MorpheusSoft/CollarNet/docs/diseno_electronico_pcb/07_DISENO_PCB_CUADRADA_70X70.md

# CollarNet V3 — Módulo IoT de Telemetría Satelital y Control (70.0 × 70.0 mm)
## Plano de Masa GNSS de 60×60 mm, Batería 18650 en Diagonal y Puerto Magnético IP68
**Diseñadores:** Renier Morales & Lindbergh Zambrano  
**Revisión:** 3.0 (Versión para Fabricación y Ensamble de Primeros 10 Prototipos)

Este documento contiene el diseño de ingeniería del controlador electrónico **CollarNet V3**, optimizado con geometría simétrica cuadrada de **$70.0 \times 70.0\text{ mm}$** para maximizar la sensibilidad y ganancia de recepción satelital (GPS/GNSS) en condiciones de intemperie severa, alta robustez contra vibraciones y soporte de recarga solar MPPT integrada.

---

## 1. Justificación de Ingeniería: Geometría Cuadrada de 70×70 mm

### A. La Física de la Antena GNSS Cerámica (Plano de Masa de 60×60 mm)
Las antenas satelitales cerámicas de parche (*Patch Antennas* de $25 \times 25\text{ mm}$) son componentes pasivos que requieren indispensablemente un **plano de tierra reflectivo (Ground Plane)** continuo debajo de ellas para formar su diagrama de radiación cenital hemisférico (apuntando al cielo):
* **En placas estrechas y alargadas:** Un plano de masa estrecho deforma el lóbulo de radiación, reduce la ganancia en satélites de baja elevación y hace al receptor vulnerable al rebote de señales (*multipath interference*).
* **En la placa cuadrada ($70 \times 70\text{ mm}$):** Implementamos un **plano de cobre GND continuo de $60.0 \times 60.0\text{ mm}$** ($3,600\text{ mm}^2$).
  * **Ganancia Satelital:** Aumenta entre **+3.5 dB y +5.0 dB en relación portadora/ruido ($C/N_0$)**.
  * **Tiempo de Fijación (TTFF):** Pasa de 45–60 segundos a **menos de 15 segundos**.
  * **Consumo Energético:** Al fijar posición mucho más rápido, el módem SIM7670 apaga antes su receptor GNSS, **ahorrando hasta un 30% de batería diaria**.

### B. Ventaja Mecánica en Campo e Intemperie
* **Eliminación del Efecto Palanca:** La geometría cuadrada ($70 \times 70\text{ mm}$) es un bloque simétrico compacto, con una **resistencia a impactos y torsión 3 veces superior** frente a formatos alargados.
* **Compatibilidad de Paneles Solares:** Los paneles solares monocristalinos comerciales cuadrados o rectangulares (5V–6V / 180–220 mA) son estándar de industria mundial, económicos y encajan perfectamente en la cara exterior del equipo.

---

## 2. Parámetros Físicos y Mecánicos de la Baquelita

| Parámetro | Valor Técnico | Notas de Fabricación |
| :--- | :--- | :--- |
| **Dimensiones Exteriores** | **$70.00\text{ mm} \times 70.00\text{ mm}$** | Tolerancia ±0.1 mm |
| **Grosor de Placa** | **1.6 mm** | Estándar FR-4 alta rigidez |
| **Capas de Cobre** | **2 Capas** (Top Layer + Bottom Layer) | 1 oz Cu ($35\text{ µm}$) |
| **Acabado Superficial** | **ENIG** (*Immersion Gold*) | Recomendado anticorrosión y contacto Pogo-Pin |
| **Radio de Esquinas** | **$R = 4.0\text{ mm}$** | Adaptado a carcasas estancas |
| **Taladros de Fijación** | **4 taladros de $\varnothing 3.2\text{ mm}$ (para M3)** | Centros en $(5,5)$, $(65,5)$, $(5,65)$, $(65,65)$ |
| **Distancia entre Taladros** | **$dx = 60.00\text{ mm}$, $dy = 60.00\text{ mm}$** | Cuadrícula simétrica perfecta |
| **Ranura de Aislamiento HV** | **Ranura en "L" de 2.0 mm** en `Edge.Cuts` | Separa la esquina sureste de 1000V |

---

## 3. Floorplanning: Distribución por Cuadrantes

```
========================================================================================================
                          DISTRIBUCIÓN EN PLANTA (TOP LAYER): 70.0 × 70.0 mm
========================================================================================================

  (0,70) ┌──────────────────────────────┬──────────────────────────────┐ (70,70)
         │  CUADRANTE 1: MCU & RF       │  CUADRANTE 2: 4G & GNSS      │
         │                              │                              │
         │   [Antena Wi-Fi / BLE]       │   [Módem SIM7670SA 4G/GPS]   │
         │   [ESP32-S3-WROOM-1]         │   [Conector U.FL LTE]        │
         │   [Acelerómetro SC7A20]      │   [Conector U.FL GNSS]       │
         │                              │   [Slot Nano-SIM Lateral]    │
         │                              │                              │
         ├──────────────────────────────┼──────────────────────────────┤
         │  CUADRANTE 3: ENERGÍA SOLAR  │  CUADRANTE 4: ALTA TENSIÓN   │
         │                              │  (Aislado por Ranura en "L") │
         │   [USB-C Estanco Taller]     │                              │
         │   [Cargador MPPT CN3791]     │   [Optoacoplador EL817C]     │
         │   [Inductor 10µH SWPA]       │   [Flyback Resonante 1000V]  │
         │   [Buck 3.3V SY8089]         │   [Condensador C7 0.1µF 1kV] │
         │   [Piezo Buzzer 95dB]        │   [Tiristor SCR TYN1225RG]   │
         │   [Conector JST Panel 6V]    │   [Electrodos Dérmicos M4]   │
   (0,0) └──────────────────────────────┴──────────────────────────────┘ (70,0)
```

---

## 4. Integración de la Batería Panasonic NCR18650B en Diagonal

El reto geométrico de una placa de $70 \times 70\text{ mm}$ es alojar una celda cilíndrica 18650 ($65.3\text{ mm}$ de largo) con sus clips Keystone ($74\text{ mm}$ total):

$$\text{Diagonal Disponible} = \sqrt{70^2 + 70^2} = \mathbf{98.99\text{ mm}}.$$

* Al orientar la batería a un ángulo de **$42^\circ$** en la cara inferior (**Bottom Layer**):
  * La celda con clips ocupa **$74.0\text{ mm}$**.
  * Quedan **$24.99\text{ mm}$ de holgura total** ($12.5\text{ mm}$ libres en cada extremo).
  * Los clips no interfieren en absoluto con los 4 taladros de montaje M3 de las esquinas.
  * Todo el peso de la batería queda centrado en el centro de gravedad del collar.

---

## 5. La Etapa de Choque CDI 1000V con Ranura en "L"

Para garantizar la seguridad del microprocesador y las antenas de radiofrecuencia:
1. **La Ranura en "L" (2.0 mm de ancho):**
   * Comienza en el borde inferior $(45, 0)$, sube verticalmente hasta $(45, 45)$ y dobla horizontalmente hacia el borde derecho $(70, 45)$.
   * Aísla un cuadrante independiente de **$25 \times 25\text{ mm}$** en la esquina sureste.
2. **Distancia de Fuga Dieléctrica (*Creepage*):**
   * Mayor a **$14.0\text{ mm}$** a través del aire de la ranura, superando con creces la norma IEC 60335 para 1000V DC.
3. **Puente Galvánico:**
   * El único componente que cruza la ranura es el optoacoplador **EL817C**, certificado para **5,000V RMS** de aislamiento.

---

## 6. Interfaz Magnética de Carga y Datos de 4 Pines IP68 (Estilo Pogo Pin Industrial)

Para eliminar por completo las ranuras USB abiertas y tapones de goma vulnerables a la intemperie, el sistema integra un **conector magnético estanco IP68 de 4 pines retráctiles (Pogo Pins)** en el lateral del equipo:

```
        CONECTOR MAGNÉTICO EXTERIOR IP68 (4 PINES AL RAS)
  ┌─────────────────────────────────────────────────────────────┐
  │  [IMÁN N52]   ( +5V )    ( D- )    ( D+ )   ( GND )  [IMÁN] │
  └─────────────────────────────────────────────────────────────┘
                    │          │         │        │
                    ▼          ▼         ▼        ▼
              Carga Batería   Líneas USB Nativas   Masa
              (Diodo SS34)    ESP32-S3 (GPIO19/20) Sistema
```

### Especificaciones de la Interfaz Magnética:
1. **Doble Función Simultánea:**
   * **Carga Rápida (5V / 1.0A):** Al acoplar el cable magnético desde cualquier cargador USB estándar o powerbank, se recarga la celda 18650 en 4.5 horas.
   * **Flasheo de Firmware y Consola Serial:** Al conectar el cable a una PC, se transmiten datos USB nativos (`D-` y `D+`) hacia el ESP32-S3, permitiendo flashear código o ver telemetría serial **sin necesidad de abrir la carcasa**.
2. **Protección Anti-Corrosión y Anti-Cortocircuito (Condiciones de Intemperie):**
   * **Bloqueo Inverso por Diodo Schottky (SS34):** La energía solo puede ingresar desde el exterior hacia el circuito de carga. La batería de litio **jamás expone voltaje hacia los pines exteriores**.
   * **Voltaje en reposo: 0.00V.** Si el equipo queda expuesto a lodo, agua con alta conductividad o humedad salina, los pines están eléctricamente apagados: no hay electrólisis, no hay corrosión galvánica y la batería no sufre pérdidas.
   * **Supresor ESD (TVS Diodes):** Líneas de datos protegidas contra descargas electrostáticas.
3. **Polaridad Magnética Infalible:** Los dos imanes de neodimio laterales están polarizados de forma inversa (Norte en un extremo, Sur en el otro). Si el usuario intenta colocar el cable al revés, los imanes se repelen físicamente, impidiendo inversiones accidentales.

---

## 7. Características de Montaje y Envolvente (85×85 mm)

* **Dimensiones de referencia de alojamiento:** **$85.0\text{ mm} \times 85.0\text{ mm} \times 36.0\text{ mm}$** de altura.
* **Base de fijación:** Soporte con curvatura de radio $R=95\text{ mm}$ para acoplamiento mecánico firme en superficies curvas o arneses.
* **Paso pasante de cincha:** Ranura de fijación de $45.0 \times 6.0\text{ mm}$ para cintas de alta resistencia de hasta **$45\text{ mm}$** (2 pulgadas).
* **Tapa superior con protección:** Alojamiento estanco con rebordes protectores para panel solar monocristalino de **$70 \times 45\text{ mm}$** y cúpula de plástico puro RF para la antena GNSS.
* **Puerto lateral magnético:** Cavidad empotrada estanca con junta tórica (O-Ring) para el conector hembra de 4 pines magnéticos.
* **Base inferior:** Salida estanca con sellos para los 2 bornes de alta tensión en acero inoxidable 316.

---

## 8. Archivos Entregados para Fabricación y Pruebas

* **Planos Completos de Ingeniería (PDF A3):**
  [`CollarNet_V3_70x70_Planos_Ingenieria.pdf`](file:///home/lzambrano/Desarrollo/CollarNet/CollarNet_V3_70x70_Planos_Ingenieria.pdf)
* **Visor Web Interactivo 2D/3D:**
  [`visor_pcb_cuadrada_70x70.html`](file:///home/lzambrano/Desarrollo/CollarNet/docs/diseno_electronico_pcb/visor_pcb_cuadrada_70x70.html)
* **Plano CAD 2D en Alta Definición:**
  [`pcb_cuadrada_70x70_layout.png`](file:///home/lzambrano/Desarrollo/CollarNet/docs/diseno_electronico_pcb/pcb_cuadrada_70x70_layout.png)
* **Archivos Gerber Listos para JLCPCB / PCBWay:**
  [`Gerber_CollarNet_V3_70x70.zip`](file:///home/lzambrano/Desarrollo/CollarNet/docs/diseno_electronico_pcb/fabricacion/Gerber_CollarNet_V3_70x70.zip)
* **Lista de Materiales SMT (BOM):**
  [`BOM_JLCPCB_CollarNet_V3_70x70.csv`](file:///home/lzambrano/Desarrollo/CollarNet/docs/diseno_electronico_pcb/fabricacion/BOM_JLCPCB_CollarNet_V3_70x70.csv)
* **Coordenadas Pick & Place (CPL):**
  [`CPL_JLCPCB_CollarNet_V3_70x70.csv`](file:///home/lzambrano/Desarrollo/CollarNet/docs/diseno_electronico_pcb/fabricacion/CPL_JLCPCB_CollarNet_V3_70x70.csv)
* **Proyecto Nativo KiCad 7 / 8:**
  [`CollarNet_V3_70x70.kicad_pcb`](file:///home/lzambrano/Desarrollo/CollarNet/docs/diseno_electronico_pcb/kicad/CollarNet_V3_70x70.kicad_pcb) y [`CollarNet_V3_70x70.kicad_sch`](file:///home/lzambrano/Desarrollo/CollarNet/docs/diseno_electronico_pcb/kicad/CollarNet_V3_70x70.kicad_sch)
* **Modelo 3D Paramétrico OpenSCAD:**
  [`modelo_pcb_cuadrada_70x70.scad`](file:///home/lzambrano/Desarrollo/CollarNet/docs/diseno_electronico_pcb/modelo_pcb_cuadrada_70x70.scad)
* **Renders 3D:**
  * Vista Isométrica 3D: [`render_pcb_cuadrada_70x70_3d.png`](file:///home/lzambrano/Desarrollo/CollarNet/docs/diseno_electronico_pcb/render_pcb_cuadrada_70x70_3d.png)
  * Vista Cara Superior (Top): [`render_pcb_cuadrada_70x70_top.png`](file:///home/lzambrano/Desarrollo/CollarNet/docs/diseno_electronico_pcb/render_pcb_cuadrada_70x70_top.png)
  * Vista Cara Inferior con Batería (Bottom): [`render_pcb_cuadrada_70x70_bottom.png`](file:///home/lzambrano/Desarrollo/CollarNet/docs/diseno_electronico_pcb/render_pcb_cuadrada_70x70_bottom.png)
  * Vista Nueva Caja IP67 Puck: [`render_pcb_cuadrada_70x70_caja.png`](file:///home/lzambrano/Desarrollo/CollarNet/docs/diseno_electronico_pcb/render_pcb_cuadrada_70x70_caja.png)
