MorpheusSoft/CollarNet/diseno_halter_v2/placa_logica_3d.html

3D

# Baquelita Prototipo para Soldar a Mano (Solo 4 Módulos)

107.0 × 70.0 × 1.6 mm · Huecos Cuadrados 3×3 mm (DX=98, DY=61)

Únicamente: 1. ESP-32 · 2. SIM800L EVB · 3. ITG/MPU6050 · 4. GY-GPS6MV2 (NEO-6M)

🧩 Baquelita + 4 Módulos 🖨️ Solo Baquelita PETG (Para Imprimir)

Isométrica Cara Superior 🔥 Cara Inferior (Nombres de Pines + Soldadura) 🎯 Centrar

Componentes (4 Módulos) Ver todo

Pistas a Soldar a Mano Pistas: ON

Todas VIN (5V) 3.3V (Reg. U1) UART2 (GPS) UART (SIM800L) I2C (MPU6050)

Prototipo Soldado a Mano 107.0 × 70.0 × 1.6 mm

## Baquelita 107.0 × 70.0 × 1.6 mm

Diseñada exactamente según la tabla de cotas de la carcasa: 107.0 × 70.0 × 1.6 mm, 4 huecos cuadrados en las esquinas de 3.0 × 3.0 mm a 3.0 mm del borde (centros a 4.5 mm: DX = 98.0 mm, DY = 61.0 mm), nombres de pines grabados abajo y espigas guía de Ø 1.9 mm arriba.

Pines a Soldar por Debajo

🔥 Estaño Recomendado para PETG:

1. Ideal: Estaño de Baja Fusión Sn42/Bi58 (Bismuto, funde a 138 °C).

2. Estándar: Estaño con Plomo 63/37 o 60/40 fino (0.5 mm) con Flux (funde a 183 °C en 1 seg). ¡No usar estaño sin plomo!

🔧 Despiece 3D (Separar Módulos y Zócalos): 0%

🔍 Rayos X (Ver pistas a través): 0%

🏷️ Etiquetas: ON 🔄 Giro Auto: OFF
