MorpheusSoft/CollarNet/diseno_halter_v2/simulacion_encaje_logica_capsula.html

3D

# Simulación de Encaje 3D: Placa Lógica (107×70 mm) + Cápsula Izquierda (ZIP)

✅ ENCAJE VERIFICADO (DX=98, DY=61, Z=18.5 mm)

1. Cápsula Base ASA (4 Espigas 2.4×2.4mm) · 2. Baquelita PETG (4 Huecos 3.15×3.15mm) · 3. 4 Módulos · 4. Tapa Solar con 4 Pisadores

🔒 Placa Encajada + Tapa 📂 Abrir Tapa (Ver Adentro) 💥 Despiece Completo

Isométrica Planta (XY) Perfil Corte Z 🔎 Zoom Espiga Esquina 🎯 Centrar

Piezas del Ensamble Ver todas

👁️ Mostrar / Ocultar Capas:

🟧 Cápsula Base ASA (con 4 espigas) 🧢 Tapa Solar ASA (con 4 pisadores) 🩶 Baquelita PETG (107×70×1.6 mm) 🧩 4 Módulos (ESP32, SIM, GPS, MPU) ⚡ Pistas y 49 Pines Inferiores

🔒 Sistema 100% Sin Tornillos:

1. La placa baja y sus 4 huecos cuadrados (3.15 mm) entran en las 4 espigas cuadradas (2.40 mm) de la base.
2. La placa apoya en los 4 hombros a Z=18.5 mm.
3. Al cerrar la tapa, sus 4 columnas pisadoras (Z=20.4 mm) inmovilizan las esquinas desde arriba.

Simulación Exacta ZIP 107×70 mm en 114.8×70.8 mm

## Verificación de Encaje Milimétrico

1. Holguras en Plano X-Y ✅ ENTRA PERFECTO

Parámetro | Placa Lógica | Cápsula ZIP | Holgura
Largo (X) | 107.00 mm | 114.80 mm | +7.80 mm (+3.9/lado)
Ancho (Y) | 70.00 mm | 70.80 mm | +0.80 mm (+0.4/lado)
Centros DX | 98.00 mm | 98.00 mm | 0.00 mm (Exacto)
Centros DY | 61.00 mm | 61.00 mm | 0.00 mm (Exacto)
Espiga Esquina | Hueco 3.15mm | Espiga 2.40mm | +0.375 mm / lado

2. Alturas Verticales (Eje Z) ✅ +11.0 mm ARRIBA

Nivel Z (Base=0) | Cota (mm) | Holgura / Estado
Piso interior cápsula | Z = 10.50 | 100% liso y limpio
Puntas 49 pines abajo | Z = 16.30 | +5.80 mm sobre piso
4 Hombros esquina base | Z = 18.50 | Asiento de baquelita
Baquelita Gris (1.6mm) | 18.50 → 20.10 | A nivel pasacables (17)
4 Pisadores de Tapa | Z = 20.40 | +0.30 mm (prensado)
4 Espigas cuadradas | 18.50 → 23.50 | Entran en tapa hueca
Tope Módulos (ESP/SIM) | Z = 26.90 | +11.0 mm al techo
Techo interior Tapa ZIP | Z = 37.90 | Cúpula alta (14 mm)

🔒 14 Ganchos de Retención Snap-Fit (Punta Hendida):

Los 14 soportes de esquina tienen cabeza en flecha bifurcada (Ø2.84 mm con ranura elástica de 0.72 mm): al bajar cada módulo hace clic y queda bloqueado; para retirarlo basta apretar las dos puntas con los dedos. Además, se eliminó el roce tangencial de 0.10 mm en el SIM800L.

🔽 Levantar Placa: 0 mm

🧢 Abrir Tapa Solar: +14 mm

🩻 Rayos X Cápsula: 60%

🔧 Separar Módulos: 0%

🏷️ Cotas: ON 🔄 Giro: OFF
