MorpheusSoft/CollarNet/docs/diseno_electronico_pcb/visor_pcb_3d_interactivo.html

3D PCB CAD

# CollarNet V3 — Visor 3D Interactivo de Placa y Pistas (70.0 × 70.0 mm)

Inspección 360° | Pistas Top & Bottom | Plano Masa GNSS 60×60 mm | Batería 18650 | Renier Morales & Lindbergh Zambrano

🔍 Plano Maestro PCBA (Zoom 800%) 📥 Descargar Plano HD (5400px) 📄 Planos PDF (A3)

Perspectiva 3D Cara Superior (TOP) Cara Inferior (BOTTOM) Puerto Magnético IP68 Zona 1000V CDI 🔄 Auto-Giro Restaurar

Dimensiones: 70.0 × 70.0 × 1.6 mm • Masa GNSS: 60.0 × 60.0 mm (+4.5 dB) • Batería: NCR18650B (42° Diagonal) • Aislamiento: Ranura 2.0 mm (5,000V) • Interacción: Arrastrar para rotar | Rueda para zoom | Clic derecho para desplazar

Componentes (BOM) Capas y Pistas Redes y Señales
