MorpheusSoft/CollarNet/docs/diseno_electronico_pcb/visor_pcb_cuadrada_70x70.html

V3 IOT

# CollarNet V3 — Módulo IoT de Control & Telemetría (70.0 × 70.0 mm)

Plano de Masa RF 60×60 mm | Batería 18650 Diagonal | Puerto Magnético 4P IP68 | Renier Morales & Lindbergh Zambrano

Plano CAD 2D 3D Cara Superior 3D Cara Inferior (Batería 18650) Top Layer 2D Bottom Layer 2D

📥 Descargar Plano HD 📄 Planos PDF (A3)

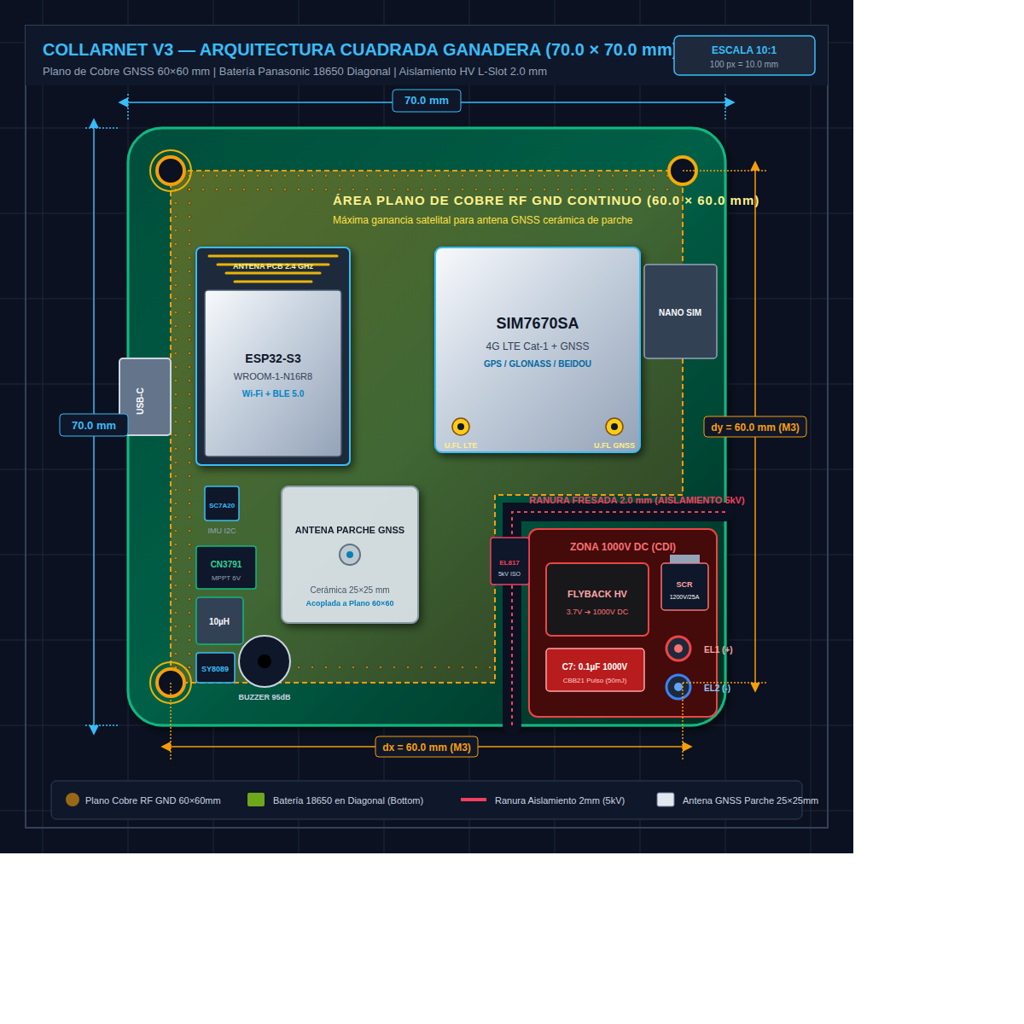
[picture p1: docs/diseno_electronico_pcb/pcb_cuadrada_70x70_layout.png]
Plano CAD Cuadrado


100%

+ Restaurar

### 🛰️ Plano de Masa GNSS 60×60mm

El plano de cobre continuo de 60.0 × 60.0 mm actúa como plano de tierra reflectivo para la antena cerámica de parche.

- Ganancia satelital: +4.5 dB C/N₀
- Fijación rápida TTFF: < 15 segundos
- Rechazo de señales rebotadas (Multipath).

### 🔋 Batería Panasonic 18650

Montada en la cara inferior orientada a 42° en diagonal:

- Diagonal disponible en PCB: 98.9 mm
- Largo celda + clips: 74.0 mm
- Margen a los taladros M3: > 12 mm libres
- Capacidad: 3,400 mAh (10 a 17 días sin sol)

### ⚡ Aislamiento Ranura en "L"

Ranura fresada pasante de 2.0 mm en capa Edge.Cuts:

- Aísla el cuadrante sureste de 1000V DC
- Distancia de fuga dieléctrica: > 12 mm
- Optoacoplador EL817C (5kV) de enlace

### 🔌 Puerto Magnético IP68 (4 Pines)

Conector magnético Pogo-Pin industrial en lateral:

- Carga externa (5V/1A): Recarga completa en 4.5 horas.
- Firmware USB Directo: Pines D- y D+ conectados a ESP32-S3 (GPIO19/20).
- Protección Intemperie: Diodo SS34 garantiza 0.00V en reposo (inmune a barro, agua salina y humedad).
- Imanes N52 Polarizados: Impiden conexión invertida.

### 👨‍💻 Diseñadores del Hardware

Renier Morales & Lindbergh Zambrano

- Revisión oficial: V3.0 (Lote de 10 Prototipos)
- Fabricación recomendada: FR-4 / 2 Capas / ENIG Gold
- Norma dieléctrica: IPC-2221 / IEC 60664-1 (5kV)
