MorpheusSoft/CollarNet/docs/diseno_electronico_pcb/visor_cad_esquematico_y_pcb.html

CowAI CAD

# CollarNet V2 — Visor de Ingeniería (Esquemático y PCB)

ESP32-S3 | 4G LTE SIM7670SA | MPPT CN3791 | Choque CDI 1000V con Watchdog Hardware 1s

Vistas de Ingeniería Oficial:

Esquemático Completo AIO PCB Layout Completo (Top+Bottom) Cara Superior (Top Layer) Cara Inferior (Bottom Layer)

📥 Descargar PDF Planos A3 (4 Láminas) 📦 Descargar Gerbers (ZIP) ⚙️ Guía JLCPCB / EasyEDA

Plano CAD

100%

+ Restaurar
