MorpheusSoft/CollarNet/docs/diseno_electronico_pcb/visor_comparativa_opcion1_opcion2.html

JLCPCB SMT OPTIMIZED

# CollarNet / CowAI V2 | Diseño de PCB

Comparativa de Optimización Espacial: Opción 1 (Modular en 2 Diagramas: Externo vs Circuito) vs Opción 2 (Monolítica Integrada con Portapilas 110.6×33.1mm)

Opción 1: Diagrama Externo Opción 1: Circuito PCB Opción 2: Placa Única + Batería Renders 3D Reales Tabla de Decisión

OPCIÓN 1: DIAGRAMA DE COMPONENTES EXTERNOS, PERIFÉRICOS Y ARNÉS DORSAL

Haz clic en cualquier bloque para inspeccionar pines y especificaciones

DIMENSIONES NORMALIZADAS: 110.6 × 33.1 mm (Compatible caja_lilygo_t7670x.scad)

Cara Superior (TOP) Cara Inferior (BOTTOM · Portapilas)

#### 1. Renders Técnicos CAD OpenSCAD (Generados Directamente desde modelo_pcb_3d.scad)

Opción 1: Modular (Lógica + Potencia)

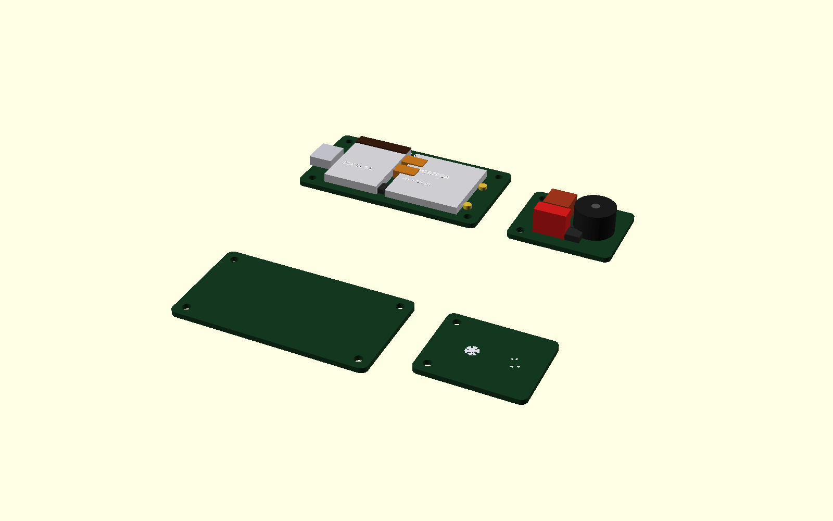
[picture p2: docs/diseno_electronico_pcb/render_cad_opcion1_modular.png]
Render CAD Opción 1


Placas separadas de 60×32 mm y 32×26 mm con conectores J5 y J6.

Opción 2: Monolítica All-In-One

Render CAD Opción 2

Placa única de 110.6×33.1 mm con celda 18650 integrada y ranura de 2mm.

Comparativa de Tamaño Directa

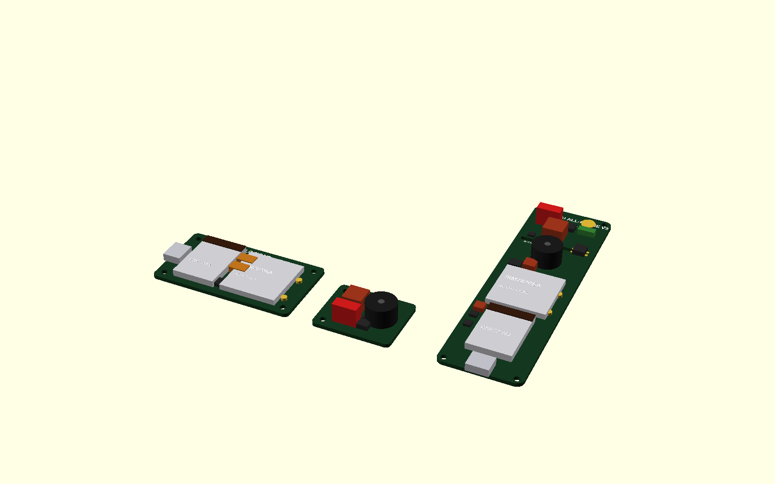
[picture p3: docs/diseno_electronico_pcb/render_cad_comparativa_ambas.png]
Render Comparativa


Escala 1:1 lado a lado demostrando la compacidad de ambas arquitecturas.

#### 2. Renders Fotorrealistas de Integración Física

OPCIÓN 1: ARQUITECTURA MODULAR (2 BOARDS) Halter V2 Style

Render Opción 1 Modular

Se observa a la izquierda la Placa Lógica y RF (60×32mm) con ESP32-S3 y SIM7670, y a la derecha la Placa de Potencia (32×26mm) con el buzzer y circuito CDI. En el centro, el arnés dorsal flexible de 5 conductores de baja tensión y los componentes externos (paneles solares, celda 21700 y electrodos de cuello).

OPCIÓN 2: PLACA ÚNICA MONOLÍTICA INTEGRADA All-in-One IP67

Render Opción 2 Monolítica

Se observa la placa continua de 110.6×33.1mm con el portapilas cilíndrico para batería 18650 / 21700 soldado en la cara inferior. A la izquierda la zona de cómputo y módem 4G/GPS, y a la derecha el circuito de alta tensión disuasorio aislado por la ranura de fresado de 2.0 mm con los bornes de electrodos de acero inoxidable.

Criterio de Evaluación | Opción 1: Modular (2 Placas + Arnés) | Opción 2: Monolítica All-In-One (Con Portapilas) | Veredicto de Ingeniería
Superficie Total de PCB | 27.5 cm² (Lógica: 19.2 cm² + Potencia: 8.3 cm²) | 36.6 cm² (Placa única: 11.06 × 3.31 cm) | Gana Opción 1 (25% menos cobre)
Integración de la Batería | Batería externa 21700 en su propia cuna con cable JST | Base/clips portapilas soldados directamente a la PCB | Gana Opción 2 (Cero cables sueltos)
Cableado y Soldadura Manual | Requiere soldar 5 hilos del arnés dorsal en taller (J5 ↔ J6) | CERO cables internos entre placas | Gana Opción 2 (Ahorra 15 min de taller)
Riesgo Mecánico en Campo | Riesgo de fatiga o corte del arnés dorsal en matorrales | Todo el circuito está dentro de una sola carcasa rígida | Gana Opción 2 (Mayor vida útil)
Aislamiento de Choque (1000V) | Aislamiento Físico Total (15 cm de separación en aire) | Aislamiento por Ranura Fresada de 2.0 mm + Optoacoplador 5kV | Gana Opción 1 (Cero ruido EMC en GPS)
Balance de Peso en el Animal | Simétrico: Batería a la derecha equilibra RF a la izquierda | Todo el peso (135g) en un solo punto ventral o dorsal | Gana Opción 1 (No gira en el cuello)
Costo de Fabricación SMT (JLCPCB) | Requiere 2 montajes SMT distintos (o panelizado) | 1 sola orden SMT: los robots montan todo de una vez | Gana Opción 2 (~$3.50 USD menos por unidad)
Carcasa 3D Compatible | `diseno_halter_v2`: Puente dorsal + 2 cápsulas | `caja_3d/caja_lilygo_t7670x.scad`: Caja unificada IP67 | Ambas tienen su modelo 3D listo en el repo

INSPECTOR TÉCNICO

### Selecciona un Componente

CLICK EN EL DIAGRAMA

Modelo / Part Number:

ESP32-S3 / SIM7670 / CN3791 / SY8089

Especificación Eléctrica:

Ver parámetros en tiempo real

Función en el Sistema:

Haz clic sobre cualquier chip, módulo, conector o terminal en cualquiera de los diagramas para consultar su código LCSC, pines, tensión de operación y función en el collar ganadero.

REGLAS DE MÁXIMA COMPACIDAD:

- Pasivos en encapsulado 0402 / 0603.
- SIM7670SA integra 4G LTE + GPS (ahorra 450 mm²).
- Montaje en doble cara (Portapilas 18650 en Bottom).
- Ranura pasante de 2mm para aislar 1000V.

CollarNet / CowAI V2 • Sistema de Pastoreo Virtual y Monitoreo IoT Bovino

Diseñado para Fabricación y Ensamblaje SMT en JLCPCB
