MorpheusSoft/CollarNet/diseno_halter_v2/visor_3d/index.html

C

# COWAI CollarNet V2.1 HALTER • 2-PCB SMT

Visualizador CAD 3D Interactivo • Arquitectura Dual-PCB, Cerca Virtual CDI y Espacio de Dispositivos

● 100% Cero Tornillos (Snap-Fit) ● Hermetismo IP67 Triple Sello ● Dual-PCB Custom (Lógica RF + Potencia CDI) Arnés 5P Baja Tensión (Z=17 mm)

☀️ 📸 ❓

🛠️ Herramientas de Inspección Mostrar Todo

💥 Vista Explotada (Despiece) 0%

▶ Animar Despiece

🩻 Rayos X (Transparencia Carcasas) 100%

📏 Cotas y Medidas 3D en Escena

🕸️ Modo Alámbrico (Mallas STL)

✂️ Plano de Corte Dinámico (Slicer)

Eje X (Long.) Eje Y (Transv.) Eje Z (Alt.)

Posición de Corte 0 mm

🔄 Invertir Dirección de Corte

Estructura y Puente Dorsal

Puente Dorsal TPU 95A

Solo 👁

Emblema 3D COWAI (Inlay)

Solo 👁

Cincha Ganadera (Opción A)

Solo 👁

Arnés 5 Hilos Baja Tensión

Solo 👁

Cápsula Derecha (Potencia & Estímulo CDI)

Cápsula Base Derecha (ASA)

Solo 👁

Batería Li-Ion 21700 + BMS 1S

Solo 👁

PCB Potencia & Pulso CDI (1kV)

Solo 👁

Zumbador Acústico 95dB (4kHz)

Solo 👁

2x Electrodos Cuello Inox M4

Solo 👁

Junta Tórica IP67 Der (TPU 85A)

Solo 👁

Tapa Solar Derecha (ASA)

Solo 👁

Panel Solar 2 RY9-414 (60x55)

Solo 👁

Cápsula Izquierda (Lógica, RF 4G & MPPT)

Cápsula Base Izquierda (ASA)

Solo 👁

PCB Lógica & RF V2 (60x32 mm)

Solo 👁

Antena GNSS Cerámica (Cielo)

Solo 👁

Antena 4G LTE FPC Adhesiva

Solo 👁

Junta Tórica IP67 Izq (TPU 85A)

Solo 👁

Tapa Solar Izquierda (ASA)

Solo 👁

Barra Difusora LED Estado

Solo 👁

Panel Solar 1 RY9-414 (60x55)

Solo 👁

📦 Dispositivos 📐 Ficha & PCBs 🔍 Inspector

⚡ Arquitectura Dual-PCB (EMC/EMI) + Triple Sello IP67

• Aislamiento Galvánico 5 kV: La alta tensión del pulso CDI (800–1000V) se genera exclusivamente en la Cápsula Derecha y jamás cruza el lomo ni interfiere con el módem 4G/GNSS.
• Triple Barrera IP67: Cuello TPU Ø12×2.2 mm comprimido 22.2% (ISO 3601), laberinto en U con junta tórica TPU 85A y cajera interior para Sikaflex 221.

PCB 1: Lógica, RF 4G/GNSS & MPPT

✅ SMT 60×32 mm

Eje | Placa PCBA | Cavidad Caja | Holgura Libre
Long. (X) | 60.0 mm | 70.0 mm | +10.0 mm
Ancho (Y) | 32.0 mm | 70.8 mm | +38.8 mm
Alto (Z) | 6.2 mm | 15.5 mm | +9.3 mm

Integra: MCU ESP32-S3-WROOM-1-N16R8, Módem SIM7670SA (4G LTE Cat-1 + GNSS), Cargador Solar MPPT CN3791 (6V 1.2A), Buck SY8089 (3.3V/2A), Acelerómetro SC7A20 (6 µA), 2× Tantalio 220µF, USB-C, Porta Nano-SIM (Bottom) y 2× IPEX 50Ω.

PCB 2: Potencia, Audio & Pulso CDI

✅ Aislada 5 kV

Eje | Placa PCBA | Bahía Caja | Holgura Libre
Long. (X) | 26.0 mm | 28.0 mm | +2.0 mm
Ancho (Y) | 32.0 mm | 34.0 mm | +2.0 mm
Alto (Z) | 9.1 mm | 15.5 mm | +6.4 mm

Integra: BMS 1S (DW01A+FS8205A+PPTC 3A), Driver Buzzer (AO3400A), Optoacoplador EL817C (5kV), Watchdog Hardware 1000ms (74LVC1G123), Bobina Flyback HV (800–1000V), Condensador CDI 0.1µF 1000V (0.05J), Tiristor SCR TYN1225RG y ranura fresada de 1.5 mm.

Batería Li-Ion 21700 (3.7V / BMS 1S)

✅ Holgura Óptima

Eje | Pack / Celda | Cavidad Caja | Holgura Libre
Long. (X) | 72.0 mm | 76.0 mm | +4.0 mm
Ancho (Y) | 65.4 mm | 70.0 mm | +4.6 mm
Alto (Z) | 21.2 mm | 24.0 mm | +2.8 mm

Admite desde 1 celda 21700 Grado A (5.000 mAh) hasta pack 1S3P (15.000 mAh) con espuma EVA de 1.5 mm anti-impacto y protección contra sobrecarga/descarga.

2× Electrodos Inox 316 M4 & Buzzer 95dB

✅ Sello O-Ring

Dispositivo | Medida Real | Alojamiento | Holgura / Sello
Electrodos (2×) | M4 × 21.5 mm | Pasamuros Ø4.2 | O-Ring EPDM Ø7.2
Buzzer 4000Hz | Ø12.4 × 8.0 mm | Cámara Ø12.8 | Cono Acústico 95dB

Los 2 pernos semiesféricos de acero inoxidable marino 316 salen por la base inferior en Y=72 mm (fuera del túnel de cincha de 52 mm) para contacto directo con el cuello.

Antena GNSS Patch + Antena 4G LTE FPC

✅ Doble Enlace RF

Antena | Dimensión | Alojamiento | Holgura Libre
GNSS Cerámica | 25.5 × 25.5 × 5.2 | Cuna 26 × 26 × 10 | +0.5 mm (Cenital)
4G LTE FPC | 40.0 × 13.0 × 1.2 | Pared Interior | Adhesiva 3M + IPEX

Ambas conectadas por cable coaxial de 50 Ω a los conectores u.FL/IPEX (J3 y J4) del módem SIM7670SA.

Paneles RY9-414 (×2), Cincha & Arnés 5P

✅ 100% Continuo

Elemento | Medida | Alojamiento | Holgura / Aislamiento
2× Paneles 6V | 60.0 × 55.0 × 2.2 | 61.0 × 56.0 × 2.2 | Flush-Mount Enrasado
Arnés 5 Hilos | Ø7.0 mm (AWG24/26) | Conducto Ø8.0 mm | Z=17 mm (<5V Baja T.)
Cincha Collar | 38 / 50 × 3.0 mm | Túnel 52 × 5.5 mm | Tabique 4.5 mm TPU

Los dos paneles solares alimentan al cargador MPPT CN3791 mediante diodos Schottky SS34 independientes (si un lado queda en sombra, el otro sigue cargando).

🔌 Arnés Dorsal de 5 Hilos (Conducto Ø8.0 mm en Z=17 mm)

Hilo | Red (Net) | Tensión | Función entre Cápsulas
1 | VBAT_PWR | 3.4–4.2V | Alimentación desde Batería 21700 + BMS
2 | GND_SYS | 0.0V | Masa común de baja tensión del sistema
3 | BUZZER_PWM | 3.3V PWM | Audio LEDC 4000 Hz desde ESP32 GPIO 5
4 | IMPULSE_TRIG | 3.3V (1s) | Disparo desde GPIO 4 hacia Optoacoplador
5 | SOLAR_DER_IN | 5.5–6.5V | Panel Solar Derecho hacia MPPT CN3791

🖥️ Especificaciones de Fabricación PCBA (JLCPCB / LCSC Rev 2.1)

PCB 1 (Cápsula Izquierda) | 60.0 × 32.0 × 1.6 mm (FR4 2L ENIG)
PCB 2 (Cápsula Derecha) | 26.0 × 32.0 × 1.6 mm (FR4 2L ENIG)
MCU Principal (U1) | ESP32-S3-WROOM-1-N16R8 (C2913202)
Módem 4G + GNSS (U2) | SIMCom SIM7670SA-MNGV (C2892994)
Acelerómetro 6µA (U3) | Silan SC7A20TR I2C (C392477)
Cargador Solar MPPT (U4) | Consonance CN3791 6V (C154992)
Regulador Buck 3.3V (U5) | Silergy SY8089AAAC 2A (C78988)
BMS Protección 1S (U6, U7) | DW01A + FS8205A + PPTC 3A
Aislamiento y Watchdog | EL817C (5kV) + 74LVC1G123 (1000ms)
Descarga Cerca Virtual CDI | 800–1000V / 0.05J (CBB21 0.1µF 1kV + SCR)

📐 Dimensiones Mecánicas Globales (CAD)

Envergadura Total Ensamble | 404.5 mm
Ancho Total Exterior | 83.6 mm
Altura Máxima en Cresta | 151.2 mm
Cápsula Unitaria (L × W × H) | 126.0 × 82.0 × 35.0 mm
Radio Anatómico Puente TPU | R = 125.0 mm (±32° caída)
Profundidad Cunas Snap-Fit | 35.0 mm (Pared TPU 2.8 mm)
Túnel Pasacorreas Continuo | 52.0 × 5.5 mm (Tabique 4.5 mm)
Compresión Cuello IP67 TPU | 0.4 mm (22.2% ISO 3601)

Haz clic en cualquier pieza o dispositivo del modelo 3D (o en la lista izquierda) para inspeccionar sus medidas, componentes SMT, código LCSC y holguras al detalle.

## 💡 Guía de Presentación del Diseño COWAI V2 (Rev 2.1)

✕

Este visualizador interactivo 3D muestra la arquitectura actualizada del collar inteligente COWAI CollarNet V2 (Rev 2.1) con sus dos placas PCBA de fabricación industrial SMT y sistema de cerca virtual seguro.

Actualizaciones Clave de los Dispositivos:

- 1. Cápsula Izquierda (Lógica, RF 4G/GNSS y Carga Solar MPPT): Aloja la PCB 1 (60×32 mm) con ESP32-S3-WROOM-1-N16R8, módem SIM7670SA, acelerómetro SC7A20 (6 µA), cargador solar MPPT CN3791, regulador Buck SY8089, antena GNSS cerámica cenital, antena 4G LTE FPC adhesiva y barra difusora LED de estado.
- 2. Cápsula Derecha (Potencia, Audio 95dB y Estímulo CDI): Aloja la Batería Li-Ion 21700, la PCB 2 (26×32 mm) con protección BMS 1S (DW01A+FS8205A), zumbador de 95 dB (4000 Hz), generador de pulso capacitivo CDI (800–1000V / 0.05J) aislado galvánicamente a 5 kV (EL817C) con Watchdog hardware de 1 segundo (74LVC1G123), y los 2 electrodos inferiores de acero inoxidable 316 M4.
- 3. Arnés Dorsal de 5 Hilos de Baja Tensión (<5V): Atraviesa el conducto estanco Ø8 mm en Z=17 mm llevando únicamente señales seguras (VBAT, GND, BUZZER_PWM, IMPULSE_TRIG, SOLAR_DER_IN), manteniendo cero alta tensión en el lomo del animal.
- 4. Vista Explotada y Rayos X: Usa los deslizadores del panel izquierdo para despiezar las tapas, juntas tóricas, paneles solares, PCBs y electrodos M4 en tiempo real.

Entendido
