MorpheusSoft/CollarNet/docs/diseno_electronico_pcb/visor_pcb_interactivo.html

# Visor Interactivo de PCB: CollarNet CowAI V2

Inspección de Cara Superior (TOP) e Inferior (BOTTOM) para Fabricación en JLCPCB

Cara Superior (TOP) Cara Inferior (BOTTOM) Ambas Caras Renders 3D Reales

VISTA ACTIVA: CARA SUPERIOR (COMPONENTES PRINCIPALES) Haz clic sobre cualquier chip para ver sus datos técnicos

### Cara Superior (TOP) - Vista Isométrica 3D

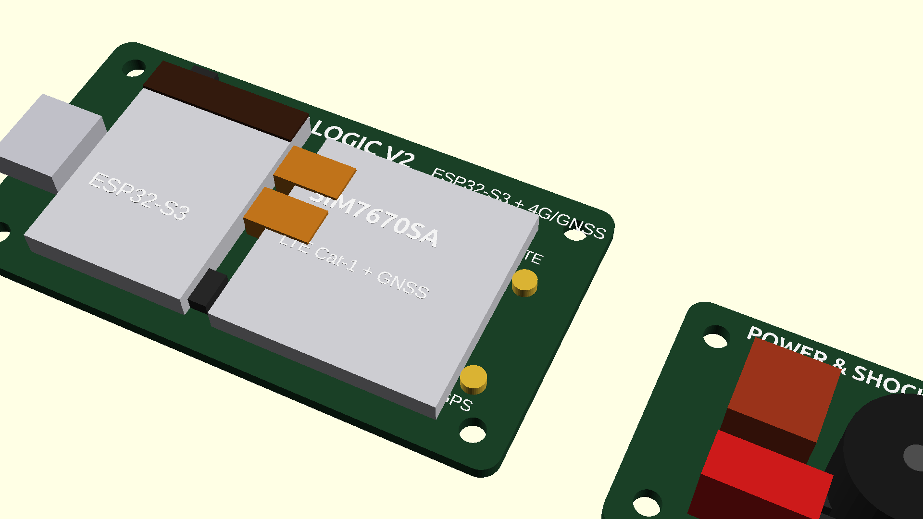
[picture p4: docs/diseno_electronico_pcb/render_pcb_cara_superior_top.png]
Render Cara Superior


### Cara Inferior (BOTTOM) - Vista Isométrica 3D

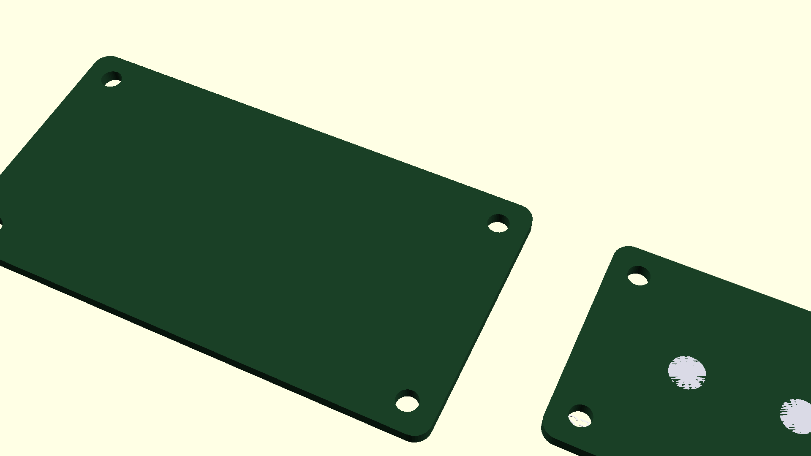
[picture p5: docs/diseno_electronico_pcb/render_pcb_cara_inferior_bottom.png]
Render Cara Inferior


### Ambas Caras Desplegadas (Ensamble Completo)

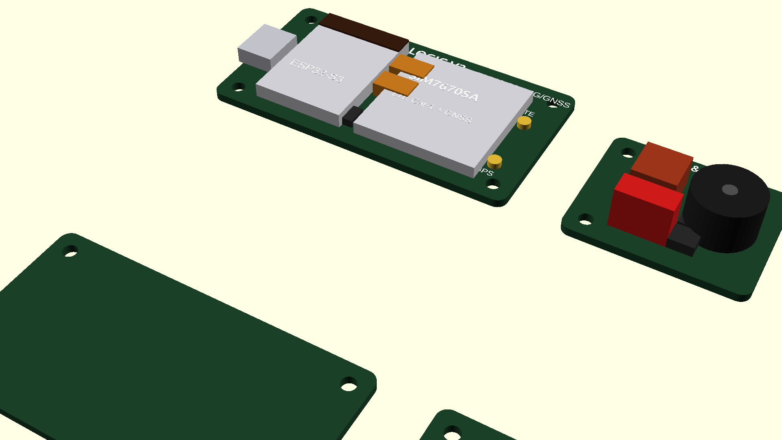
[picture p6: docs/diseno_electronico_pcb/render_pcb_ambas_caras.png]
Render Ambas Caras


U1

### ESP32-S3-WROOM-1-N8

Microcontrolador Dual Core 240MHz con 8MB Flash y USB nativo.

Ejecuta el firmware de geocercas, la máquina de estados de alertas y la pila MQTT.

Código JLCPCB / LCSC C2913200

💡 Cómo verlo en EasyEDA: Presiona Alt + D para activar la vista fotorrealista en 3D. Archivos guardados en: /docs/diseno_electronico_pcb/
