MorpheusSoft/CollarNet/backend/assets/standby_camera.jpg

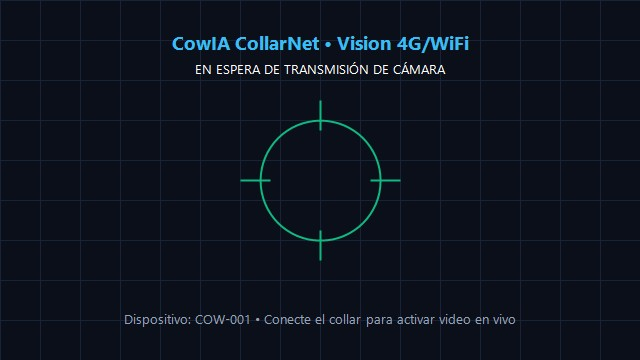
backend/assets/standby_camera.jpg
