MorpheusSoft/CollarNet/caja_3d/preview_base_interior.png

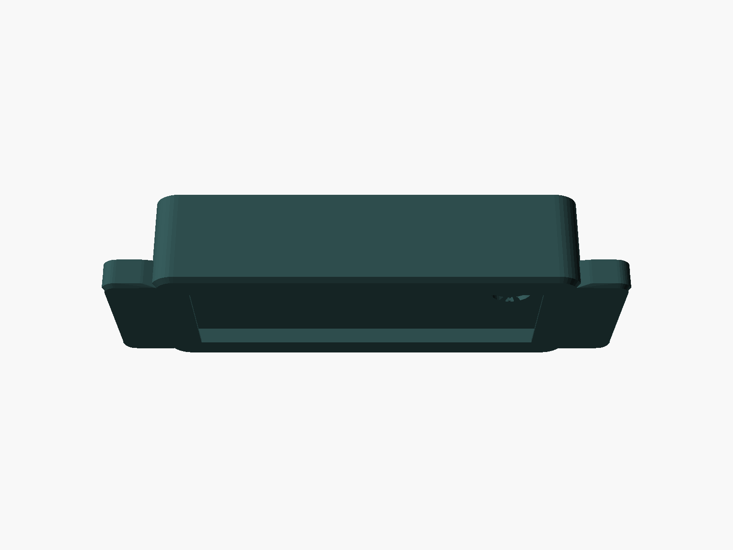
caja_3d/preview_base_interior.png
