MorpheusSoft/CollarNet/caja_3d/preview_base_interior_revc.png

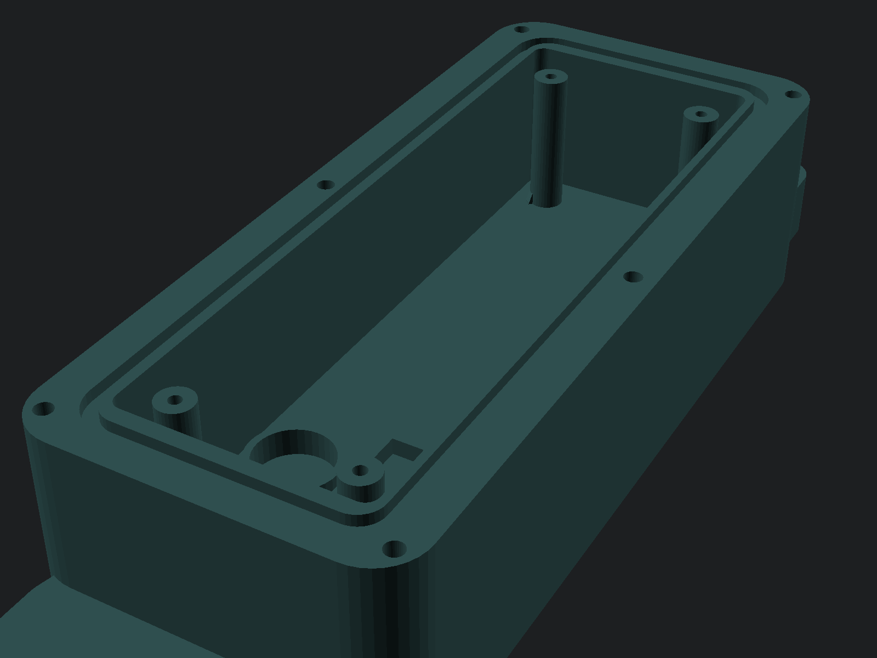
caja_3d/preview_base_interior_revc.png
