MorpheusSoft/CollarNet/caja_3d/preview_both_flat_revb.png

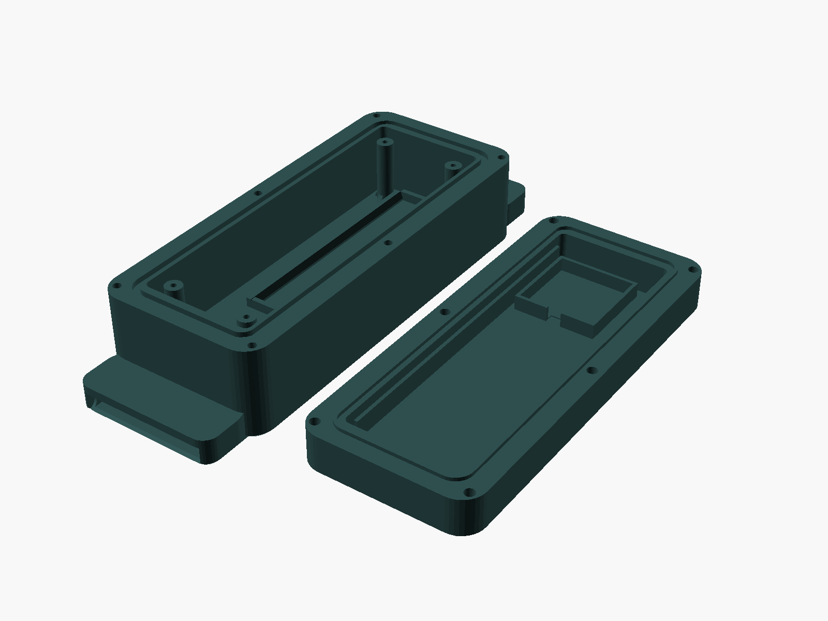
caja_3d/preview_both_flat_revb.png
