MorpheusSoft/CollarNet/caja_3d/preview_both_flat_revc.png

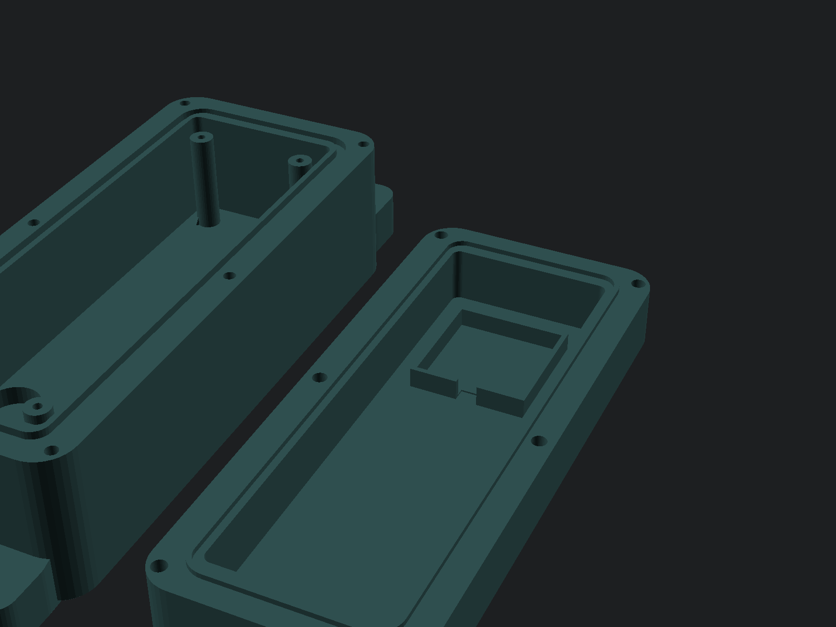
caja_3d/preview_both_flat_revc.png
