MorpheusSoft/CollarNet/caja_3d/preview_both_flat_verde.png

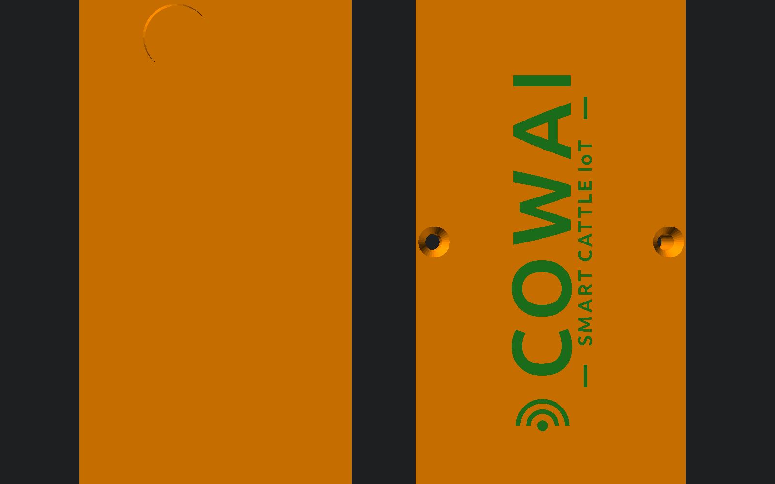
caja_3d/preview_both_flat_verde.png
