MorpheusSoft/CollarNet/caja_3d/preview_collar_tunnel.png

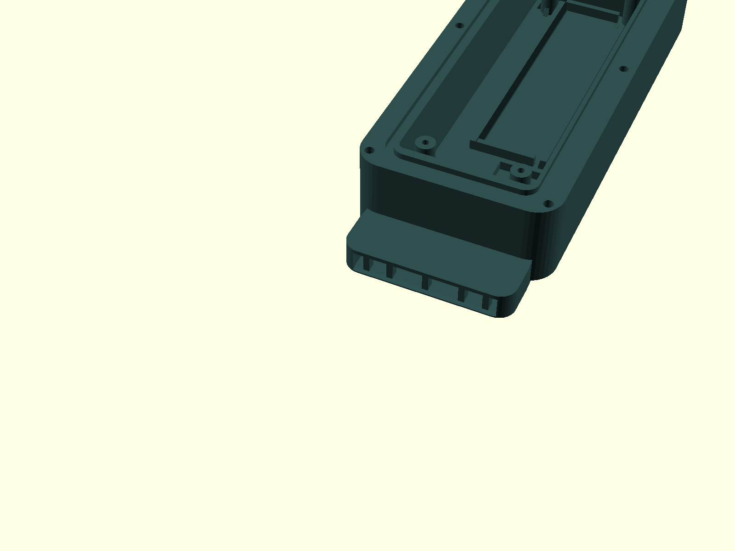
caja_3d/preview_collar_tunnel.png
