MorpheusSoft/CollarNet/caja_3d/preview_collar_tunnel_mouth.png

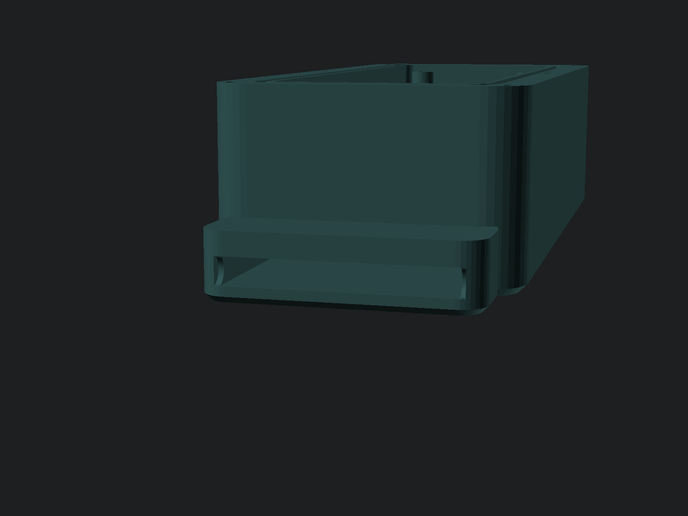
caja_3d/preview_collar_tunnel_mouth.png
