MorpheusSoft/CollarNet/caja_3d/preview_collar_tunnel_revc.png

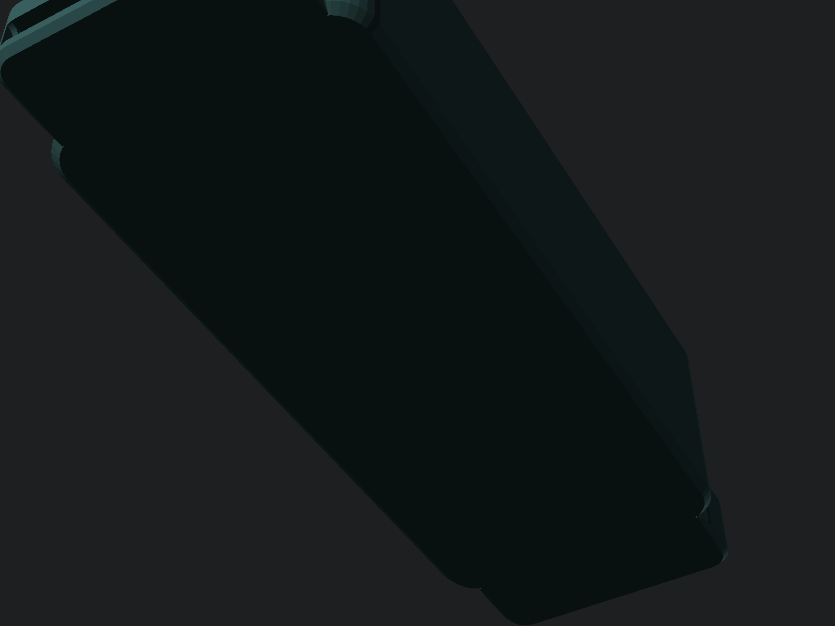
caja_3d/preview_collar_tunnel_revc.png
