MorpheusSoft/CollarNet/caja_3d/preview_conjunto_sujecion_38mm.png

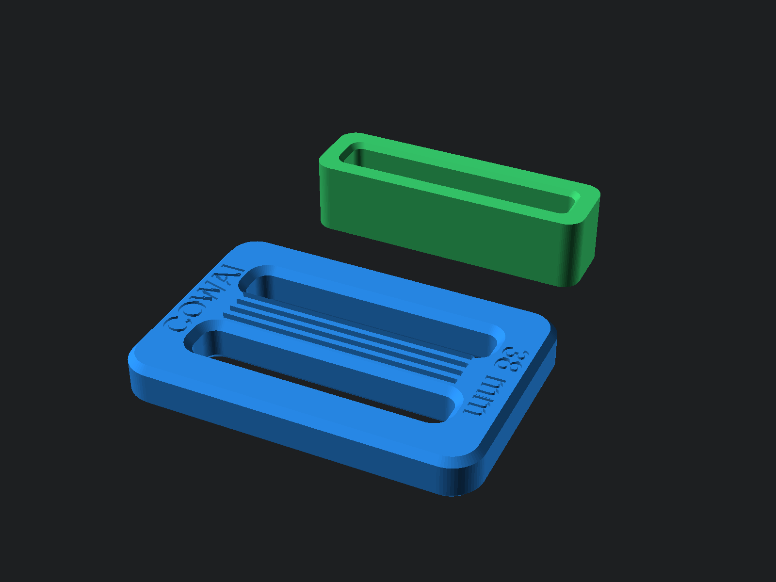
caja_3d/preview_conjunto_sujecion_38mm.png
