MorpheusSoft/CollarNet/caja_3d/preview_flat.png

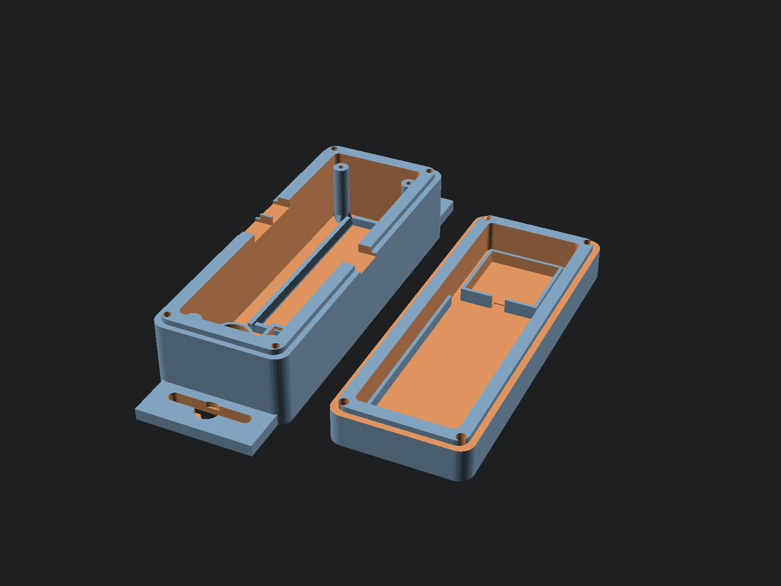
caja_3d/preview_flat.png
