MorpheusSoft/CollarNet/caja_3d/preview_hebilla_38mm.png

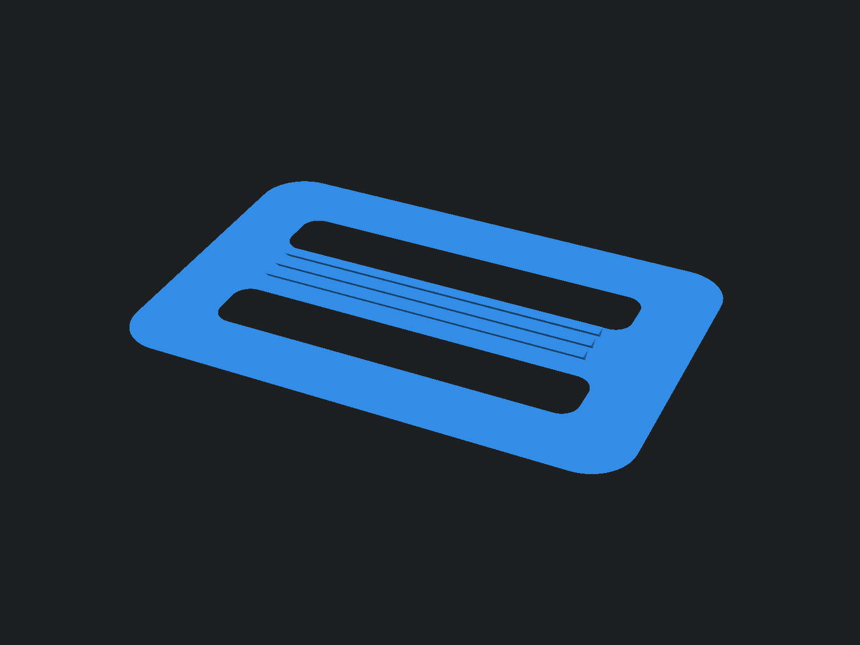
caja_3d/preview_hebilla_38mm.png
