MorpheusSoft/CollarNet/caja_3d/preview_ip67_base_interior.png

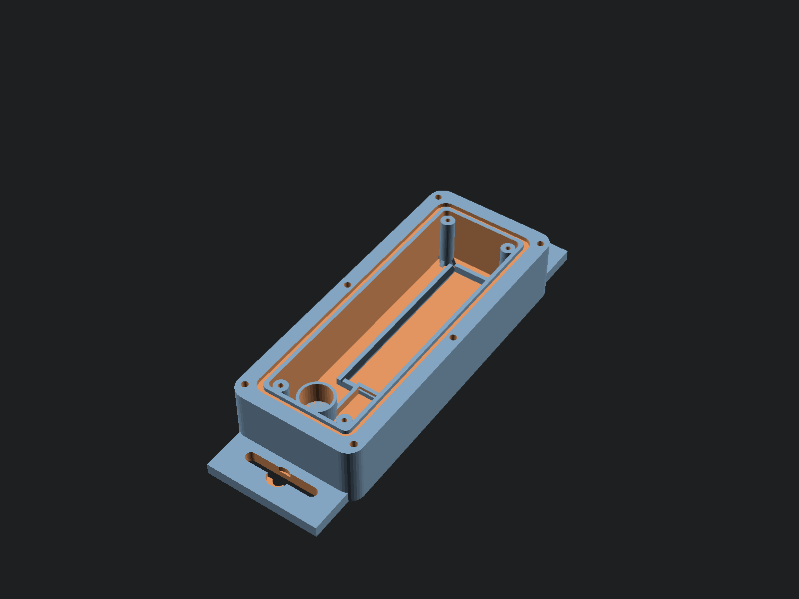
caja_3d/preview_ip67_base_interior.png
