MorpheusSoft/CollarNet/caja_3d/preview_ip67_tapa_corregida.png

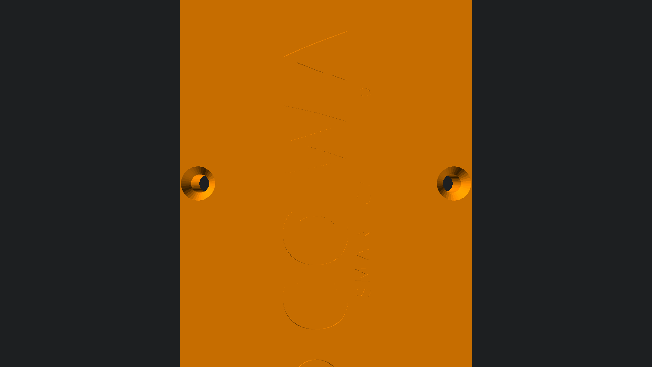
caja_3d/preview_ip67_tapa_corregida.png
