MorpheusSoft/CollarNet/caja_3d/preview_ip67_tapa_cowai.png

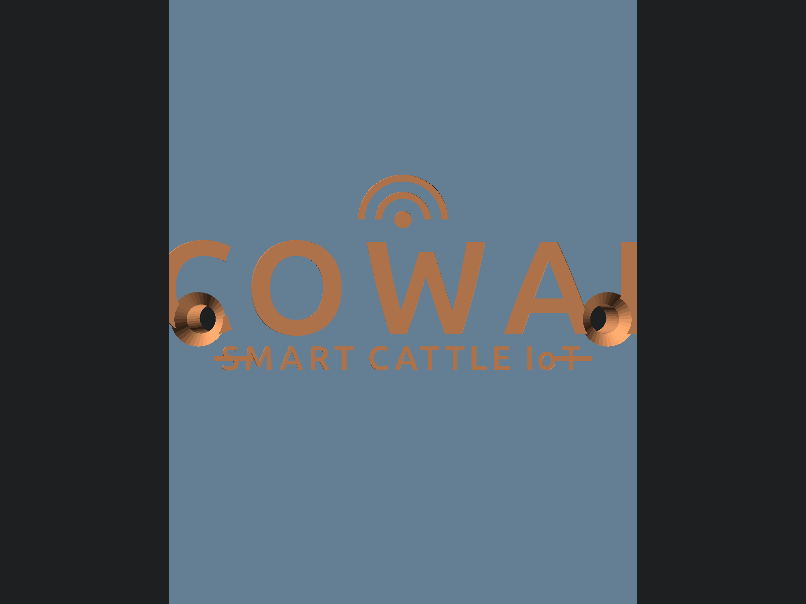
caja_3d/preview_ip67_tapa_cowai.png
