MorpheusSoft/CollarNet/caja_3d/preview_ip67_tapa_interior.png

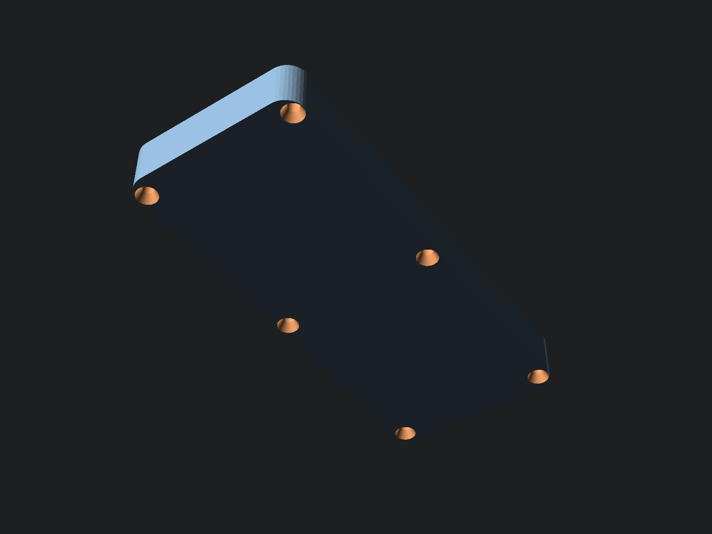
caja_3d/preview_ip67_tapa_interior.png
