MorpheusSoft/CollarNet/caja_3d/preview_junta_tpu.png

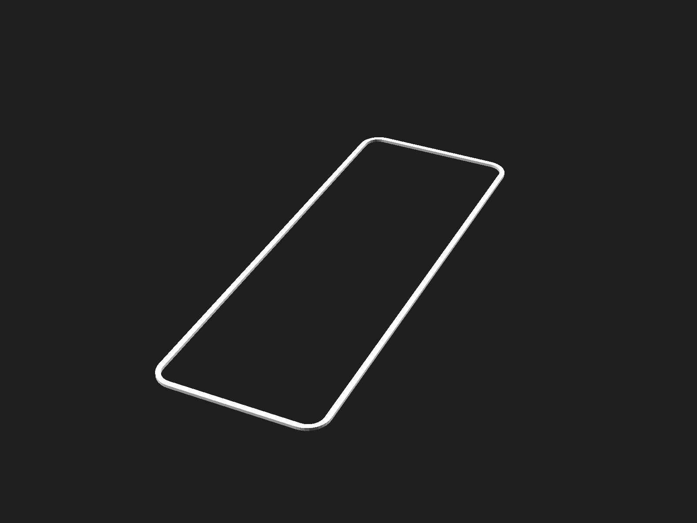
caja_3d/preview_junta_tpu.png
