MorpheusSoft/CollarNet/caja_3d/preview_tapa_interior.png

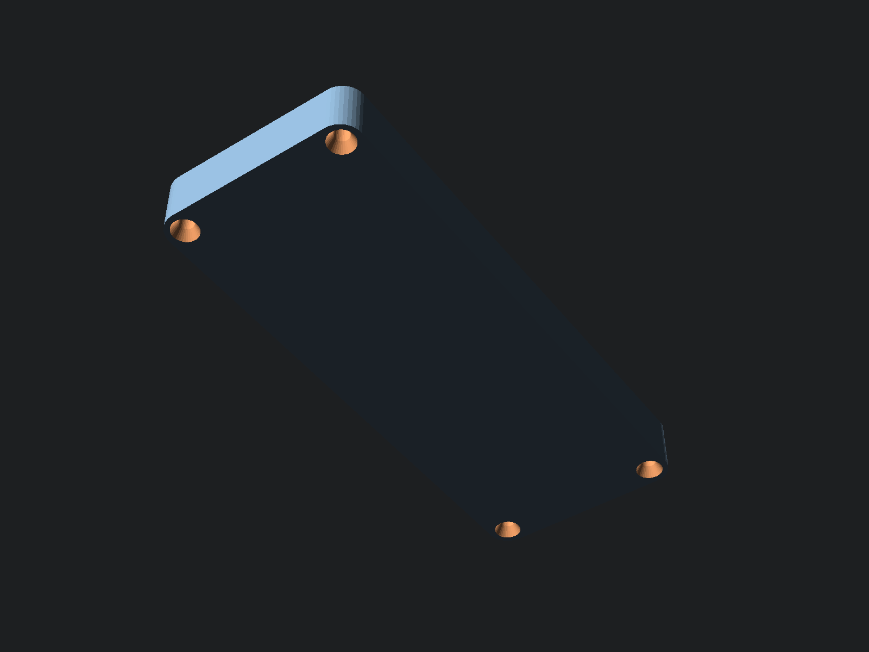
caja_3d/preview_tapa_interior.png
