MorpheusSoft/CollarNet/caja_3d/preview_tapa_interior_gps.png

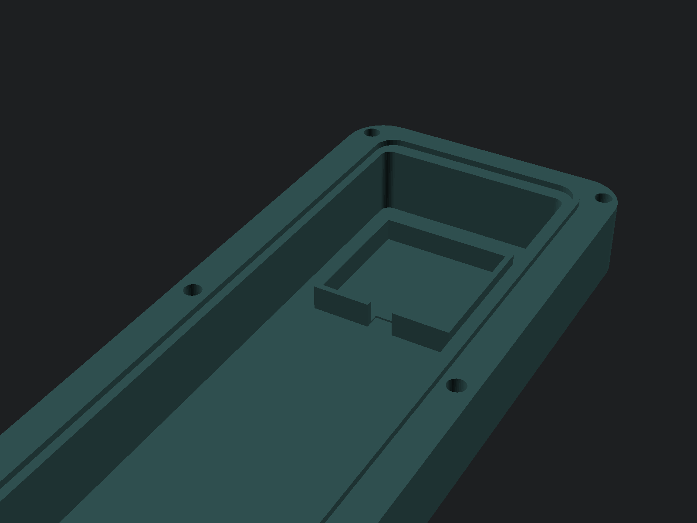
caja_3d/preview_tapa_interior_gps.png
