MorpheusSoft/CollarNet/diseno_halter_v2/renders/1_insercion_deslizante.png

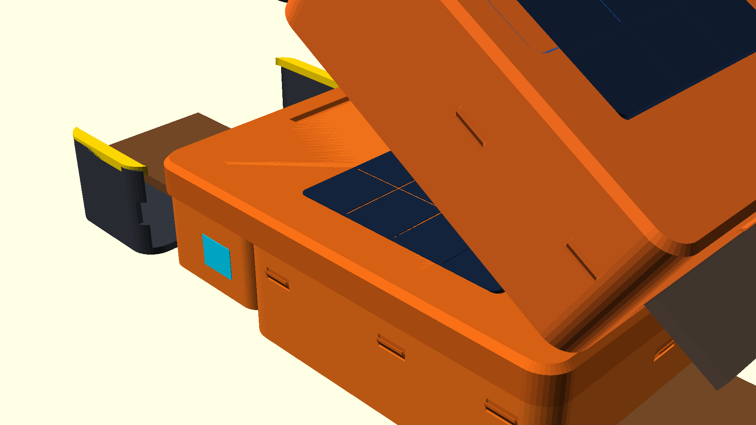
diseno_halter_v2/renders/1_insercion_deslizante.png
