MorpheusSoft/CollarNet/diseno_halter_v2/renders/2_corte_mecanismo.png

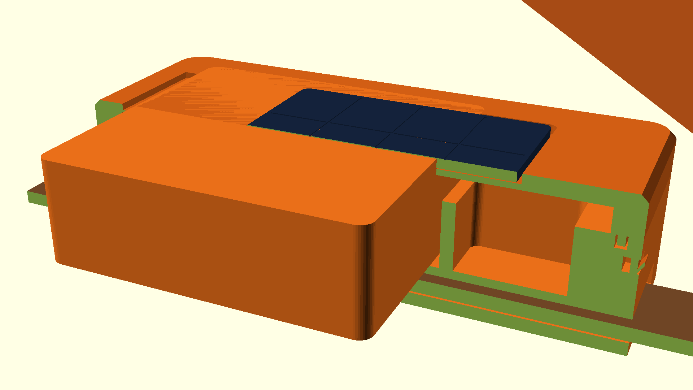
diseno_halter_v2/renders/2_corte_mecanismo.png
