MorpheusSoft/CollarNet/diseno_halter_v2/renders/2_vista_interior_socket_tpu.png

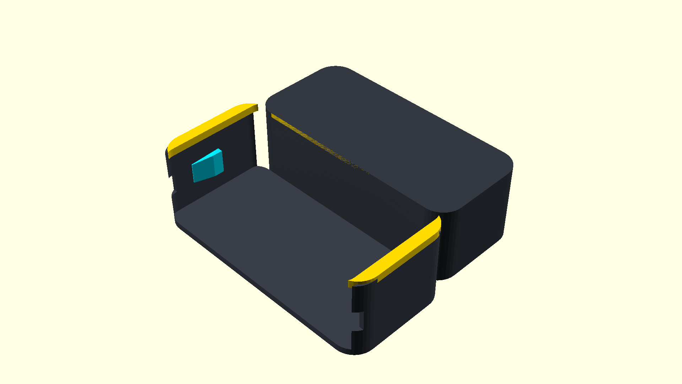
diseno_halter_v2/renders/2_vista_interior_socket_tpu.png
