MorpheusSoft/CollarNet/diseno_halter_v2/renders/3_collar_completo_vaca.png

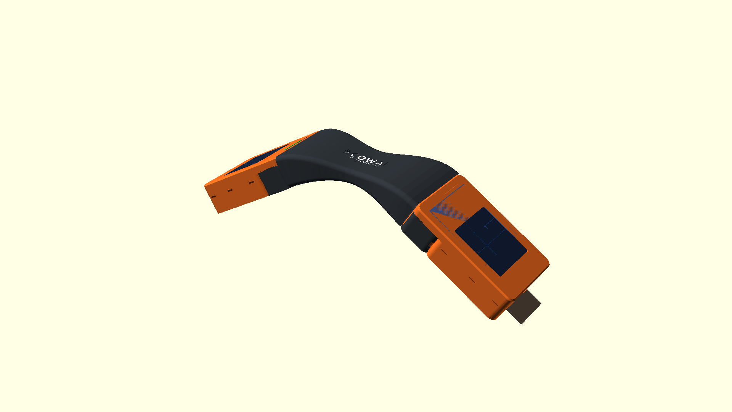
diseno_halter_v2/renders/3_collar_completo_vaca.png
