MorpheusSoft/CollarNet/diseno_halter_v2/renders/3_zoom_diente_click.png

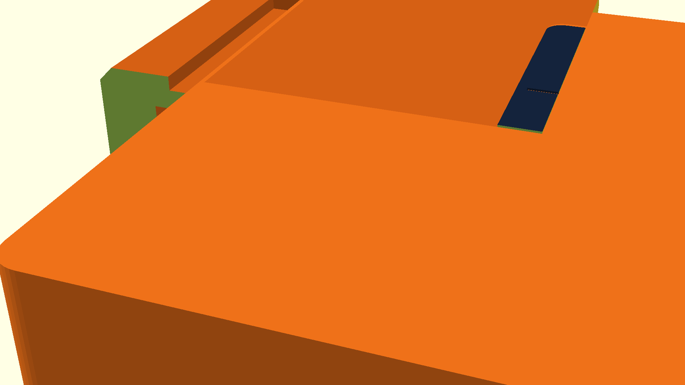
diseno_halter_v2/renders/3_zoom_diente_click.png
