MorpheusSoft/CollarNet/diseno_halter_v2/renders/4_comparativa_bolsillo_vs_funda.png

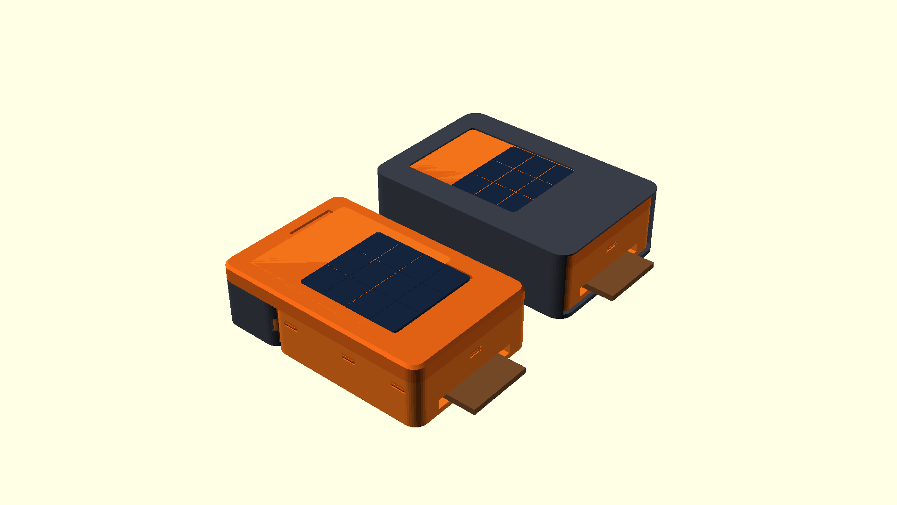
diseno_halter_v2/renders/4_comparativa_bolsillo_vs_funda.png
