MorpheusSoft/CollarNet/diseno_halter_v2/renders/4_comparativa_funda.png

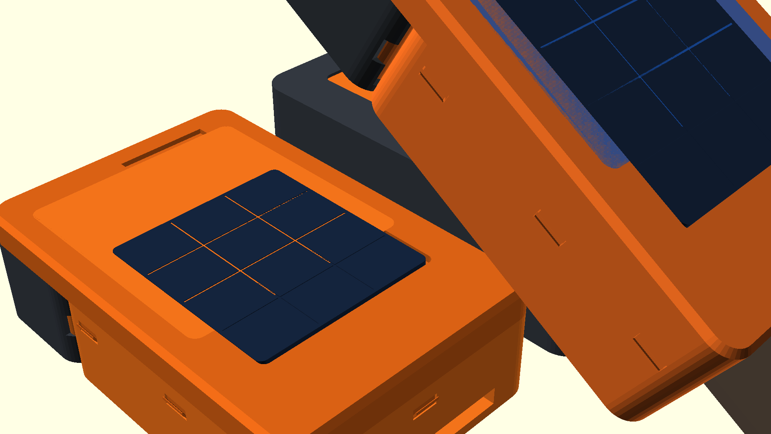
diseno_halter_v2/renders/4_comparativa_funda.png
