MorpheusSoft/CollarNet/diseno_halter_v2/renders/demo_click_ip67_explainer.png

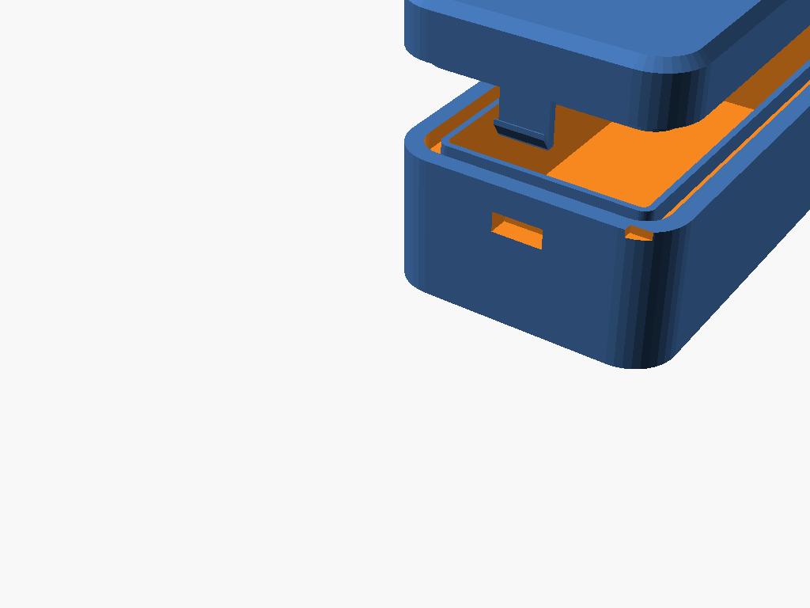
diseno_halter_v2/renders/demo_click_ip67_explainer.png
