MorpheusSoft/CollarNet/diseno_halter_v2/renders/presentacion_espacios_internos.png

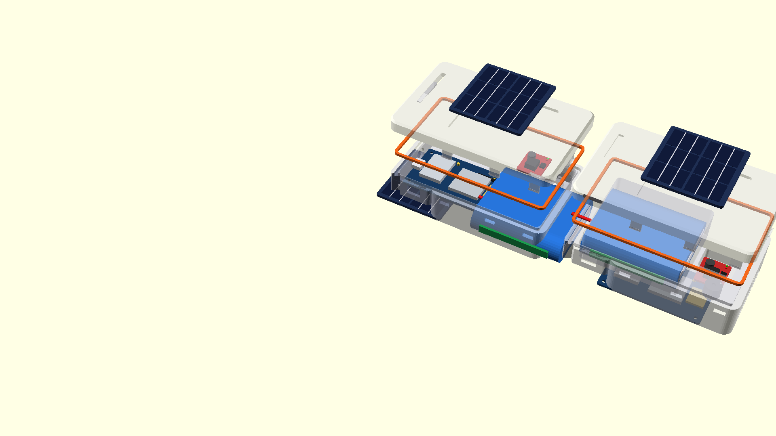
diseno_halter_v2/renders/presentacion_espacios_internos.png
