MorpheusSoft/CollarNet/diseno_halter_v2/renders/preview_bridge.png

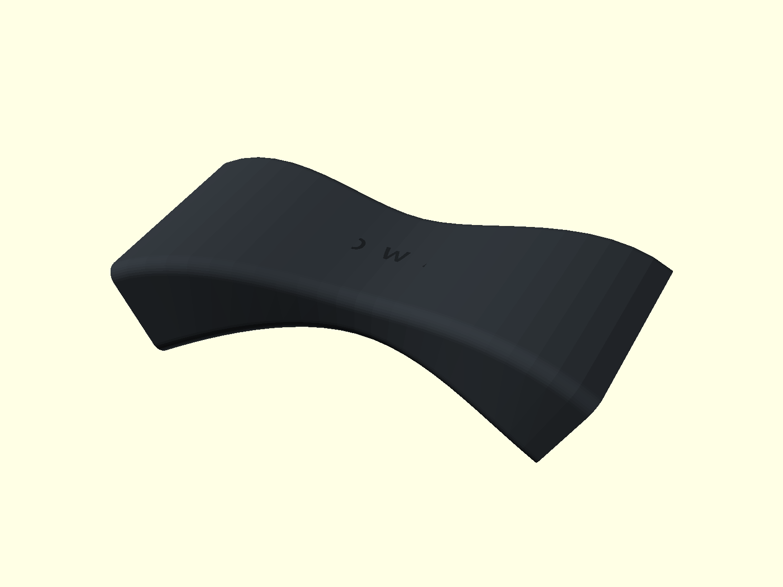
diseno_halter_v2/renders/preview_bridge.png
