MorpheusSoft/CollarNet/diseno_halter_v2/renders/preview_bridge_tpu_dark.png

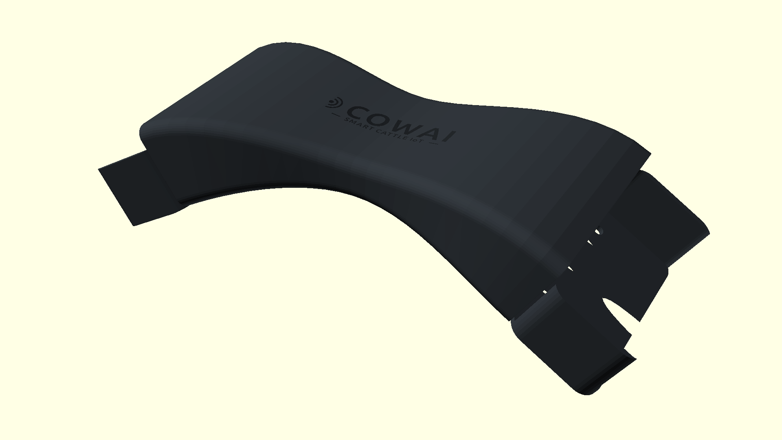
diseno_halter_v2/renders/preview_bridge_tpu_dark.png
