MorpheusSoft/CollarNet/diseno_halter_v2/renders/preview_grip_closeup.png

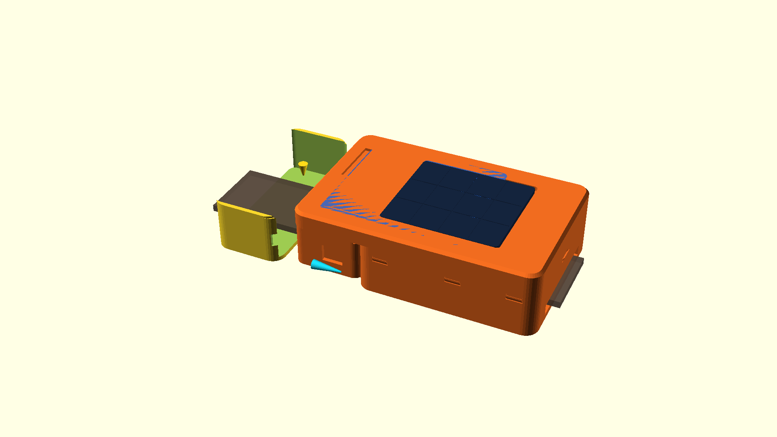
diseno_halter_v2/renders/preview_grip_closeup.png
