MorpheusSoft/CollarNet/diseno_halter_v2/renders/preview_grip_full_glove.png

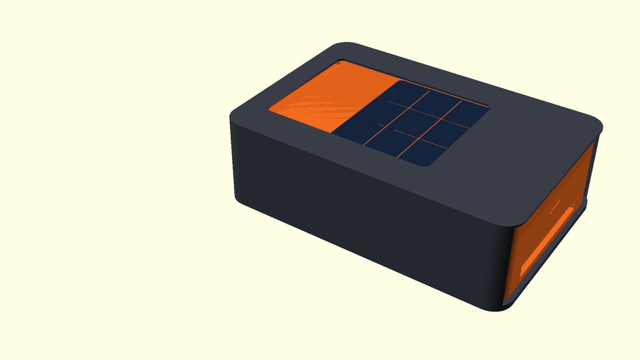
diseno_halter_v2/renders/preview_grip_full_glove.png
