MorpheusSoft/CollarNet/diseno_halter_v2/renders/preview_grip_internal_teeth.png

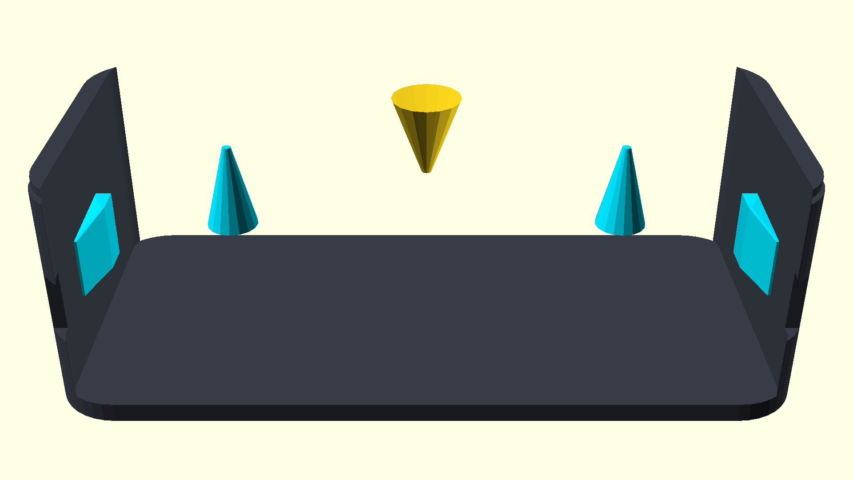
diseno_halter_v2/renders/preview_grip_internal_teeth.png
