MorpheusSoft/CollarNet/diseno_halter_v2/renders/preview_grip_section.png

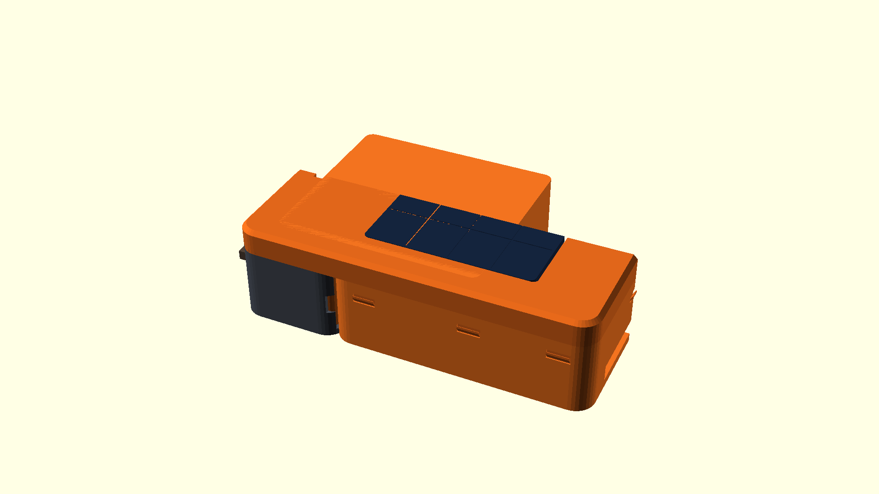
diseno_halter_v2/renders/preview_grip_section.png
