MorpheusSoft/CollarNet/diseno_halter_v2/renders/preview_halter_cornfield.png

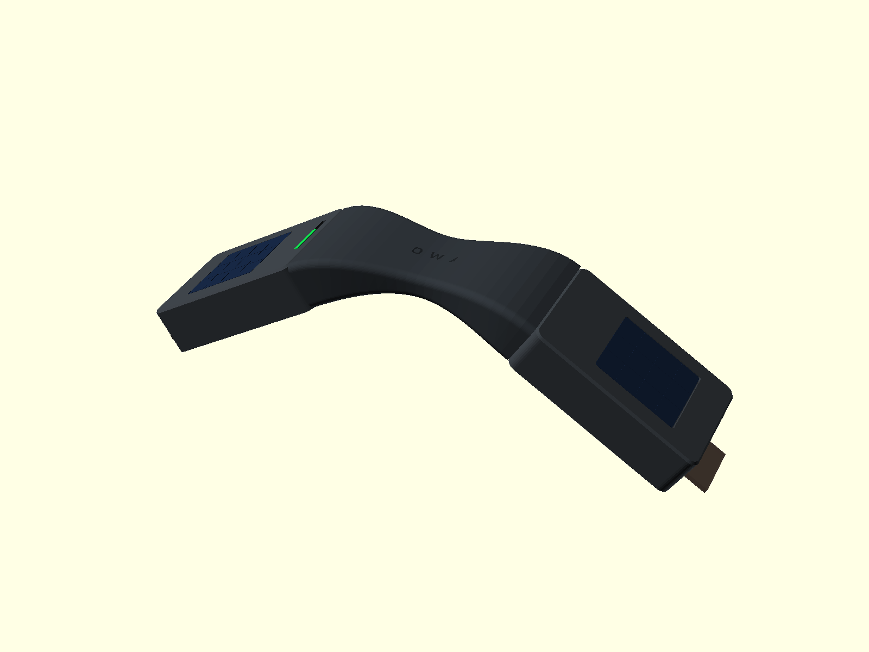
diseno_halter_v2/renders/preview_halter_cornfield.png
