MorpheusSoft/CollarNet/diseno_halter_v2/renders/preview_halter_front.png

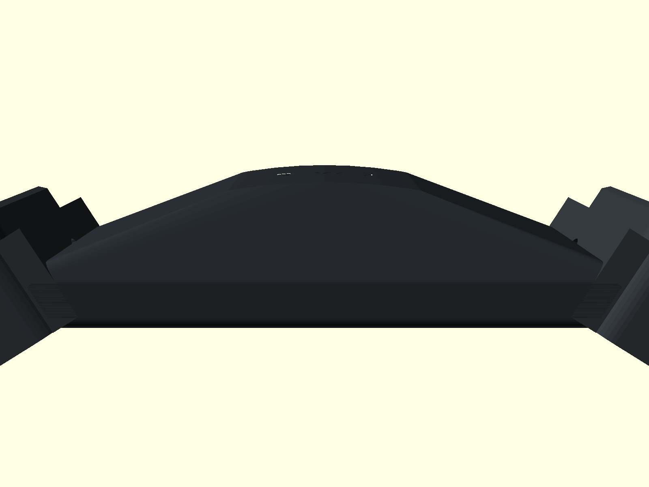
diseno_halter_v2/renders/preview_halter_front.png
