MorpheusSoft/CollarNet/diseno_halter_v2/renders/preview_halter_iso.png

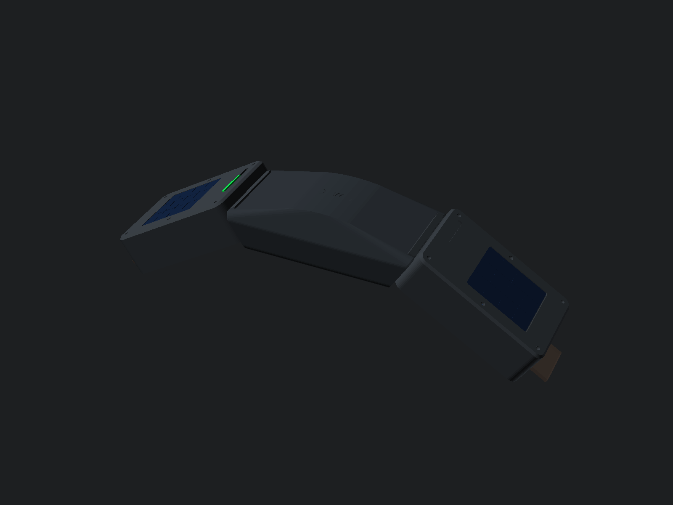
diseno_halter_v2/renders/preview_halter_iso.png
