MorpheusSoft/CollarNet/diseno_halter_v2/renders/preview_pod_clamshell_exploded.png

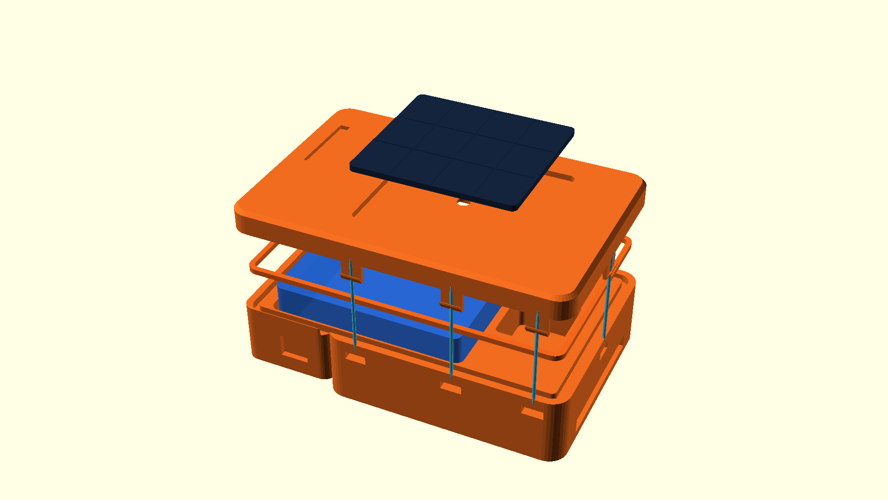
diseno_halter_v2/renders/preview_pod_clamshell_exploded.png
