MorpheusSoft/CollarNet/diseno_halter_v2/renders/preview_pod_left_base.png

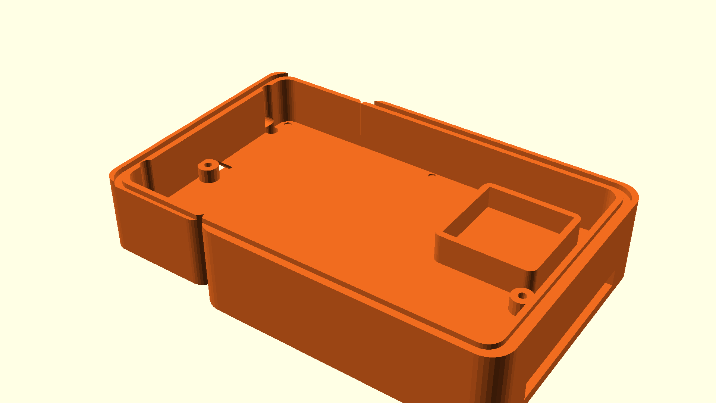
diseno_halter_v2/renders/preview_pod_left_base.png
