MorpheusSoft/CollarNet/diseno_halter_v2/renders/preview_probeta_acople_tpu.png

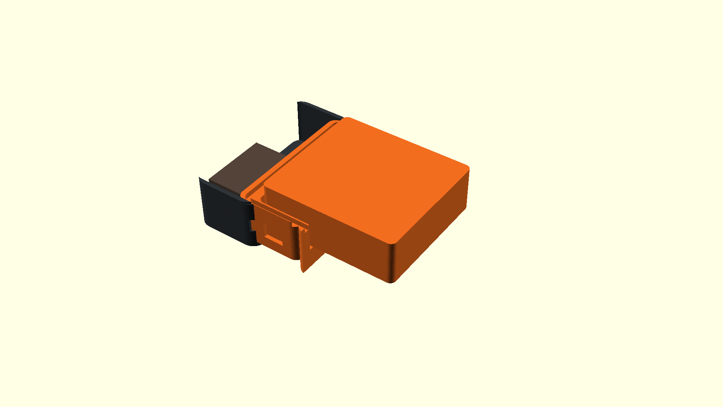
diseno_halter_v2/renders/preview_probeta_acople_tpu.png
