MorpheusSoft/CollarNet/diseno_halter_v2/renders/preview_probetas_prototipo_rapido.png

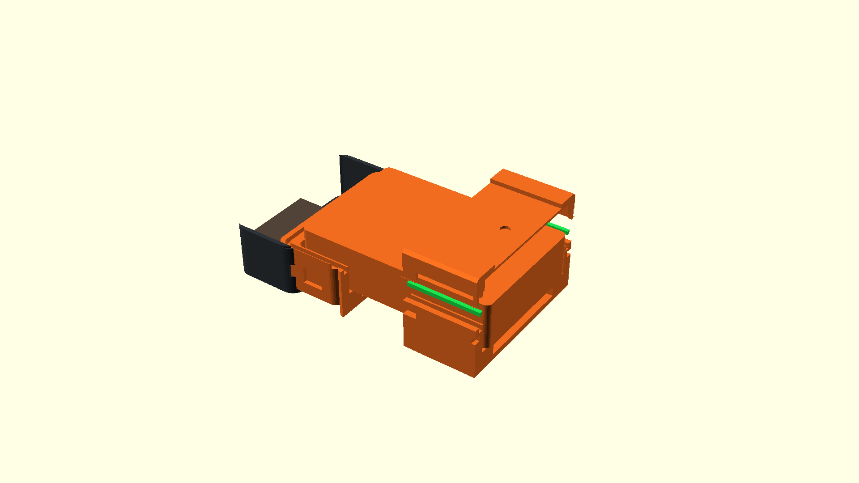
diseno_halter_v2/renders/preview_probetas_prototipo_rapido.png
