MorpheusSoft/CollarNet/diseno_halter_v2/renders/preview_snap_fit_angle.png

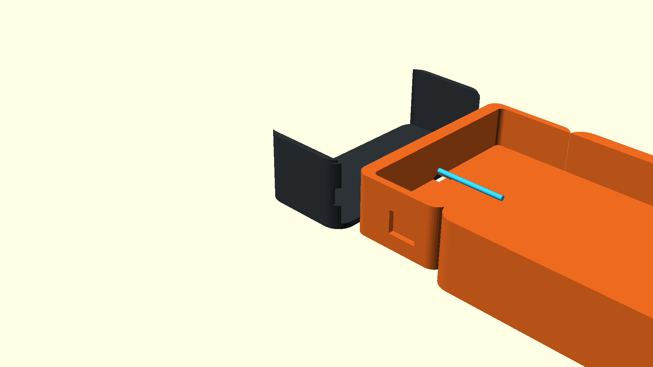
diseno_halter_v2/renders/preview_snap_fit_angle.png
