MorpheusSoft/CollarNet/diseno_halter_v2/renders/preview_snap_fit_click.png

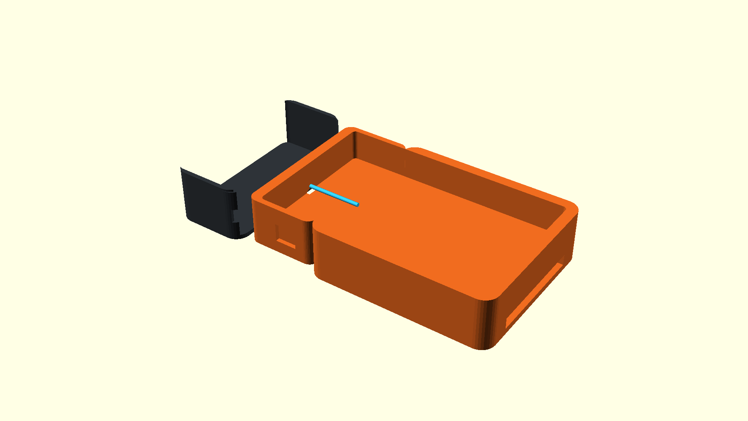
diseno_halter_v2/renders/preview_snap_fit_click.png
