MorpheusSoft/CollarNet/diseno_halter_v2/renders/preview_snap_fit_zoom.png

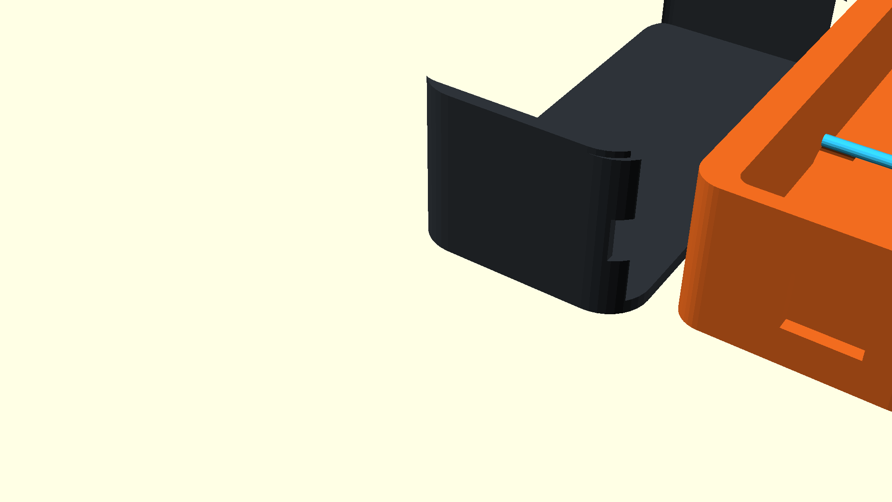
diseno_halter_v2/renders/preview_snap_fit_zoom.png
