MorpheusSoft/CollarNet/docs/diseno_electronico_pcb/esquematico_modular_logica.png

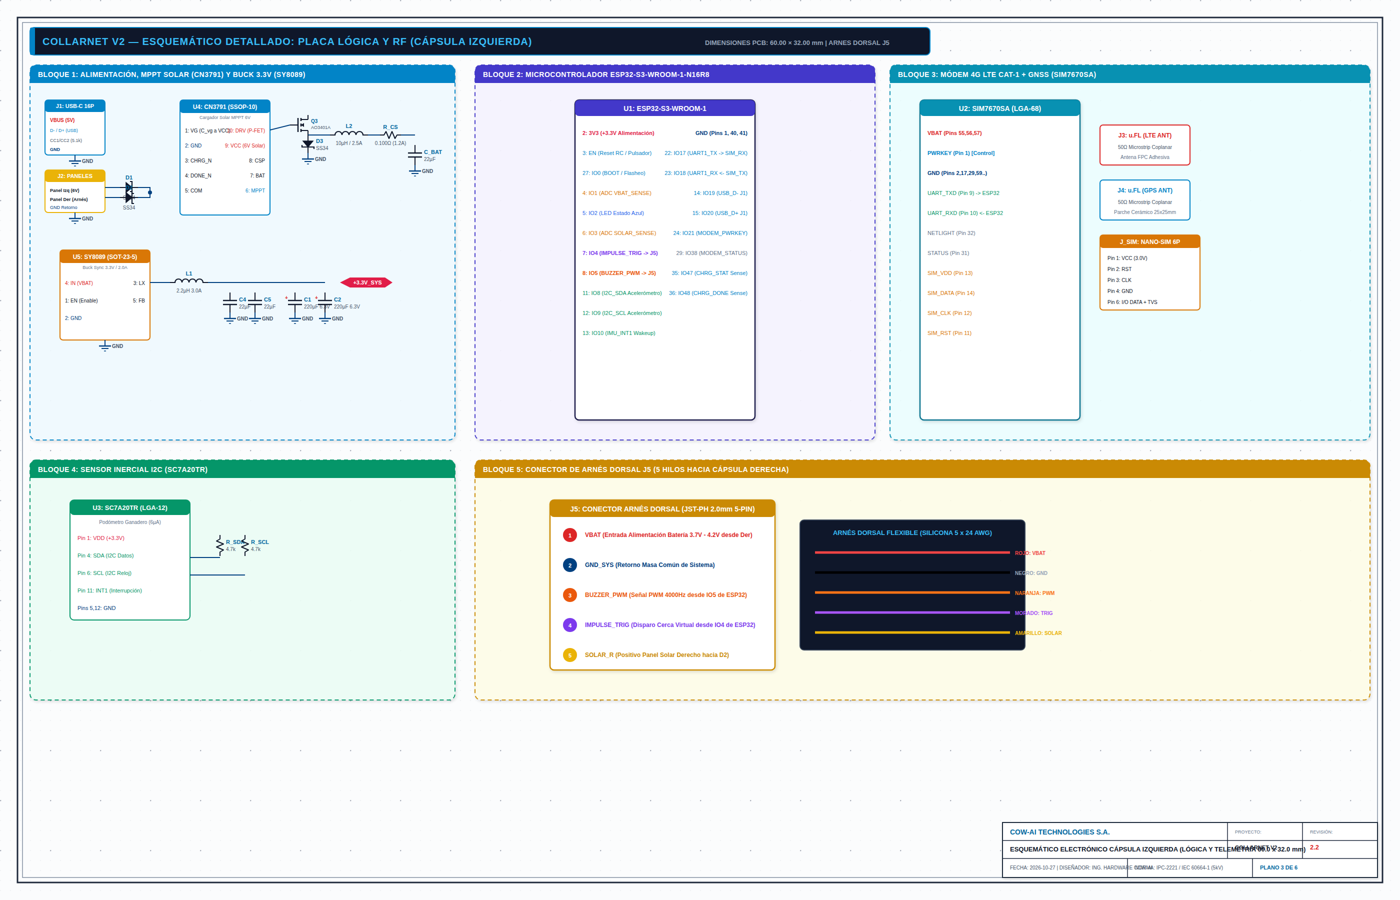
docs/diseno_electronico_pcb/esquematico_modular_logica.png
