MorpheusSoft/CollarNet/docs/diseno_electronico_pcb/esquematico_modular_potencia.png

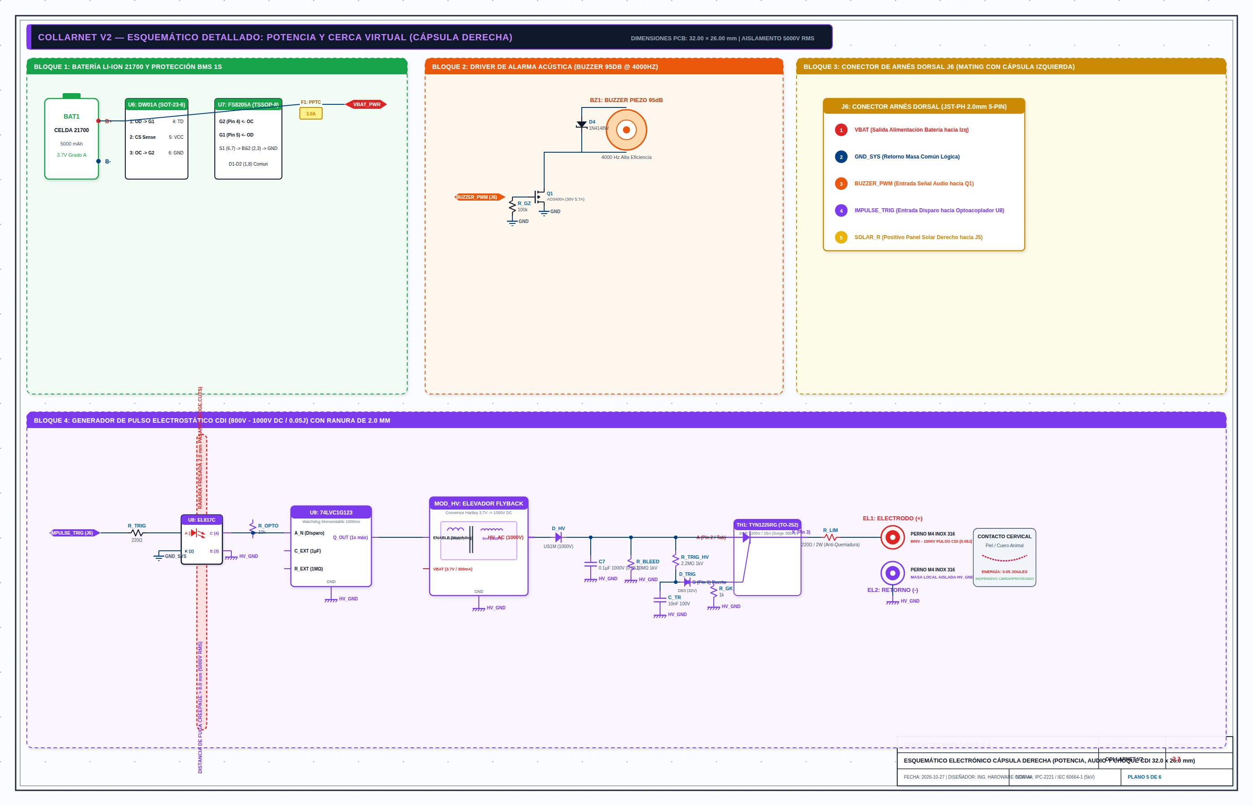
docs/diseno_electronico_pcb/esquematico_modular_potencia.png
