MorpheusSoft/CollarNet/docs/diseno_electronico_pcb/pcb_layout_completo.png

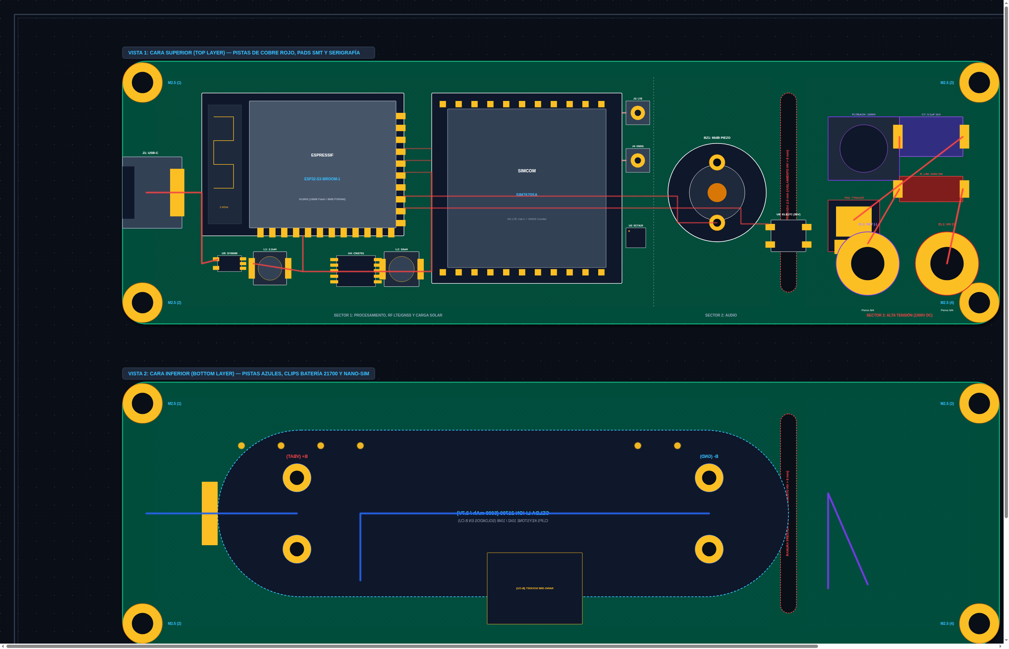
docs/diseno_electronico_pcb/pcb_layout_completo.png
