MorpheusSoft/CollarNet/docs/diseno_electronico_pcb/pcb_layout_top_layer.png

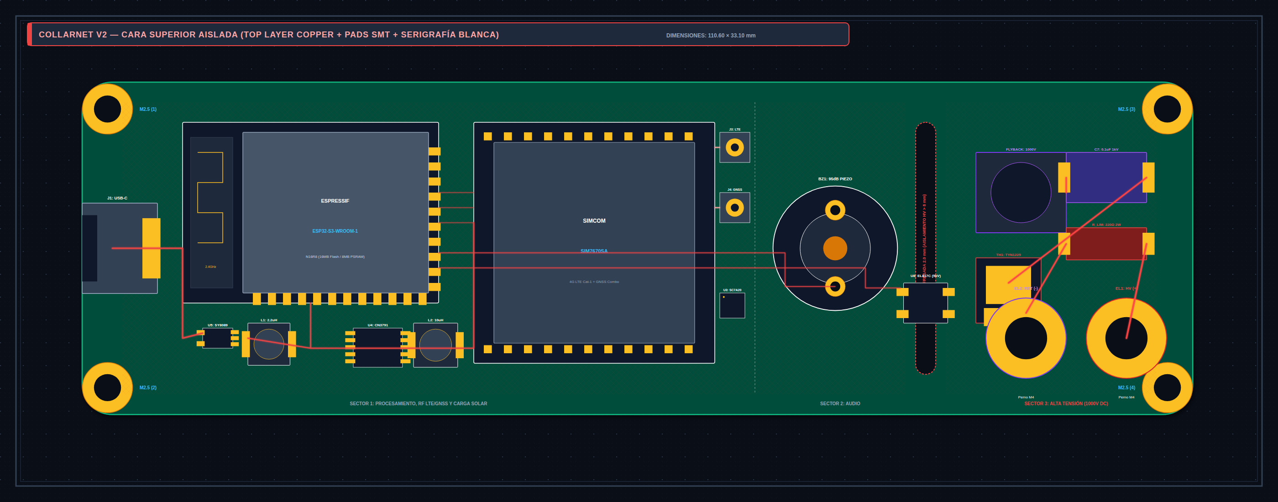
docs/diseno_electronico_pcb/pcb_layout_top_layer.png
