MorpheusSoft/CollarNet/docs/diseno_electronico_pcb/render_pcb_cuadrada_70x70_bottom_3d.png

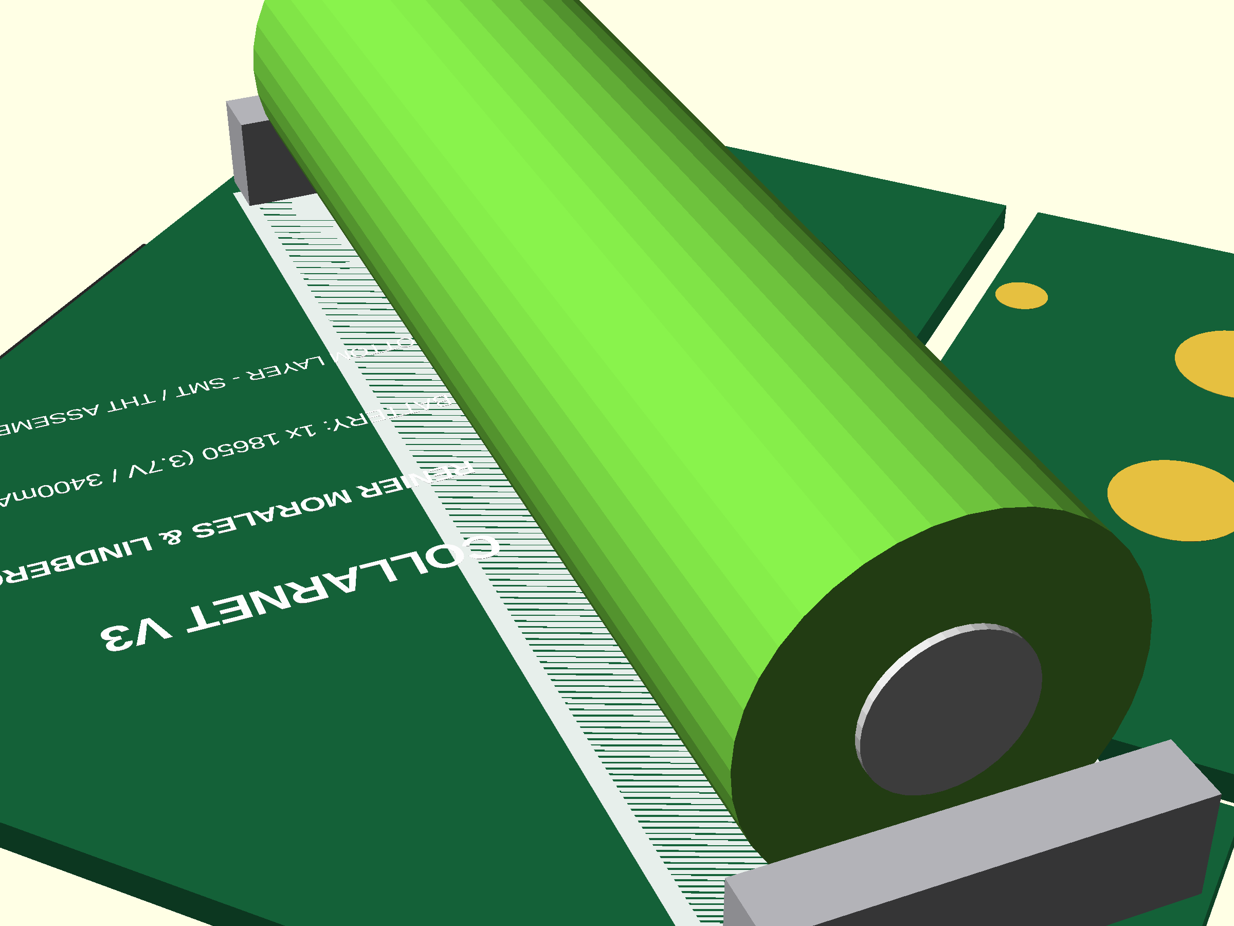
docs/diseno_electronico_pcb/render_pcb_cuadrada_70x70_bottom_3d.png
