MorpheusSoft/CollarNet/docs/diseno_electronico_pcb/render_pcb_cuadrada_70x70_caja.png

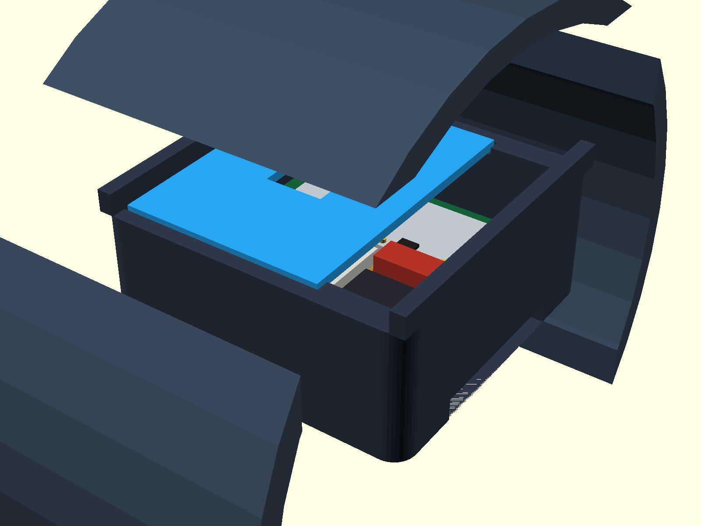
docs/diseno_electronico_pcb/render_pcb_cuadrada_70x70_caja.png
