MorpheusSoft/CollarNet/docs/paquete_cotizacion_presupuesto/PLANO_ESQUEMATICO_COLLARNET_V2.png

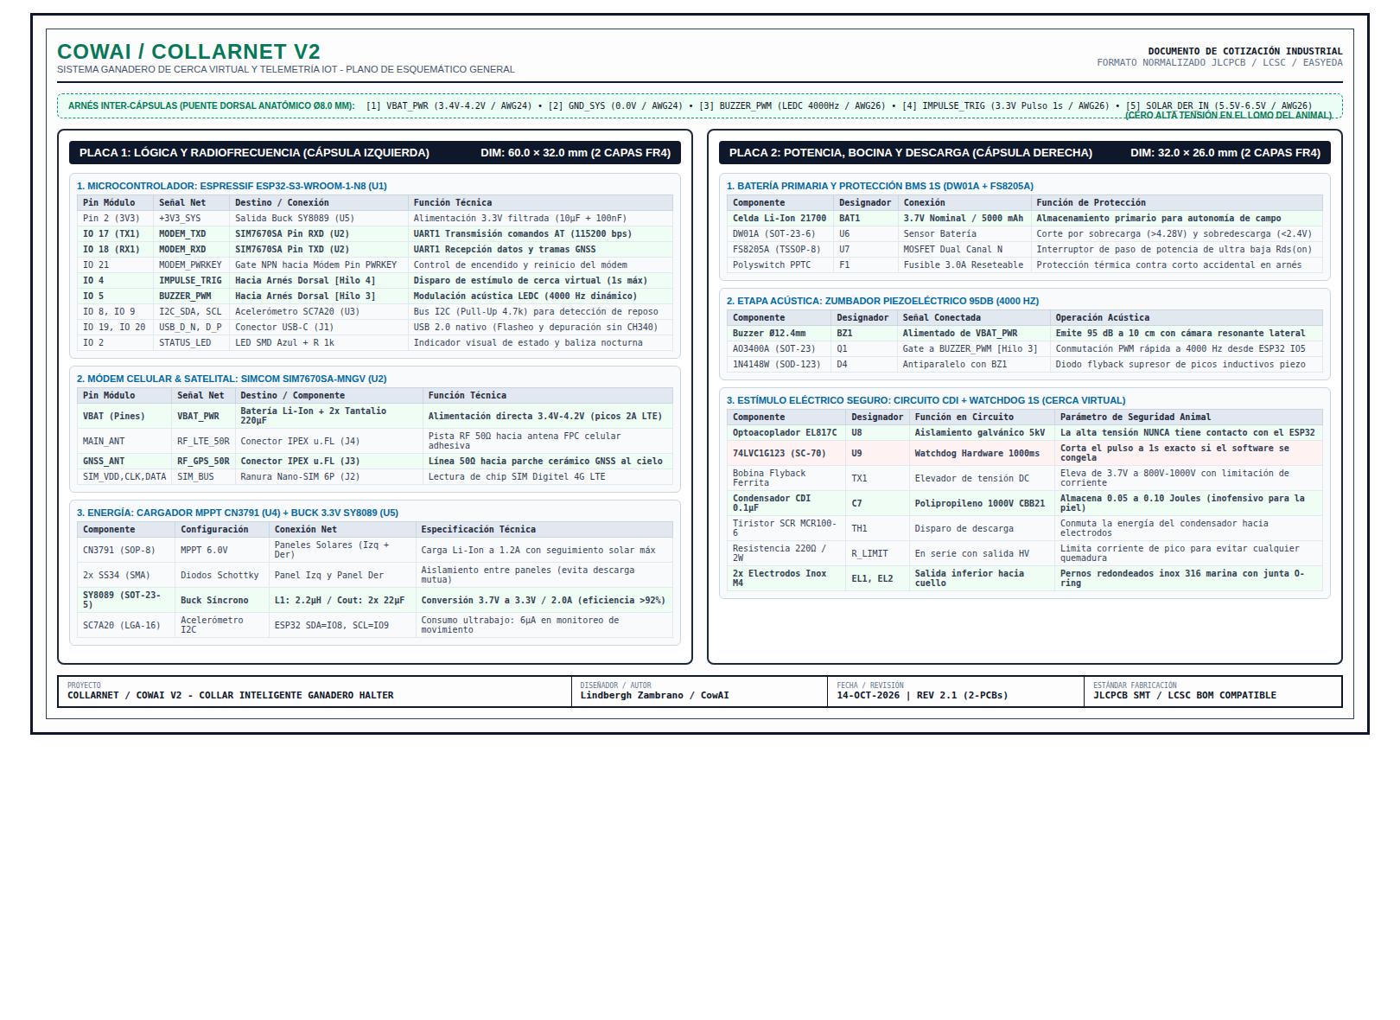
docs/paquete_cotizacion_presupuesto/PLANO_ESQUEMATICO_COLLARNET_V2.png
