MorpheusSoft/CollarNet/docs/diseno_electronico_pcb/04_LISTA_MATERIALES_BOM_LCSC.csv

Item | Designator | Comment / Value | Footprint | LCSC Part # | Manufacturer | Description | Qty | Price (USD)
1 | U1 | ESP32-S3-WROOM-1-N16R8 | MODULE-ESP32-S3 | C2913202 | Espressif Systems | MCU Dual Core 240MHz, 16MB Flash, 8MB PSRAM, Wi-Fi/BLE | 1 | 2.80
2 | U2 | SIM7670SA-MNGV | LCC-LGA-68 | C2892994 | SIMCom | Módem Celular 4G LTE Cat-1 + GNSS Integrado (GPS/GLO/GAL) | 1 | 9.20
3 | U3 | SC7A20TR | LGA-12 / LGA-16 | C392477 | Silan Microelectronics | Acelerómetro Digital 3 Ejes I2C 6uA | 1 | 0.35
4 | U4 | CN3791 | SSOP-10 | C154992 | Consonance | Cargador Batería Li-Ion con MPPT 6V | 1 | 0.55
5 | U5 | SY8089AAAC | SOT-23-5 | C78988 | Silergy | Regulador Reductor Síncrono Buck 3.3V 2A | 1 | 0.22
6 | U6 | DW01A-G | SOT-23-6 | C351410 | Fortune Tech | Controlador Protección Batería Li-Ion 1S | 1 | 0.06
7 | U7 | FS8205A | TSSOP-8 | C32254 | Fortune Tech | MOSFET Dual Canal N 20V 4A para BMS | 1 | 0.08
8 | U8 | EL817S1(C) | SOP-4 | C4999 | Everlight Elec | Optoacoplador Fototransistor Aislamiento 5kV | 1 | 0.06
9 | U9 | 74LVC1G123DCK | VSSOP-8 | C128362 | Nexperia | Temporizador Monoestable Hardware 1000ms Watchdog | 1 | 0.14
10 | F1 | PPTC 3.0A 6V | SMD-1812 | C1045 | Bourns | Fusible Reseteable Térmico Protección Batería | 1 | 0.12
11 | Q1,Q2 | AO3400A | SOT-23 | C20917 | Alpha & Omega | MOSFET Canal N 30V 5.7A (Driver Buzzer/Módem PWRKEY) | 2 | 0.08
12 | Q3 | AO3401A | SOT-23 | C15127 | Alpha & Omega | MOSFET Canal P 30V 4.2A Conmutador Solar MPPT | 1 | 0.05
13 | D1,D2,D3,D5 | SS34 | SMA (DO-214AC) | C8678 | Yangzhou Yangjie | Diodo Schottky 40V 3A (Aislamiento Solar/VBUS/Freewheeling) | 4 | 0.16
14 | D4 | 1N4148W | SOD-123 | C81598 | Changjiang Electronics | Diodo Conmutación Rápido Flyback Buzzer | 1 | 0.02
15 | L1 | 2.2uH 3.0A | SMD-0420 | C167733 | Sunlord | Inductor de Potencia Blindado para Buck SY8089 | 1 | 0.15
16 | L2 | 10uH 2.5A | SMD-0430 | C38117 | Sunlord | Inductor de Potencia Blindado para MPPT CN3791 | 1 | 0.15
17 | C1,C2 | 220uF 6.3V | Case-D_7343 | C7187 | AVX / Kyocera | Condensador Tantalio Baja ESR Picos Módem LTE 2A | 2 | 0.45
18 | C3,C4,C5,C6 | 22uF 10V X5R | SMD-0805 | C45783 | Samsung Electro-Mechanics | Condensadores Cerámicos Filtro Entrada/Salida Buck | 4 | 0.12
19 | C7 | 0.1uF 1000V CBB21 | SMD-1812 / PTH | C2839151 | Faratronic | Condensador Descarga Pulso Cerca Virtual CDI (0.05J) | 1 | 0.30
20 | TH1 | TYN1225RG | TO-252 / DPAK | C14486 | STMicroelectronics | Tiristor SCR 1200V 25A Alta Tensión Disparo Descarga | 1 | 0.35
21 | MOD_HV | Módulo Elevador HV | Submódulo | MOD-1KV | Alibaba / Custom | Mini Módulo Potted Pulso 3.7V a 1000V (Bobina + Oscilador) | 1 | 1.10
22 | J1 | TYPE-C-16PIN-2.0 | SMD-TYPE-C | C2765186 | Korean HRO | Conector USB-C Hembra (Carga y Flasheo Nativo D+/D-) | 1 | 0.15
23 | J2 | NANO-SIM-6P | SMD-PUSH-PULL | C2838382 | Attend Technology | Porta Nano-SIM Push-Pull Ultra Bajo Perfil | 1 | 0.18
24 | J3,J4 | U.FL-R-SMT-1(10) | SMD-IPEX-1 | C88373 | Hirose Electric | Conector Coaxial RF 50R para Antenas LTE y GPS | 2 | 0.14
25 | BZ1 | Buzzer Piezo 95dB 4kHz | PTH-D12.4mm | C253457 | PUI Audio / CUI | Transductor Acústico Piezoeléctrico Pasivo (4000 Hz) | 1 | 0.45
26 | BAT1 | Celda 21700 5000mAh | 21700 Cylindrical | N/A (Batería) | Samsung / LG / BAK | Celda Li-Ion Grado A 3.7V 5000mAh (Cápsula Derecha) | 1 | 3.80
27 | ANT_GPS | Antena Parche GNSS | 25x25x4mm | N/A (Accesorio) | C&T Antennas | Antena Cerámica GNSS con Cable IPEX al cielo | 1 | 1.50
28 | ANT_LTE | Antena 4G LTE FPC | FPC Adhesiva | N/A (Accesorio) | C&T Antennas | Antena Flexible 4G LTE con Cable IPEX en caja | 1 | 0.80
29 | SOLAR_PANEL | Panel Solar 55x60mm | Epoxi 55x60 | N/A (Accesorio) | Ryder / Sunpower | 2x Paneles Solares Monocristalinos 6V 120mA | 2 | 2.40
30 | EL1,EL2 | Electrodos Acero Inox M4 | Perno M4 Semiesférico | Mecánico M4 | Ferretería Inox 316 | Bornes de contacto semiesféricos para cuello | 2 | 0.50
31 | PCB1,PCB2 | Placas PCB 2 Capas FR4 | Panel Fabricado | JLCPCB Service | JLCPCB | Fabricación de Placas Lógica y Potencia con SMT | 2 | 0.80
