MorpheusSoft/CollarNet/docs/diseno_electronico_pcb/diagrama_interconexion_pines_bom.png

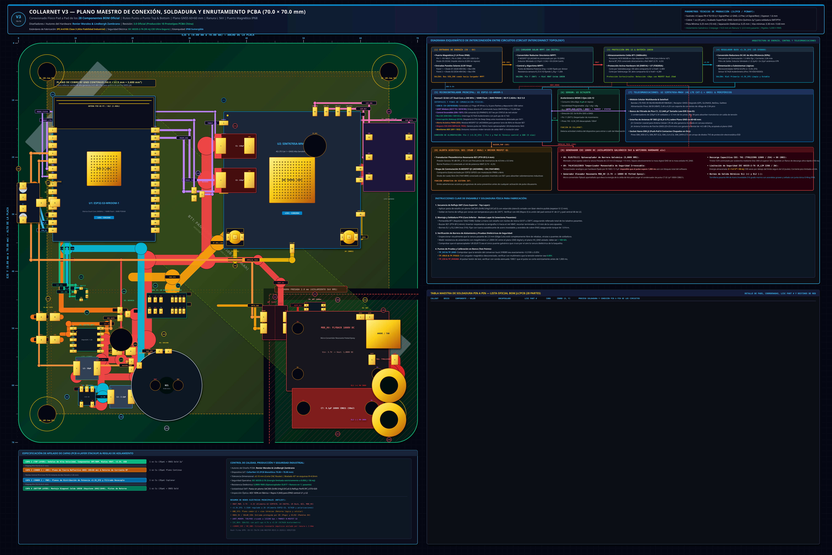
docs/diseno_electronico_pcb/diagrama_interconexion_pines_bom.png
