MorpheusSoft/CollarNet/diseno_halter_v2/collar_halter_v2_completo_ensamble.stl

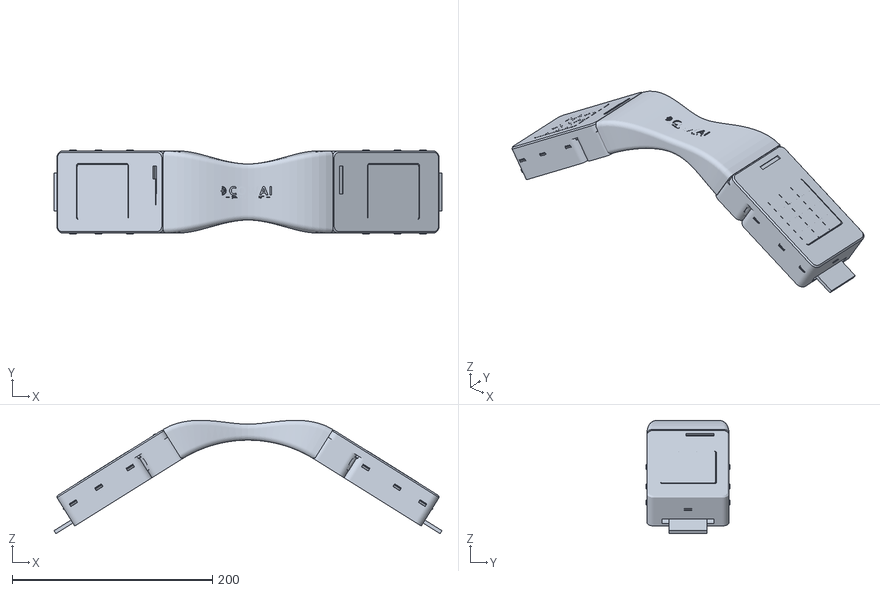
[picture p64: CAD file, 2026-10-14]
diseno_halter_v2/collar_halter_v2_completo_ensamble.stl
387.5 x 83.6 x 113.2
