MorpheusSoft/CollarNet/diseno_halter_v2/visor_3d/modelos_stl/collar_halter_v2_completo_ensamble.stl

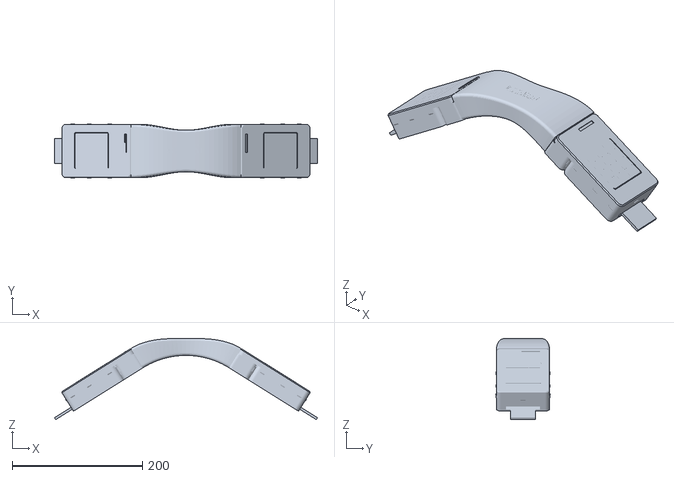
[picture p65: CAD file, 2026-10-16]
diseno_halter_v2/visor_3d/modelos_stl/collar_halter_v2_completo_ensamble.stl
404.5 x 83.6 x 124.9
