MorpheusSoft/CollarNet/logo_3d_cow_ai/pines_ensamble.stl

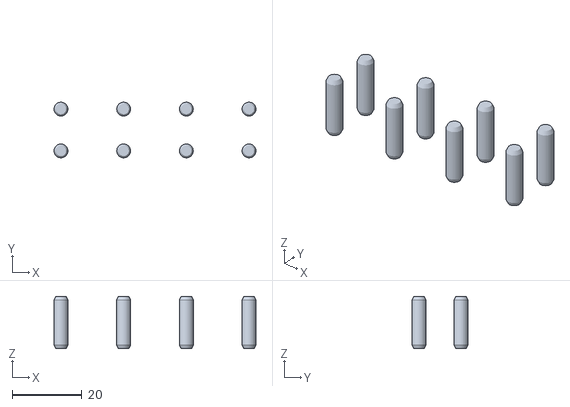
[picture p66: CAD file, 2026-10-17]
logo_3d_cow_ai/pines_ensamble.stl
58.0 x 16.0 x 15.0
