MorpheusSoft/CollarNet/caja_3d/caja_base_ip67_18650.stl

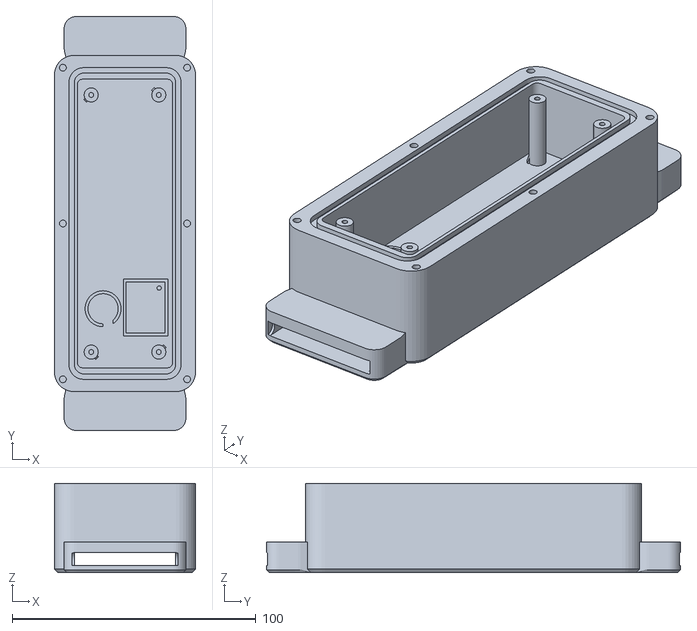
[picture p67: CAD file, 2026-10-14]
caja_3d/caja_base_ip67_18650.stl
58.0 x 170.0 x 36.7
