MorpheusSoft/CollarNet/diseno_halter_v2/CAPSULA_IZQUIERDA_DOS_PARTES_SEPARADAS.stl

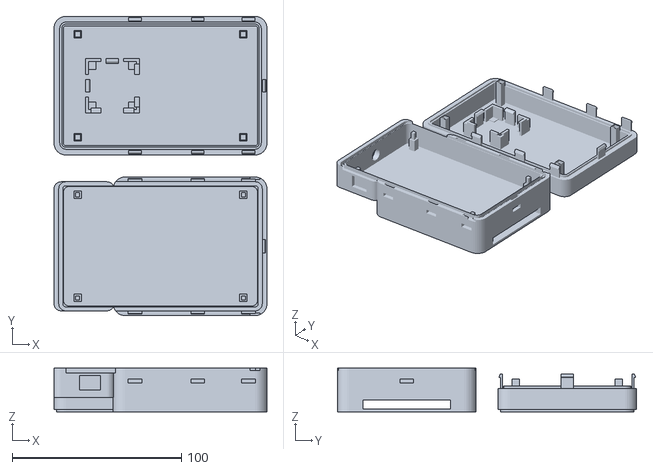
[picture p68: CAD file, 2026-11-09]
diseno_halter_v2/CAPSULA_IZQUIERDA_DOS_PARTES_SEPARADAS.stl
126.0 x 177.0 x 26.0
