MorpheusSoft/CollarNet/diseno_halter_v2/probetas_stl/probeta_puente_segmento.stl

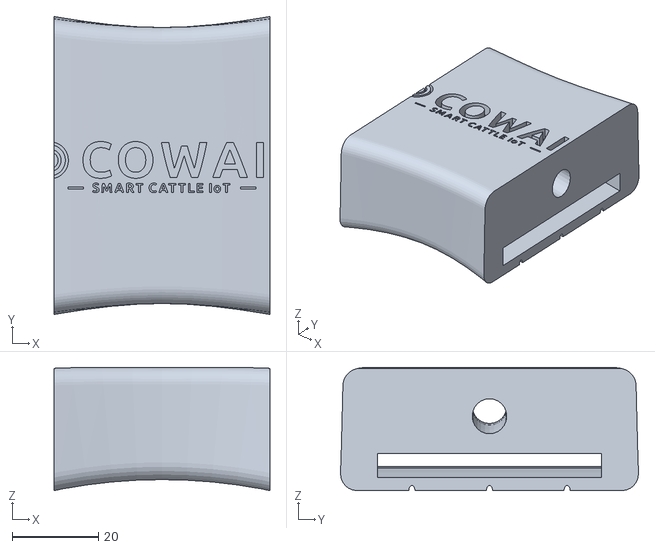
[picture p69: CAD file, 2026-10-16]
diseno_halter_v2/probetas_stl/probeta_puente_segmento.stl
50.0 x 69.1 x 28.6
