MorpheusSoft/CollarNet/diseno_halter_v2/versiones_anteriores/originales_companero_35mm/juntas_estancas_tpu_x2_ip67.stl

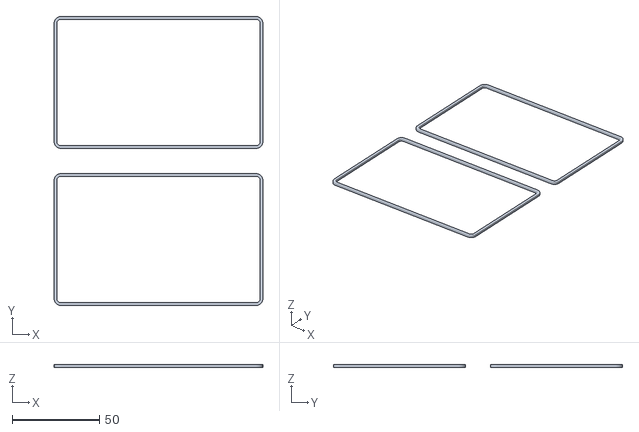
[picture p70: CAD file, 2026-10-27]
diseno_halter_v2/versiones_anteriores/originales_companero_35mm/juntas_estancas_tpu_x2_ip67.stl
119.6 x 165.6 x 1.80
