MorpheusSoft/CollarNet/diseno_halter_v2/visor_3d/modelos_stl/comp_solar_bin.stl

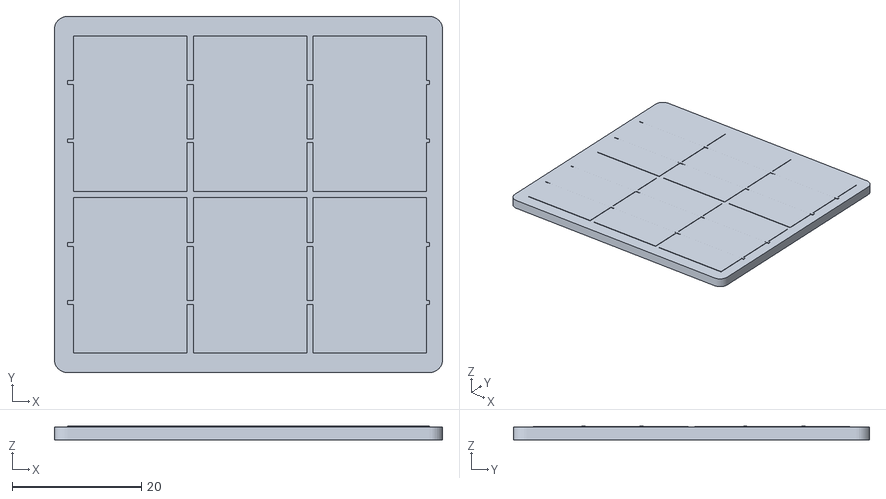
[picture p71: CAD file, 2026-10-27]
diseno_halter_v2/visor_3d/modelos_stl/comp_solar_bin.stl
60.0 x 55.0 x 2.12
