MorpheusSoft/CollarNet/Halter_V2_Nuevo_Modelo/capsula_base_85x85mm.stl

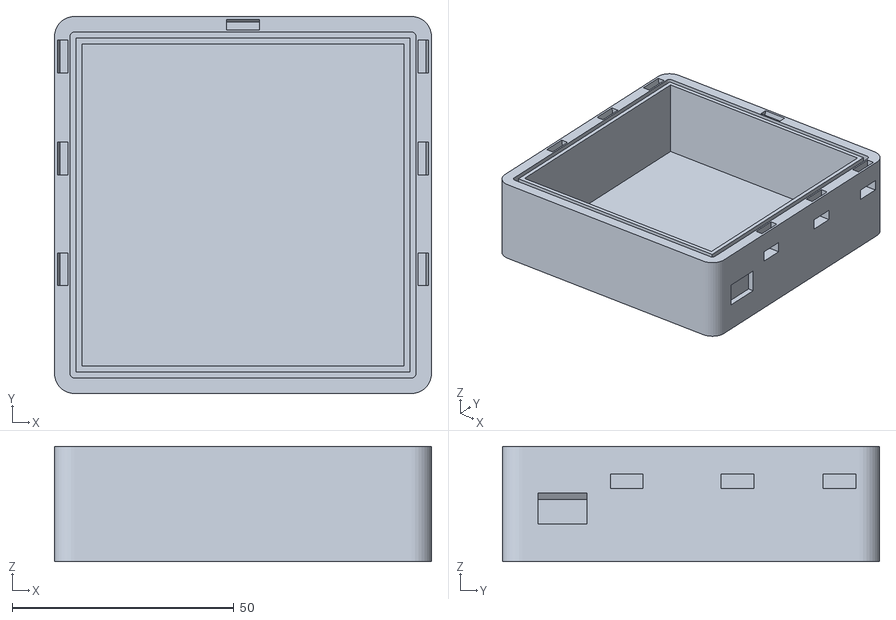
[picture p72: CAD file, 2026-11-03]
Halter_V2_Nuevo_Modelo/capsula_base_85x85mm.stl
85.0 x 85.0 x 26.0
