MorpheusSoft/CollarNet/logo_3d_cow_ai/letra_W.stl

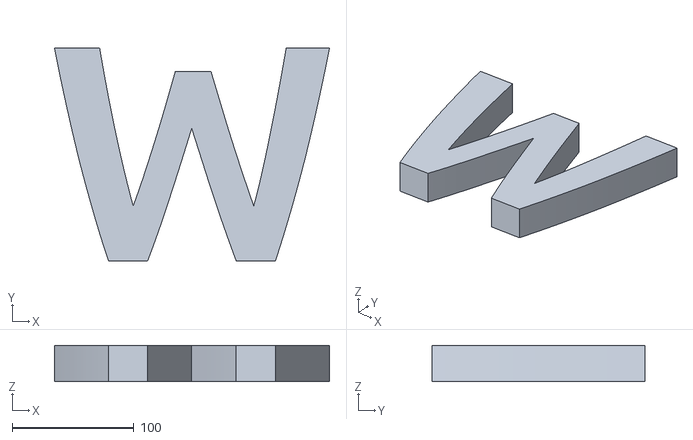
[picture p73: CAD file, 2026-10-17]
logo_3d_cow_ai/letra_W.stl
226.2 x 175.2 x 30.0
