MorpheusSoft/CollarNet/caja_3d/caja_base_ip67_collar_lipo.stl

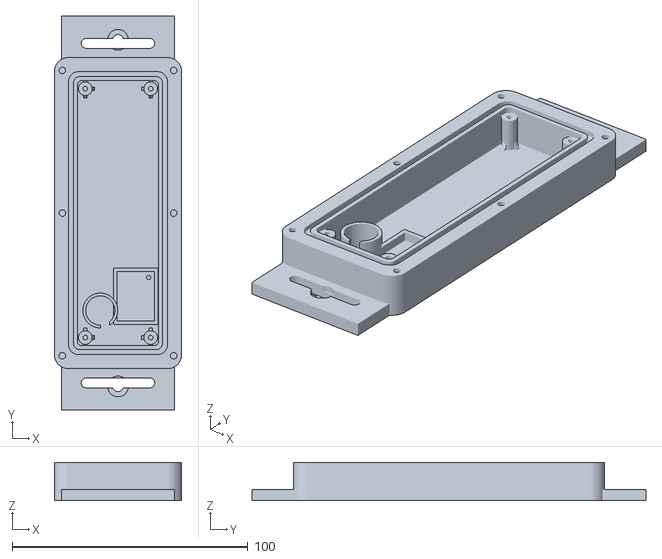
[picture p74: CAD file, 2026-10-14]
caja_3d/caja_base_ip67_collar_lipo.stl
54.0 x 167.1 x 16.2
