MorpheusSoft/CollarNet/diseno_halter_v2/probetas_stl/probeta_click_ip67_tapa.3mf

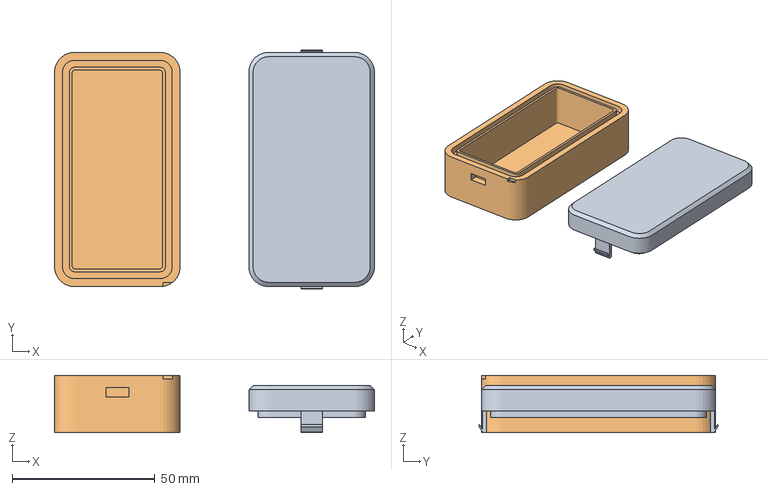
[picture p75: CAD file, 2026-10-16]
diseno_halter_v2/probetas_stl/probeta_click_ip67_tapa.3mf
112.0 x 83.6 x 20.0 mm
probeta_click_ip67_tapa.stl
probeta_click_ip67_base.stl
