MorpheusSoft/CollarNet/diseno_halter_v2/puente_dorsal_cowai.3mf

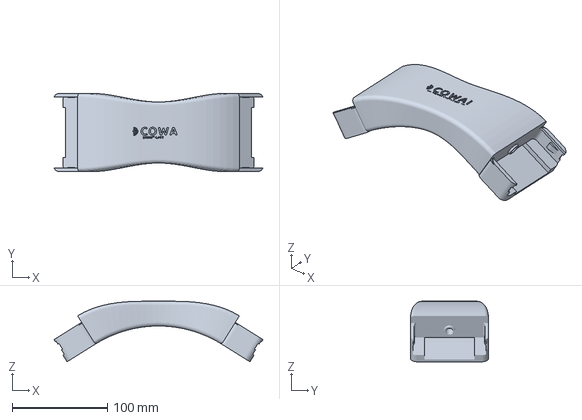
[picture p76: CAD file, 2026-10-17]
diseno_halter_v2/puente_dorsal_cowai.3mf
219.3 x 82.0 x 63.6 mm
