MorpheusSoft/CollarNet/diseno_halter_v2/versiones_anteriores/originales_companero_35mm/capsula_derecha_base_bateria_21700.stl

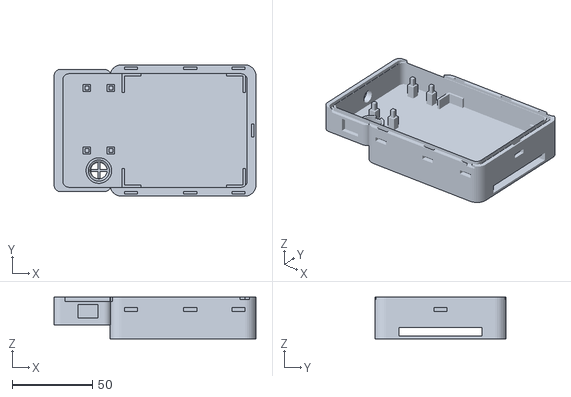
[picture p77: CAD file, 2026-10-27]
diseno_halter_v2/versiones_anteriores/originales_companero_35mm/capsula_derecha_base_bateria_21700.stl
126.0 x 82.0 x 26.0
