MorpheusSoft/CollarNet/diseno_halter_v2/visor_3d/modelos_stl/comp_mppt.stl

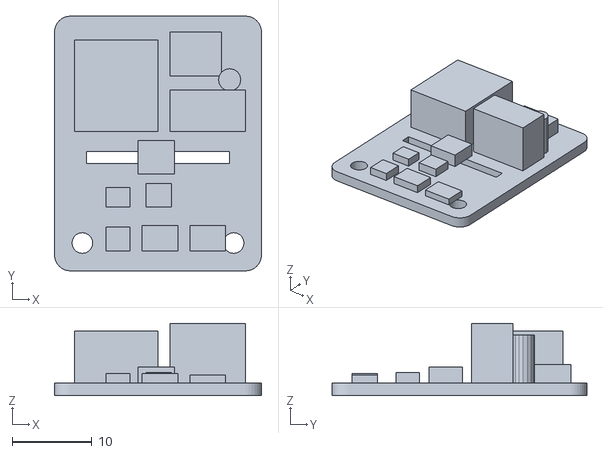
[picture p78: CAD file, 2026-10-27]
diseno_halter_v2/visor_3d/modelos_stl/comp_mppt.stl
26.0 x 32.0 x 9.10
