MorpheusSoft/CollarNet/logo_3d_cow_ai/letra_O.stl

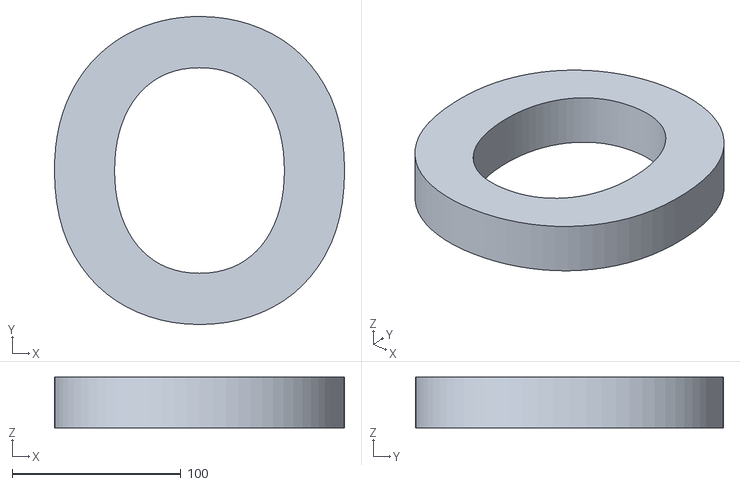
[picture p79: CAD file, 2026-10-17]
logo_3d_cow_ai/letra_O.stl
172.1 x 182.8 x 30.0
