MorpheusSoft/CollarNet/caja_3d/hebilla_ganadera_38mm.stl

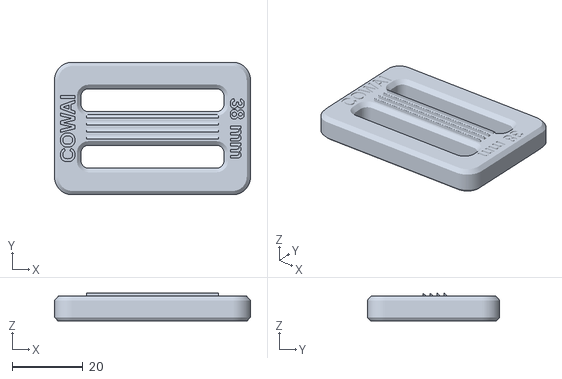
[picture p80: CAD file, 2026-10-14]
caja_3d/hebilla_ganadera_38mm.stl
55.5 x 37.5 x 7.90
