MorpheusSoft/CollarNet/diseno_halter_v2/probetas_stl/probeta_click_ip67_base.stl

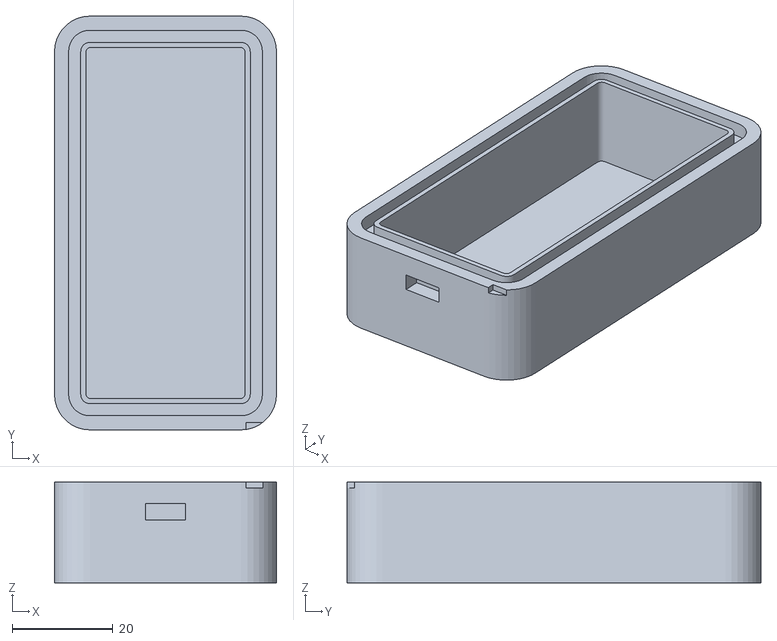
[picture p81: CAD file, 2026-10-16]
diseno_halter_v2/probetas_stl/probeta_click_ip67_base.stl
44.0 x 82.0 x 20.0
