MorpheusSoft/CollarNet/diseno_halter_v2/puente_texto_cowai.stl

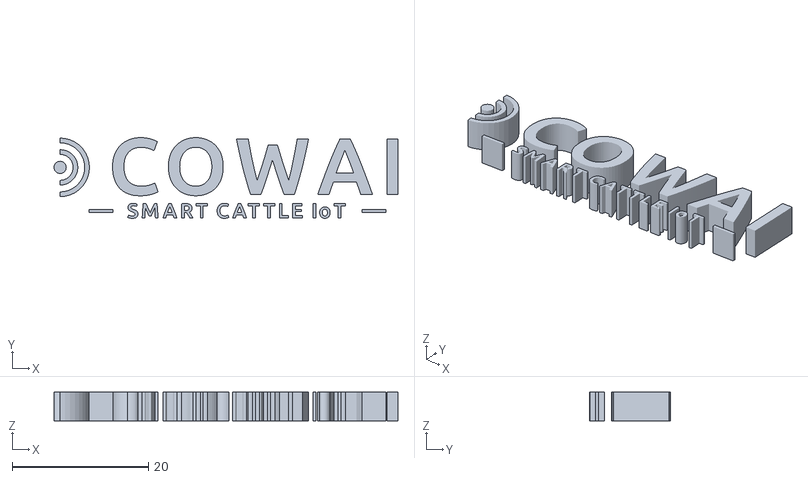
[picture p82: CAD file, 2026-10-14]
diseno_halter_v2/puente_texto_cowai.stl
50.4 x 11.8 x 4.20
