MorpheusSoft/CollarNet/diseno_halter_v2/visor_3d/modelos_stl/comp_bateria_bin.stl

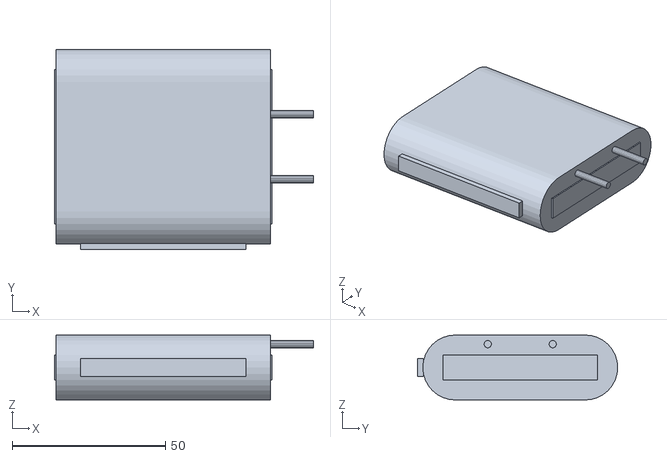
[picture p83: CAD file, 2026-10-27]
diseno_halter_v2/visor_3d/modelos_stl/comp_bateria_bin.stl
84.5 x 65.4 x 21.2
