MorpheusSoft/CollarNet/logo_3d_cow_ai/vaca_cuadrante_sup_izq.stl

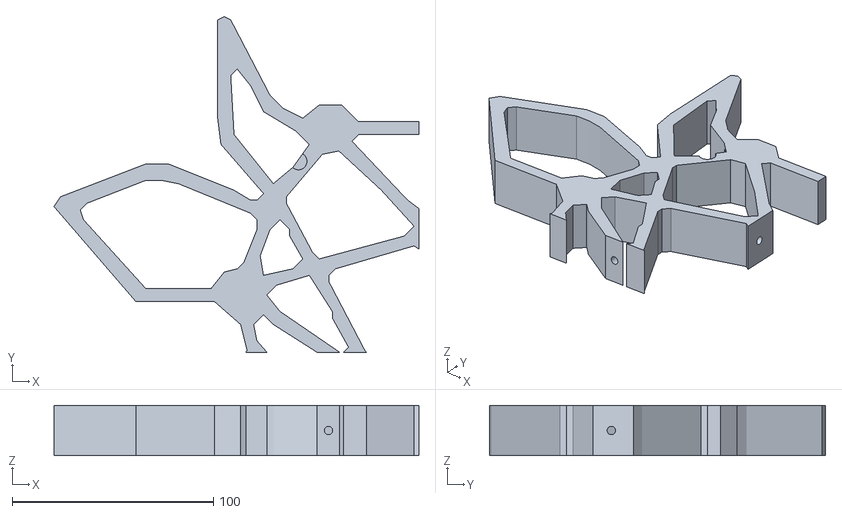
[picture p84: CAD file, 2026-10-17]
logo_3d_cow_ai/vaca_cuadrante_sup_izq.stl
181.6 x 166.9 x 25.0
