MorpheusSoft/CollarNet/caja_3d/caja_tapa_ip67_sellada.stl

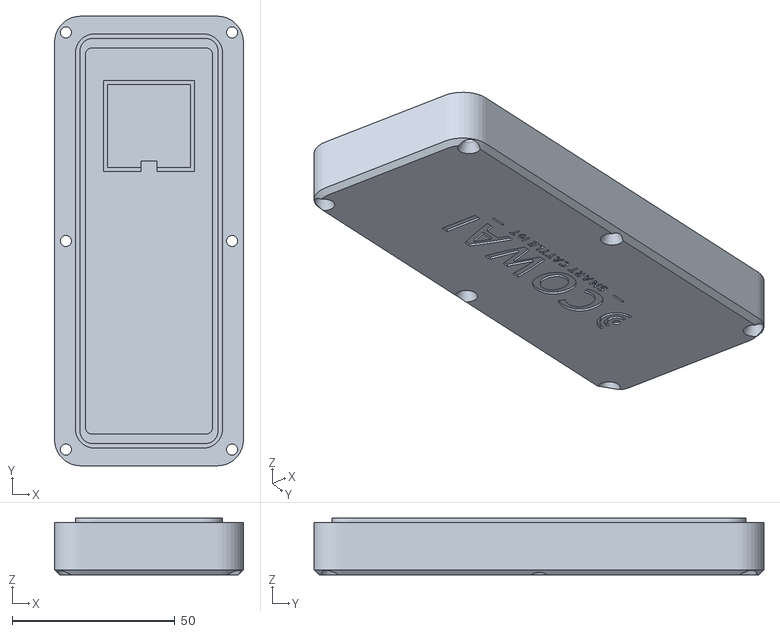
[picture p85: CAD file, 2026-10-14]
caja_3d/caja_tapa_ip67_sellada.stl
58.0 x 138.0 x 17.4
