MorpheusSoft/CollarNet/diseno_halter_v2/capsula_izquierda_base_lilygo.stl

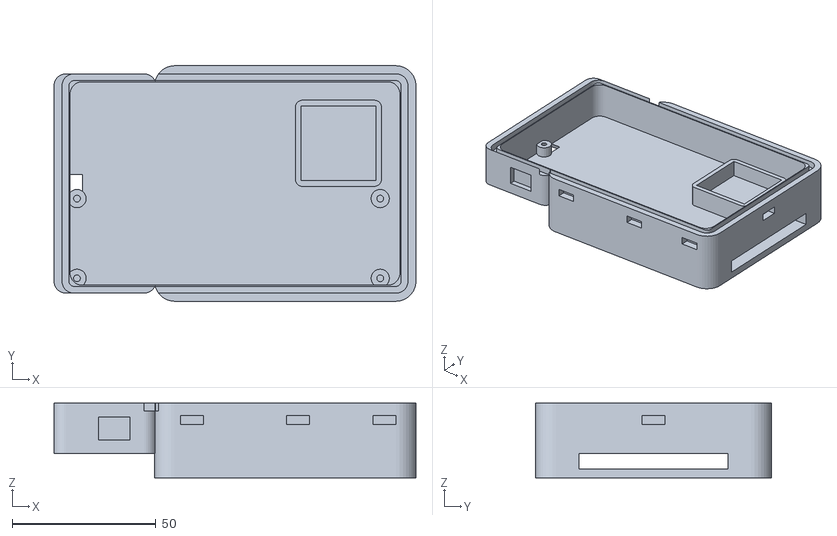
[picture p86: CAD file, 2026-10-14]
diseno_halter_v2/capsula_izquierda_base_lilygo.stl
126.0 x 82.0 x 26.0
