MorpheusSoft/CollarNet/diseno_halter_v2/probetas_stl/probeta_junta_ip67.stl

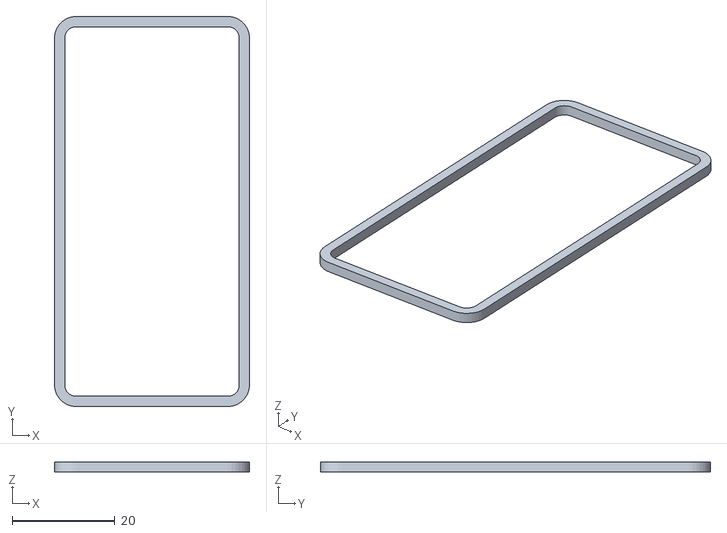
[picture p87: CAD file, 2026-10-16]
diseno_halter_v2/probetas_stl/probeta_junta_ip67.stl
38.0 x 76.0 x 2.00
