MorpheusSoft/CollarNet/diseno_halter_v2/visor_3d/modelos_stl/comp_electrodos.stl

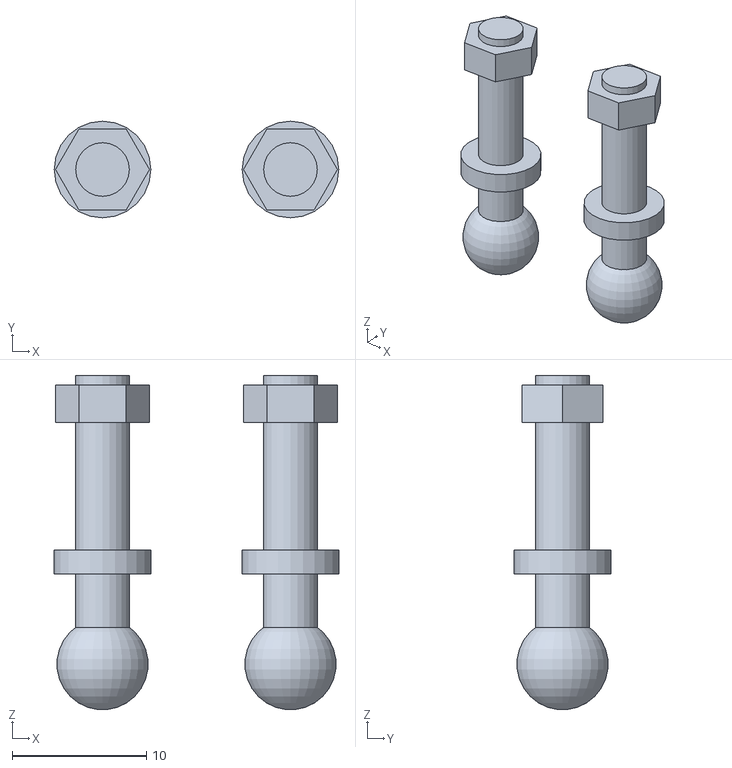
[picture p88: CAD file, 2026-10-27]
diseno_halter_v2/visor_3d/modelos_stl/comp_electrodos.stl
21.2 x 7.20 x 24.9
