MorpheusSoft/CollarNet/logo_3d_cow_ai/letra_I.stl

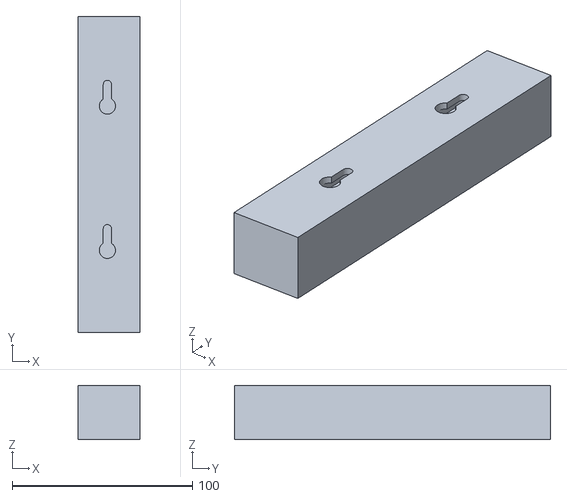
[picture p89: CAD file, 2026-10-17]
logo_3d_cow_ai/letra_I.stl
34.5 x 175.2 x 30.0
