MorpheusSoft/CollarNet/caja_3d/caja_base_collar_lipo.stl

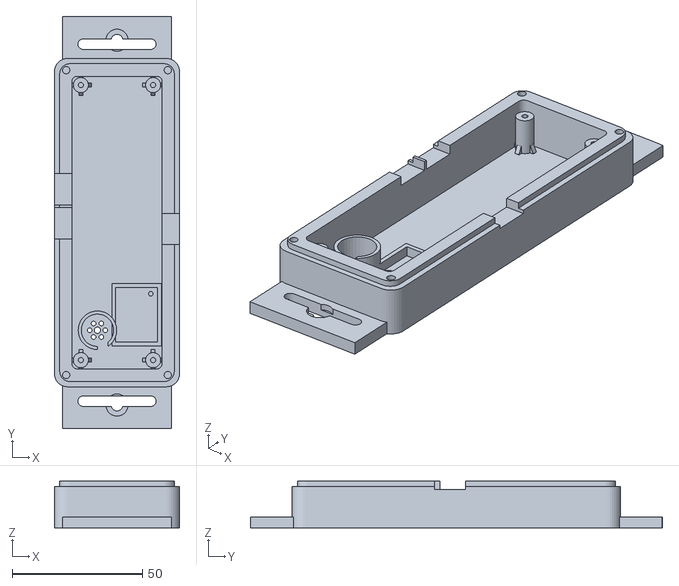
[picture p90: CAD file, 2026-10-14]
caja_3d/caja_base_collar_lipo.stl
48.0 x 158.1 x 18.0
