MorpheusSoft/CollarNet/diseno_halter_v2/capsula_derecha_base_bateria_21700.stl

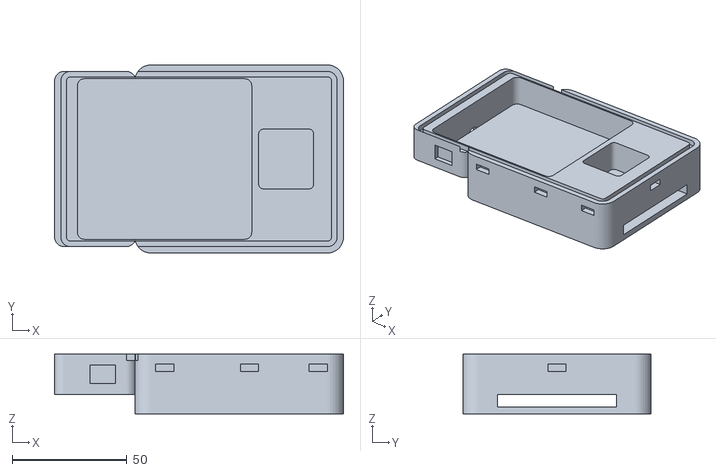
[picture p91: CAD file, 2026-10-14]
diseno_halter_v2/capsula_derecha_base_bateria_21700.stl
126.0 x 82.0 x 26.0
