MorpheusSoft/CollarNet/diseno_halter_v2/probetas_stl/probeta_cuello_capsula.stl

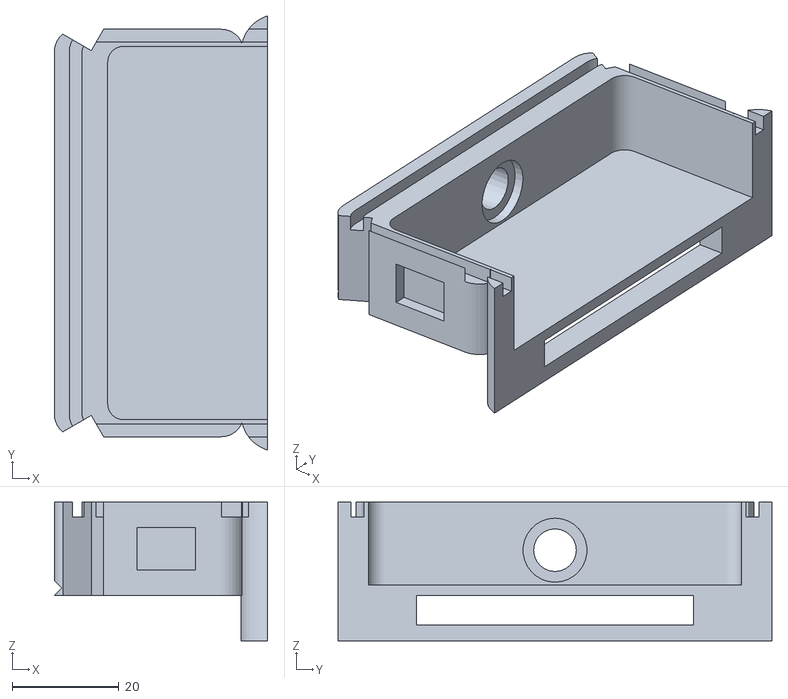
[picture p92: CAD file, 2026-10-16]
diseno_halter_v2/probetas_stl/probeta_cuello_capsula.stl
40.0 x 81.4 x 26.0
