MorpheusSoft/CollarNet/diseno_halter_v2/visor_3d/modelos_stl/capsula_izquierda_base_lilygo.stl

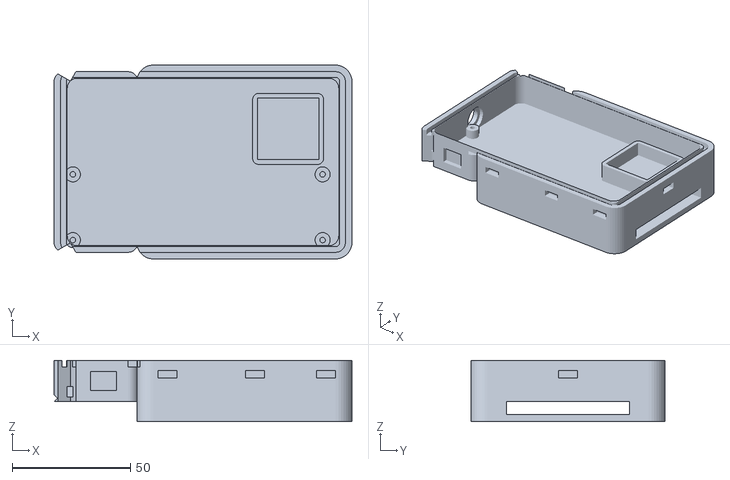
[picture p93: CAD file, 2026-10-16]
diseno_halter_v2/visor_3d/modelos_stl/capsula_izquierda_base_lilygo.stl
126.0 x 82.0 x 26.0
