MorpheusSoft/CollarNet/logo_3d_cow_ai/letra_C.stl

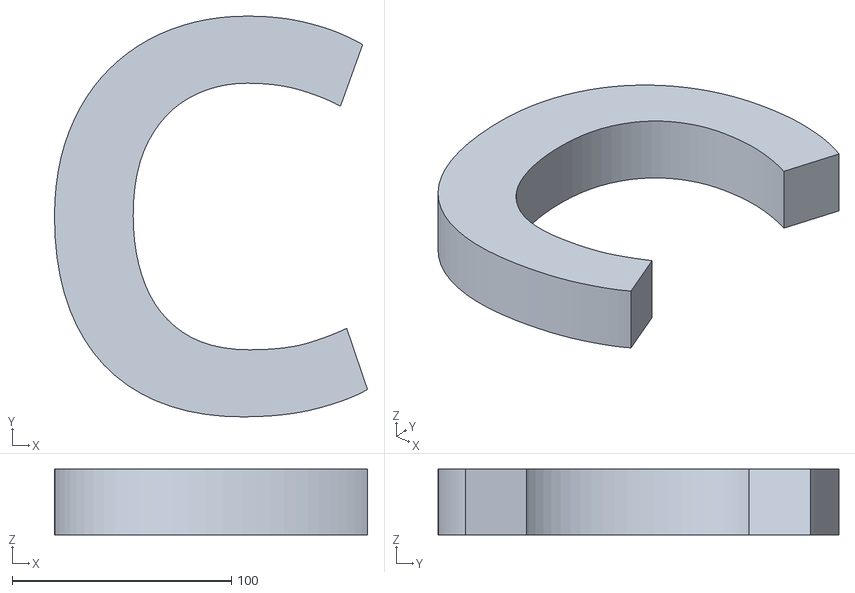
[picture p94: CAD file, 2026-10-17]
logo_3d_cow_ai/letra_C.stl
142.8 x 182.8 x 30.0
