MorpheusSoft/CollarNet/caja_3d/junta_tpu_ip67.3mf

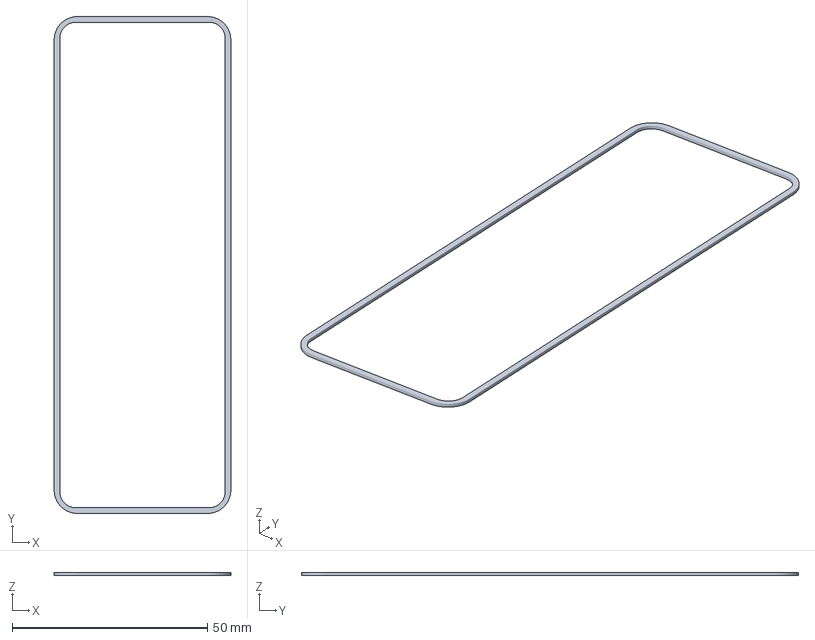
[picture p95: CAD file, 2026-10-14]
caja_3d/junta_tpu_ip67.3mf
45.3 x 127.3 x 0.8 mm
