MorpheusSoft/CollarNet/diseno_halter_v2/probetas_stl/probeta_bolsillo_tpu.3mf

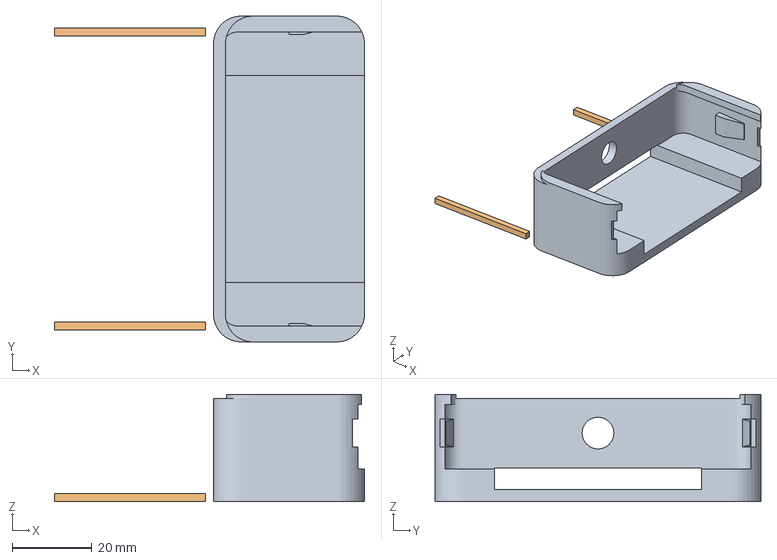
[picture p96: CAD file, 2026-10-14]
diseno_halter_v2/probetas_stl/probeta_bolsillo_tpu.3mf
78.0 x 82.0 x 27.0 mm
probeta_bolsillo_tpu.stl
probeta_junta_ip67.stl
