MorpheusSoft/CollarNet/diseno_halter_v2/visor_3d/modelos_stl/comp_buzzer.stl

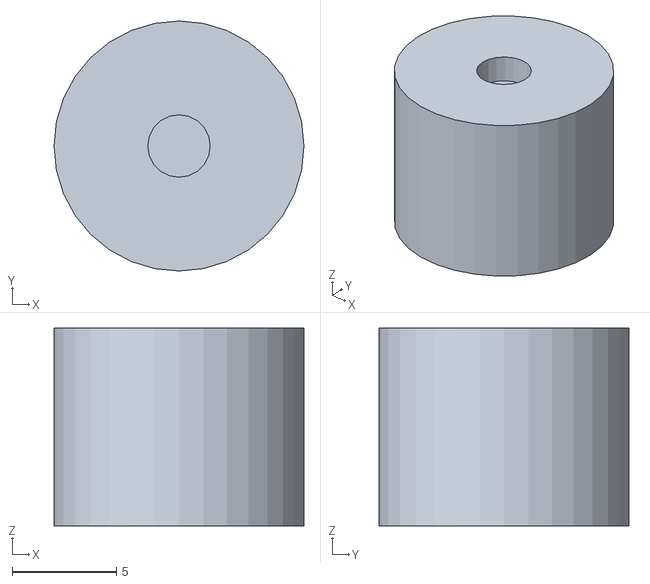
[picture p97: CAD file, 2026-10-16]
diseno_halter_v2/visor_3d/modelos_stl/comp_buzzer.stl
12.0 x 12.0 x 9.50
