MorpheusSoft/CollarNet/logo_3d_cow_ai/letra_A.stl

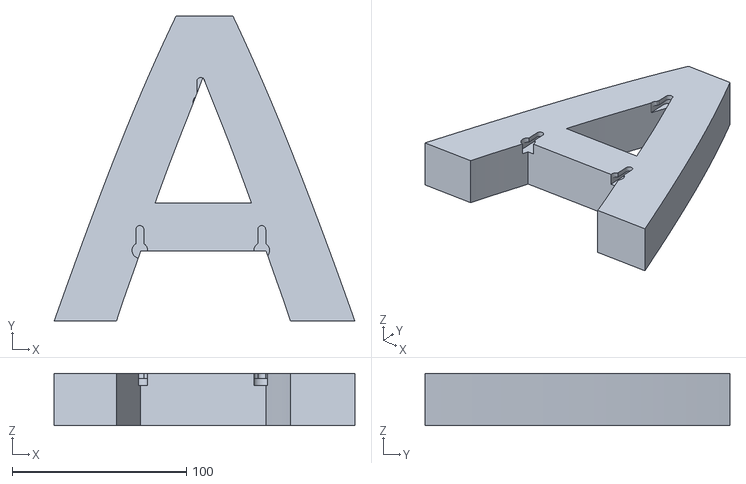
[picture p98: CAD file, 2026-10-17]
logo_3d_cow_ai/letra_A.stl
172.7 x 175.2 x 30.0
