MorpheusSoft/CollarNet/caja_3d/trabilla_ganadera_38mm.stl

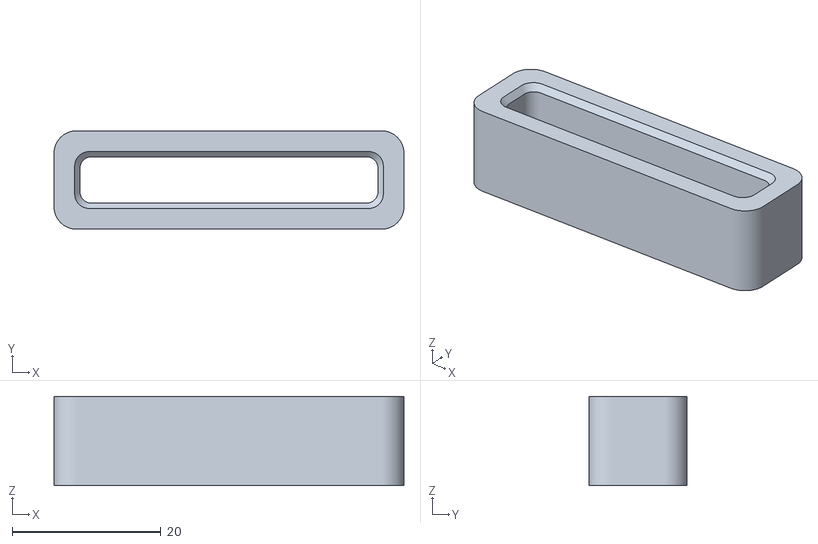
[picture p99: CAD file, 2026-10-14]
caja_3d/trabilla_ganadera_38mm.stl
47.0 x 13.2 x 12.0
