MorpheusSoft/CollarNet/caja_3d/caja_texto_cowai.stl

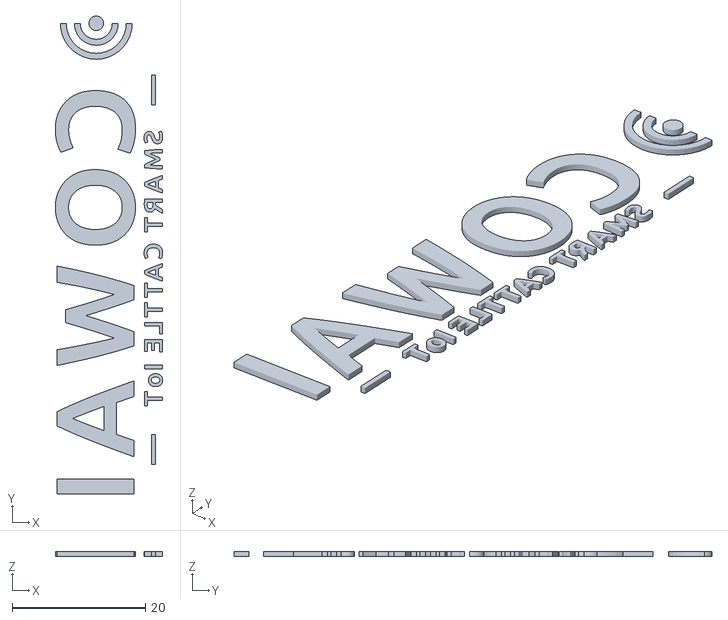
[picture p100: CAD file, 2026-10-14]
caja_3d/caja_texto_cowai.stl
16.1 x 71.8 x 0.7
