MorpheusSoft/CollarNet/diseno_halter_v2/visor_3d/modelos_stl/comp_cincha_bin.stl

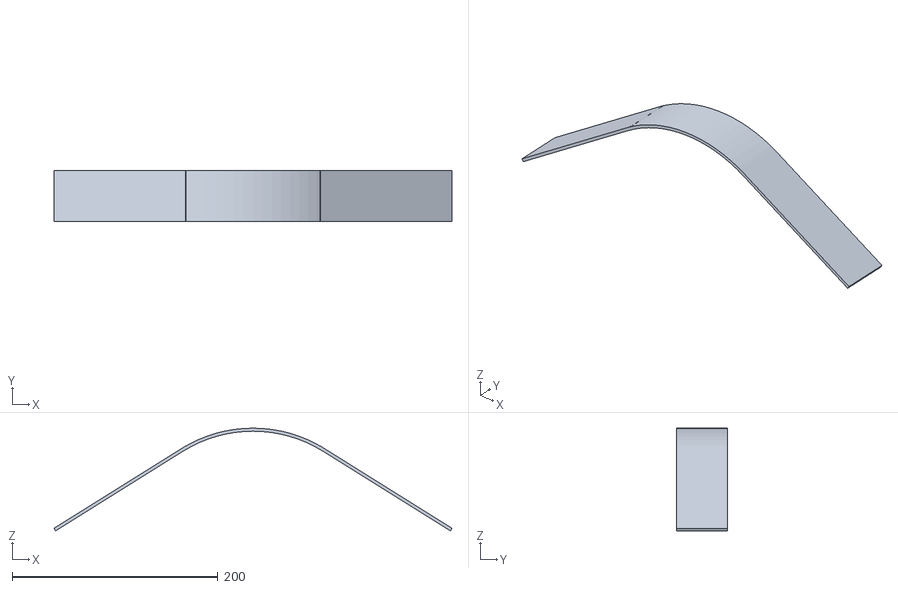
[picture p101: CAD file, 2026-10-16]
diseno_halter_v2/visor_3d/modelos_stl/comp_cincha_bin.stl
387.0 x 50.0 x 99.9
