MorpheusSoft/CollarNet/logo_3d_cow_ai/vaca_cuadrante_inf_der.stl

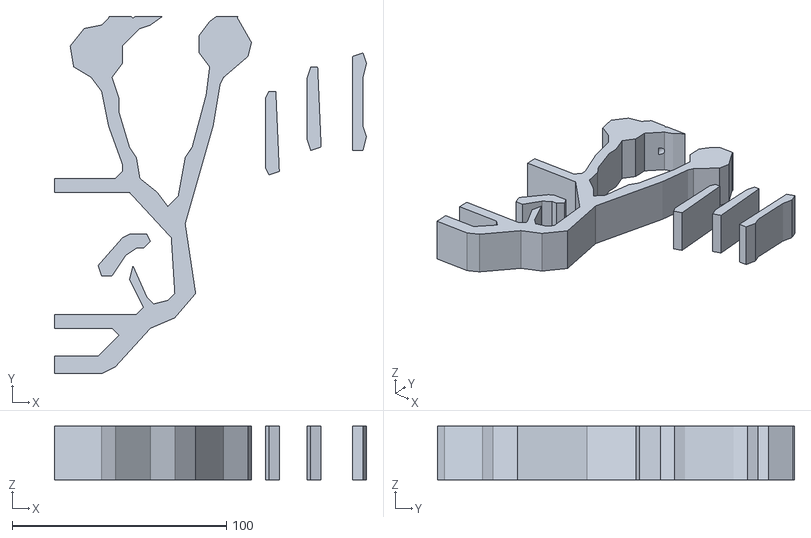
[picture p102: CAD file, 2026-10-17]
logo_3d_cow_ai/vaca_cuadrante_inf_der.stl
145.7 x 166.9 x 25.0
