MorpheusSoft/CollarNet/caja_3d/caja_tapa_lab_ventilada.stl

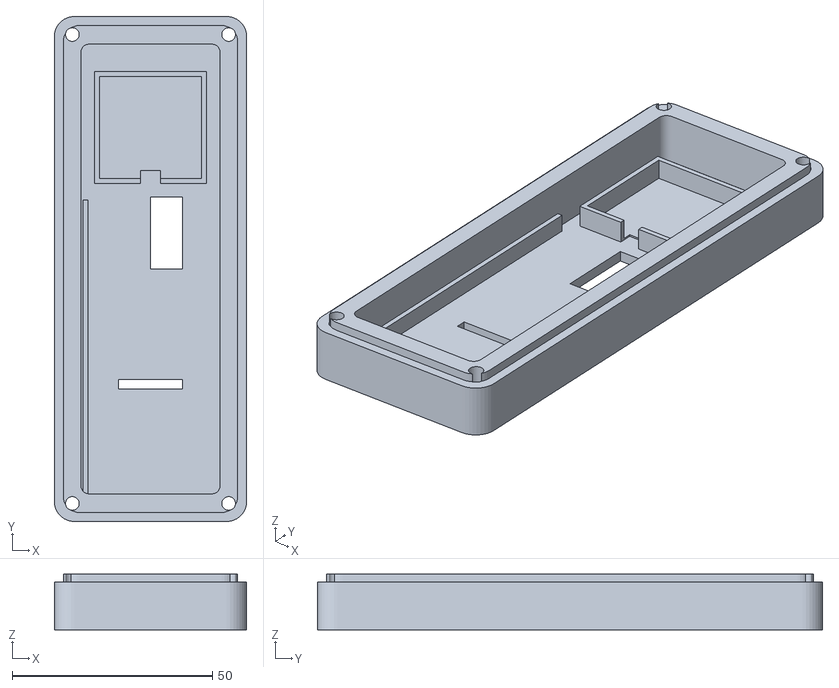
[picture p103: CAD file, 2026-10-14]
caja_3d/caja_tapa_lab_ventilada.stl
48.0 x 126.0 x 13.9
