MorpheusSoft/CollarNet/logo_3d_cow_ai/placas_union_vaca.stl

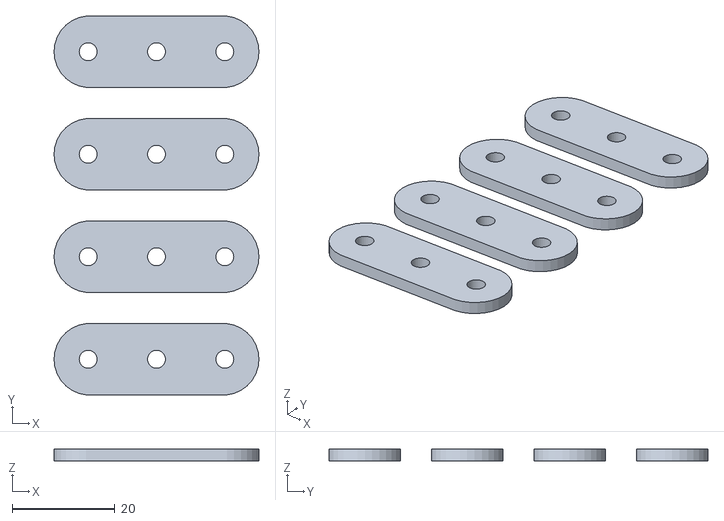
[picture p104: CAD file, 2026-10-17]
logo_3d_cow_ai/placas_union_vaca.stl
40.0 x 73.9 x 2.40
