MorpheusSoft/CollarNet/diseno_halter_v2/visor_3d/modelos_stl/comp_antena.stl

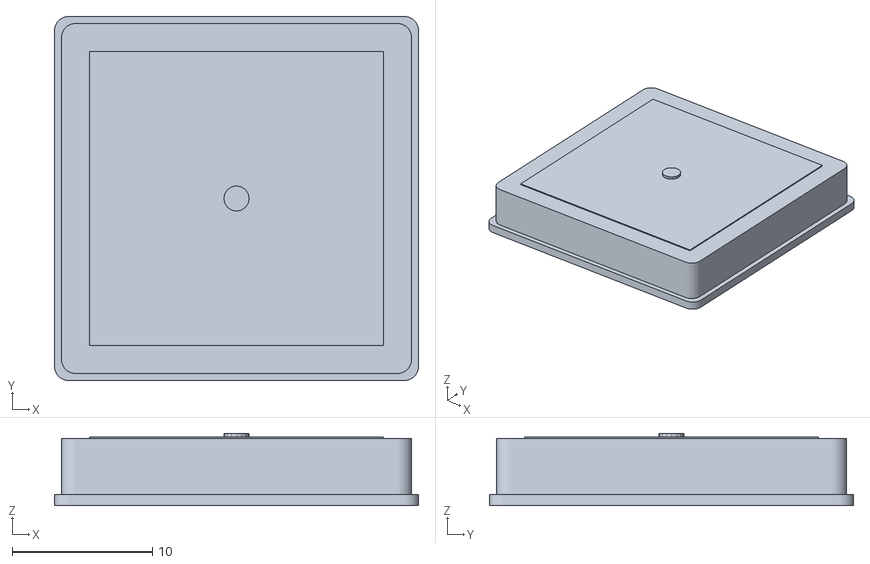
[picture p105: CAD file, 2026-10-16]
diseno_halter_v2/visor_3d/modelos_stl/comp_antena.stl
26.0 x 26.0 x 5.15
