MorpheusSoft/CollarNet/logo_3d_cow_ai/vaca_cuadrante_inf_izq.stl

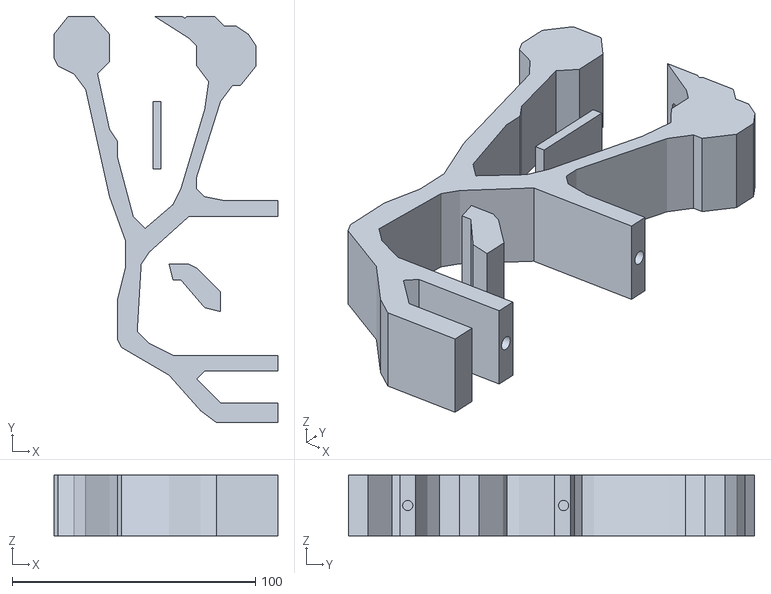
[picture p106: CAD file, 2026-10-17]
logo_3d_cow_ai/vaca_cuadrante_inf_izq.stl
92.0 x 166.9 x 25.0
