MorpheusSoft/CollarNet/caja_3d/CollarNet_Caja_IP67.3mf

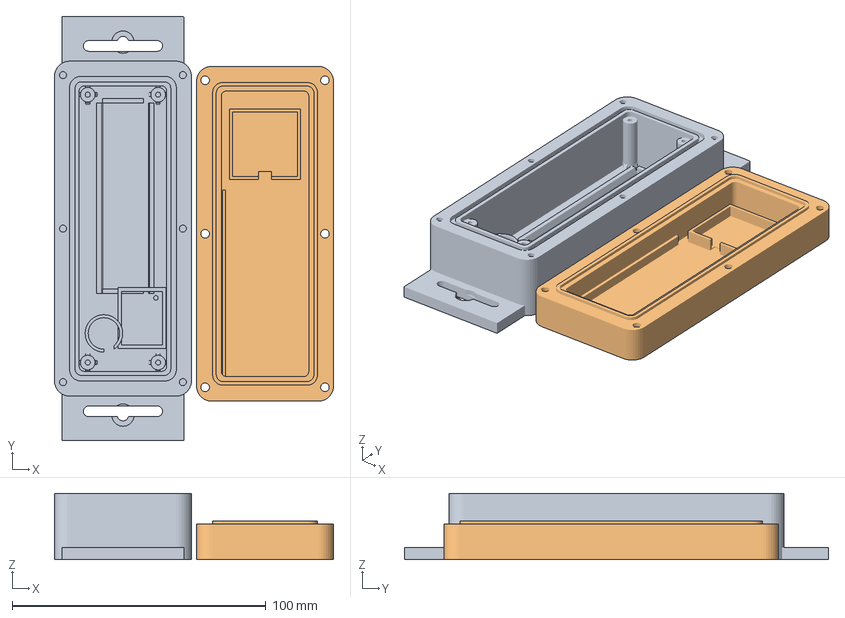
[picture p107: CAD file, 2026-10-14]
caja_3d/CollarNet_Caja_IP67.3mf
110.0 x 167.1 x 26.2 mm
caja_base_ip67_18650.stl
caja_tapa_ip67_sellada
