MorpheusSoft/CollarNet/caja_3d/caja_base_compacta_sin_bateria.stl

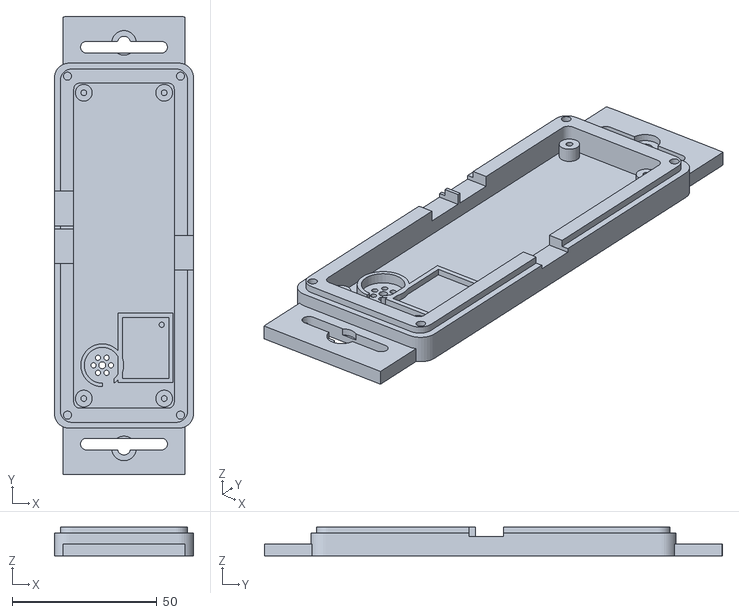
[picture p108: CAD file, 2026-10-14]
caja_3d/caja_base_compacta_sin_bateria.stl
48.0 x 158.1 x 10.0
