MorpheusSoft/CollarNet/diseno_halter_v2/visor_3d/modelos_stl/puente_texto_cowai.stl

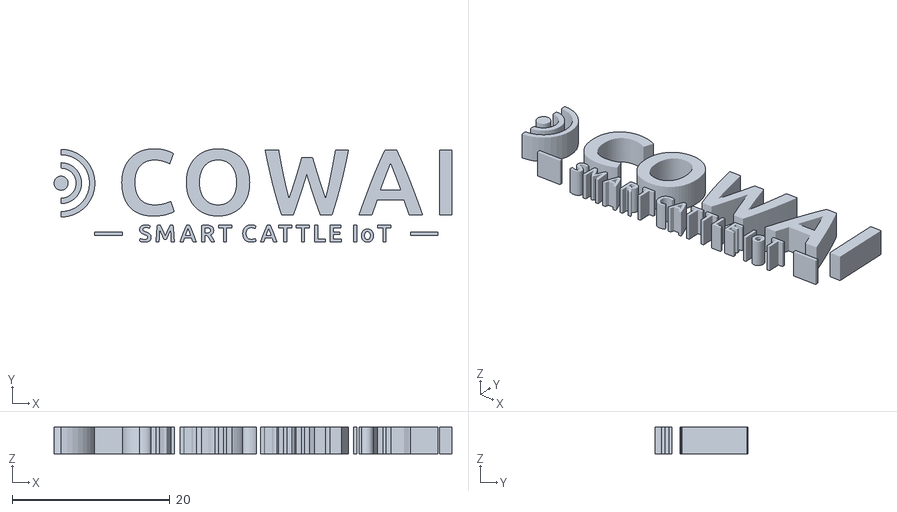
[picture p109: CAD file, 2026-10-16]
diseno_halter_v2/visor_3d/modelos_stl/puente_texto_cowai.stl
50.4 x 11.8 x 3.40
