MorpheusSoft/CollarNet/caja_3d/caja_base_campo_18650_orejetas.stl

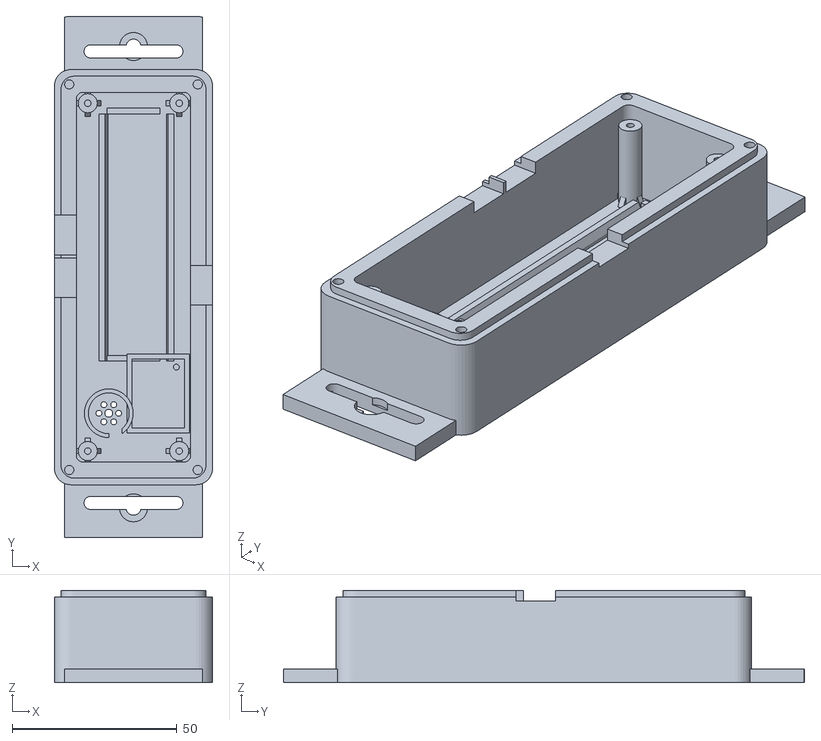
[picture p110: CAD file, 2026-10-14]
caja_3d/caja_base_campo_18650_orejetas.stl
48.0 x 158.1 x 28.0
