MorpheusSoft/CollarNet/diseno_halter_v2/visor_3d/modelos_stl/comp_mppt_bin.stl

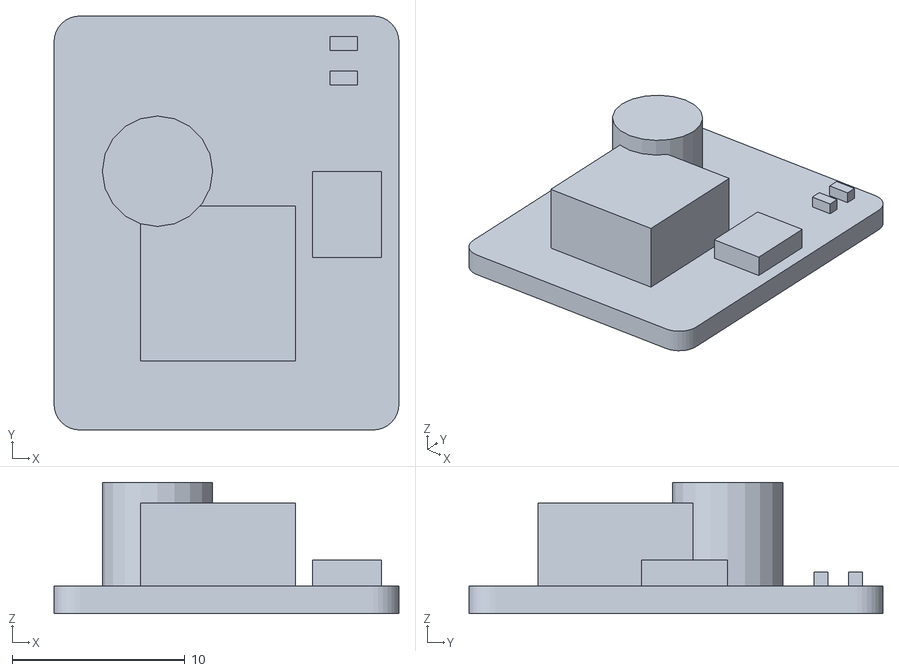
[picture p111: CAD file, 2026-10-16]
diseno_halter_v2/visor_3d/modelos_stl/comp_mppt_bin.stl
20.0 x 24.0 x 7.60
