MorpheusSoft/CollarNet/diseno_halter_v2/visor_3d/modelos_stl/comp_lilygo_bin.stl

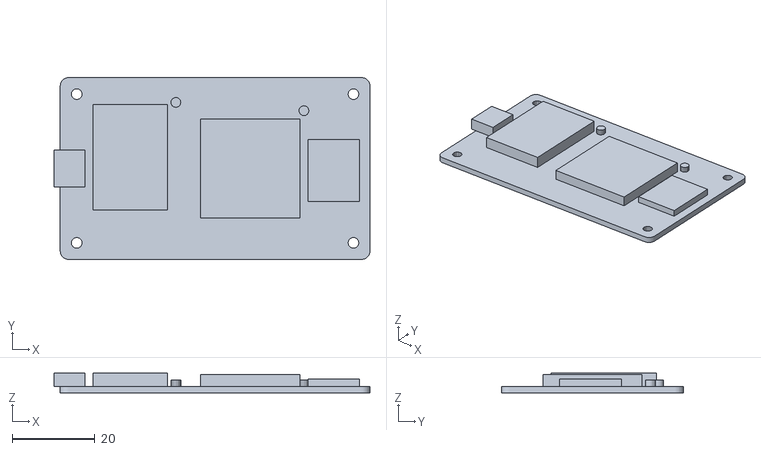
[picture p112: CAD file, 2026-10-16]
diseno_halter_v2/visor_3d/modelos_stl/comp_lilygo_bin.stl
76.5 x 44.0 x 4.80
