MorpheusSoft/CollarNet/diseno_halter_v2/visor_3d/modelos_stl/comp_arnes_bin.stl

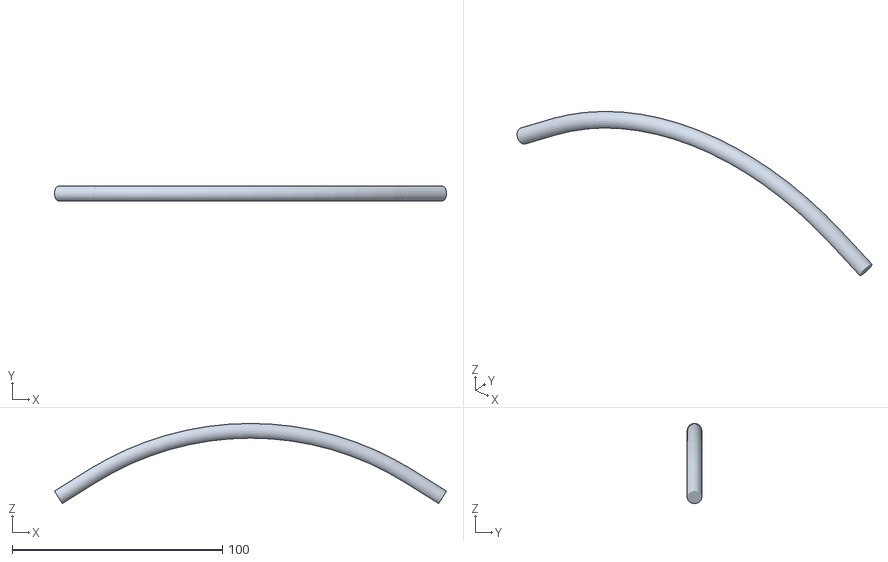
[picture p113: CAD file, 2026-10-16]
diseno_halter_v2/visor_3d/modelos_stl/comp_arnes_bin.stl
186.4 x 7.00 x 38.1
