MorpheusSoft/CollarNet/diseno_halter_v2/visor_3d/modelos_stl/capsula_derecha_tapa_solar_bin.stl

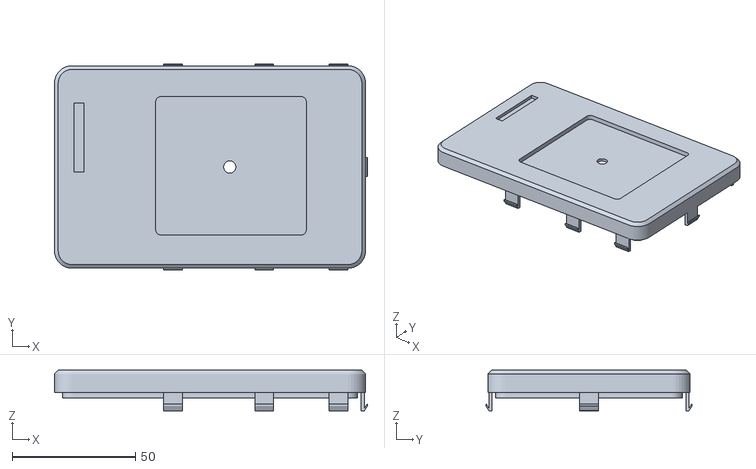
[picture p115: CAD file, 2026-10-16]
diseno_halter_v2/visor_3d/modelos_stl/capsula_derecha_tapa_solar_bin.stl
126.8 x 83.6 x 16.5
