MorpheusSoft/CollarNet/diseno_halter_v2/visor_3d/modelos_stl/junta_estanca_tpu_ip67_bin.stl

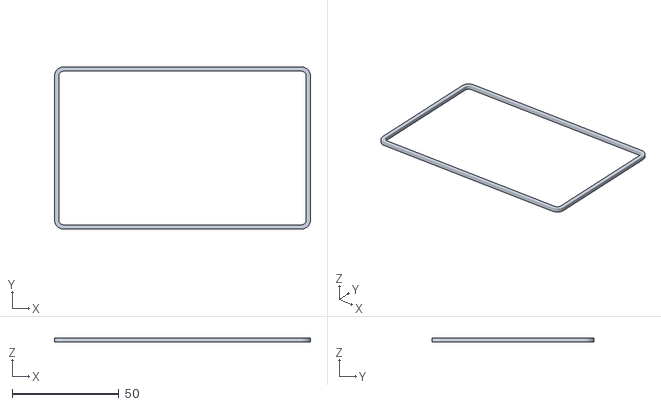
[picture p116: CAD file, 2026-10-16]
diseno_halter_v2/visor_3d/modelos_stl/junta_estanca_tpu_ip67_bin.stl
120.0 x 76.0 x 2.00
