MorpheusSoft/CollarNet/diseno_halter_v2/visor_3d/modelos_stl/comp_bateria.stl

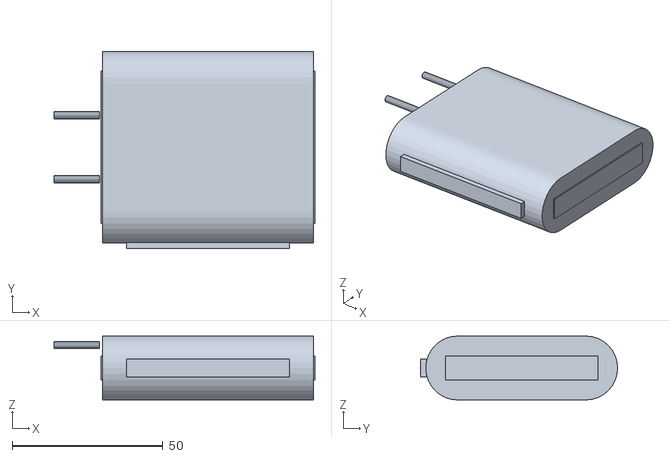
[picture p117: CAD file, 2026-10-16]
diseno_halter_v2/visor_3d/modelos_stl/comp_bateria.stl
86.5 x 65.4 x 21.2
