MorpheusSoft/CollarNet/diseno_halter_v2/inspect_probeta_iso.scad

part = "none";
include <collar_halter_v2.scad>;

tpu_socket();
