MorpheusSoft/CollarNet/diseno_halter_v2/inspect_socket.scad

part = "none";
include <collar_halter_v2.scad>;

// Let us inspect dorsal_bridge_body vs tpu_socket
dorsal_bridge_body();
