MorpheusSoft/CollarNet/diseno_halter_v2/render_imported_stl.scad

import("/home/lzambrano/Desarrollo/CollarNet/diseno_halter_v2/probetas_stl/probeta_bolsillo_tpu.stl");
