MorpheusSoft/CollarNet/diseno_halter_v2/verificacion_ensamble_xray.scad

include <collar_halter_v2.scad>;

// Full assembly with semi-transparent bridge and pods
full_assembly();
