MorpheusSoft/CollarNet/diseno_halter_v2/verificacion_puente_bottom.scad

include <collar_halter_v2.scad>;

// Underside perspective of the dorsal bridge
dorsal_bridge();
