MorpheusSoft/CollarNet/diseno_halter_v2/verificacion_puente_intrados.scad

caller_part = "none";
include <collar_halter_v2.scad>;

// Show bridge underside
rotate([180, 0, 0])
    dorsal_bridge_body();
