MorpheusSoft/CollarNet/diseno_halter_v2/test_badge_solo.scad

include <collar_halter_v2.scad>

color("White")
linear_extrude(height=1.0)
    cowai_bridge_badge_2d();
