MorpheusSoft/CollarNet/diseno_halter_v2/test_bridge_render.scad

include </home/lzambrano/Desarrollo/CollarNet/diseno_halter_v2/collar_halter_v2.scad> dorsal_bridge();
