MorpheusSoft/CollarNet/diseno_halter_v2/test_curved_bridge.scad

include <collar_halter_v2.scad>

// Previsualizar el puente con el corte curvo
color(col_bridge) dorsal_bridge_body();
color(col_text) dorsal_bridge_text();
