MorpheusSoft/CollarNet/diseno_halter_v2/test_exploded_cradle.scad

include <test_cradle_prototype.scad>

// Separados para vista explosionada
translate([-30, 0, 0]) tpu_cradle_sleeve();
translate([20, 0, 0]) asa_pod_with_step();
