MorpheusSoft/CollarNet/(list of files, cad)

Other CAD files:
diseno_halter_v2/visor_3d/modelos_stl/collar_halter_v2_completo_ensamble_bin.stl
diseno_halter_v2/visor_3d/modelos_stl/comp_solar.stl
caja_3d/caja_tapa_campo_estanca.stl
diseno_halter_v2/visor_3d/modelos_stl/comp_cincha.stl
logo_3d_cow_ai/vaca_cuadrante_sup_der.stl
diseno_halter_v2/visor_3d/modelos_stl/puente_dorsal_cowai_bin.stl
diseno_halter_v2/visor_3d/modelos_stl/capsula_derecha_base_bateria_21700_bin.stl
diseno_halter_v2/visor_3d/modelos_stl/comp_arnes.stl
diseno_halter_v2/visor_3d/modelos_stl/puente_dorsal_cowai.stl
diseno_halter_v2/visor_3d/modelos_stl/comp_antena_bin.stl
diseno_halter_v2/visor_3d/modelos_stl/capsula_derecha_base_bateria_21700.stl
diseno_halter_v2/visor_3d/modelos_stl/comp_lilygo.stl
diseno_halter_v2/visor_3d/modelos_stl/puente_texto_cowai_bin.stl
diseno_halter_v2/visor_3d/modelos_stl/capsula_izquierda_base_lilygo_bin.stl
diseno_halter_v2/visor_3d/modelos_stl/comp_buzzer_bin.stl
logo_3d_cow_ai/letra_C.scad
logo_3d_cow_ai/letra_I.scad
logo_3d_cow_ai/letra_O.scad
logo_3d_cow_ai/letra_W.scad
logo_3d_cow_ai/vaca_cuadrante_inf_izq.scad
logo_3d_cow_ai/vaca_cuadrante_sup_der.scad
logo_3d_cow_ai/vaca_cuadrante_sup_izq.scad
diseno_halter_v2/test_bridge_peak.scad
diseno_halter_v2/test_chamfer_tongue.scad
diseno_halter_v2/test_full_cradle_assembly.scad
diseno_halter_v2/test_full_cradle_bridge.scad
diseno_halter_v2/test_logo_halter.scad
diseno_halter_v2/test_part_none.scad
diseno_halter_v2/test_pod_clamshell_full.scad
diseno_halter_v2/test_snap_fit_click.scad
diseno_halter_v2/test_tpu_socket_fixed.scad
diseno_halter_v2/test_vol.scad
caja_3d/junta_tpu_ip67.stl
diseno_halter_v2/probetas_stl/probeta_bolsillo_tpu.stl
diseno_halter_v2/probetas_stl/probeta_click_ip67_tapa.stl
diseno_halter_v2/puente_dorsal_cowai.stl
