MorpheusSoft/CollarNet/caja_3d/preview_assembly.png

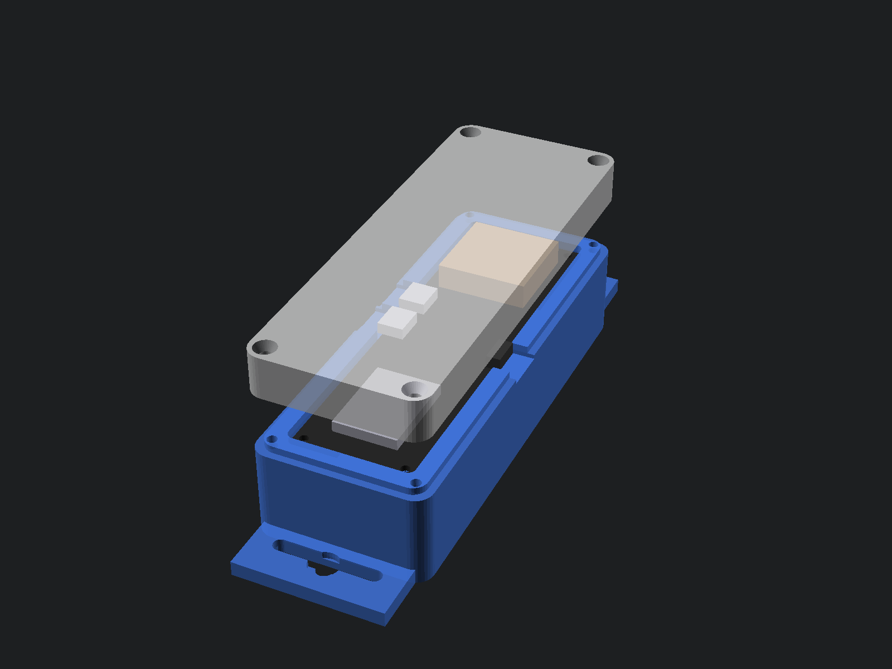
caja_3d/preview_assembly.png
