MorpheusSoft/CollarNet/caja_3d/preview_assembly_revb.png

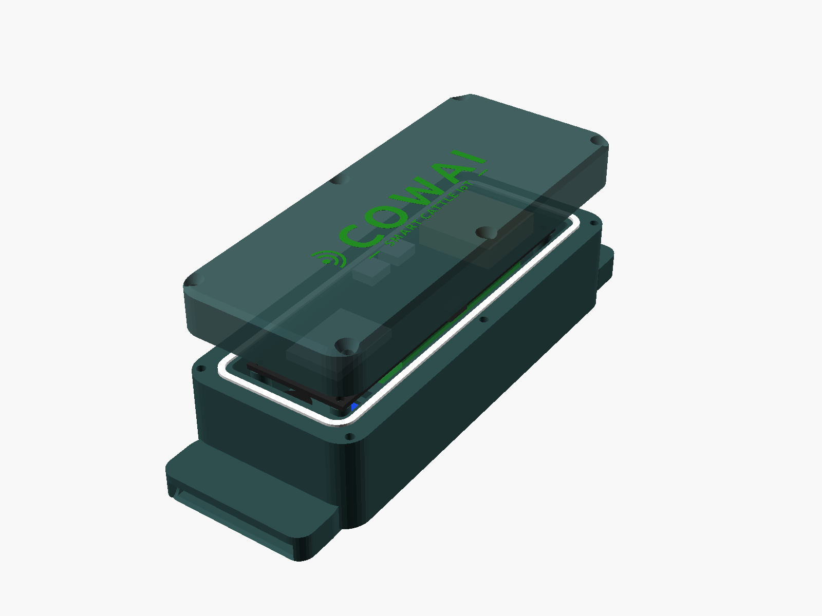
caja_3d/preview_assembly_revb.png
