MorpheusSoft/CollarNet/caja_3d/preview_assembly_revc.png

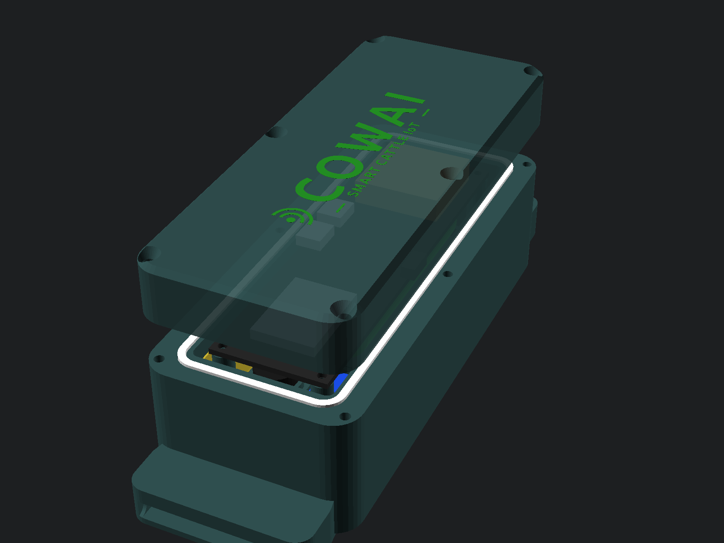
caja_3d/preview_assembly_revc.png
