MorpheusSoft/CollarNet/diseno_halter_v2/renders/1_ensamble_deslizante_bolsillo.png

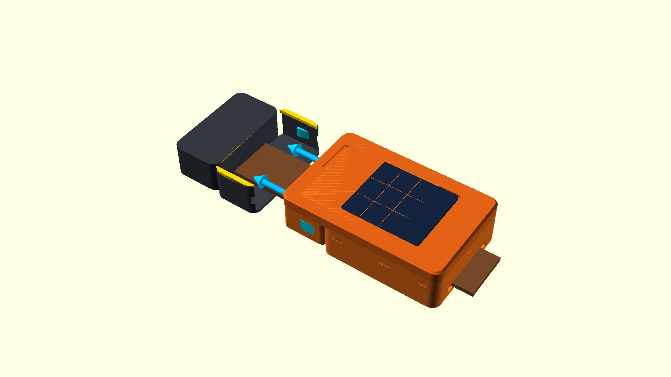
diseno_halter_v2/renders/1_ensamble_deslizante_bolsillo.png
