MorpheusSoft/CollarNet/diseno_halter_v2/renders/preview_assembly_3d.png

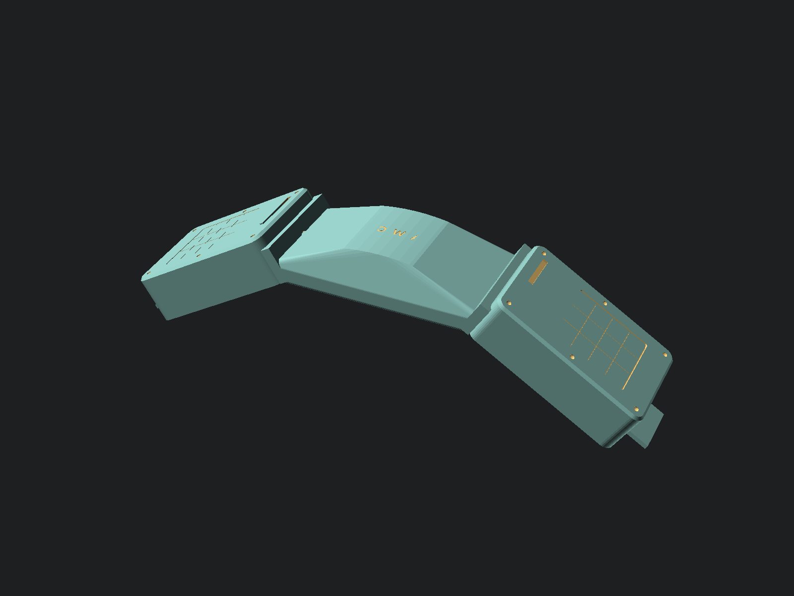
diseno_halter_v2/renders/preview_assembly_3d.png
