MorpheusSoft/CollarNet/diseno_halter_v2/renders/preview_assembly_nature.png

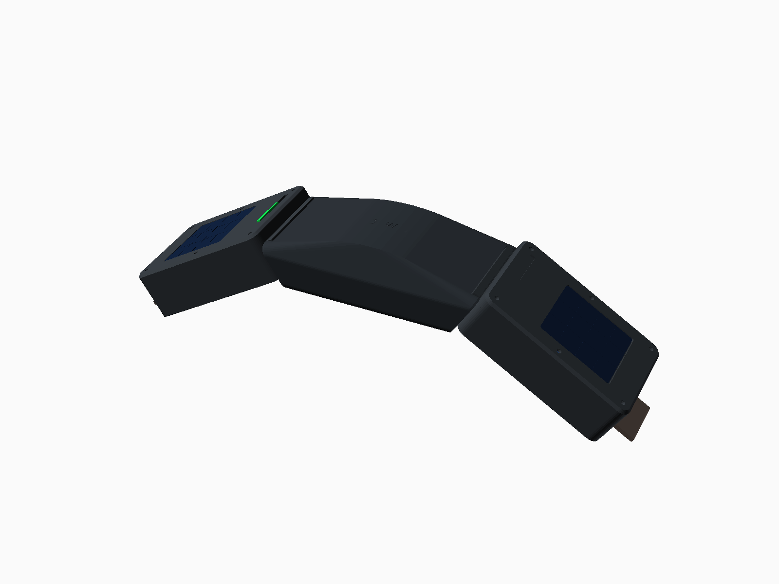
diseno_halter_v2/renders/preview_assembly_nature.png
