MorpheusSoft/CollarNet/diseno_halter_v2/renders/preview_assembly_top.png

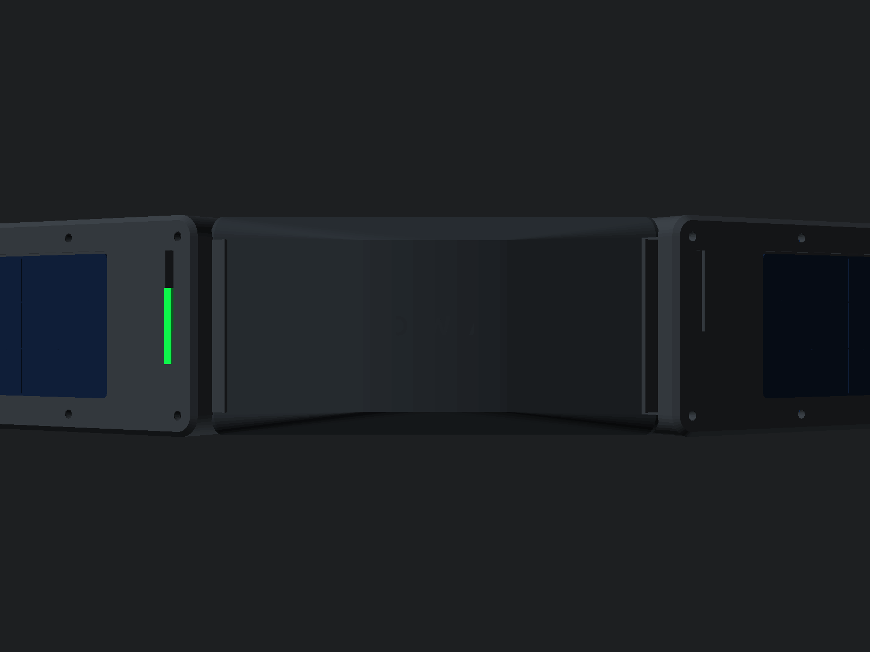
diseno_halter_v2/renders/preview_assembly_top.png
