MorpheusSoft/CollarNet/diseno_halter_v2/renders/preview_how_it_assembles_eye.png

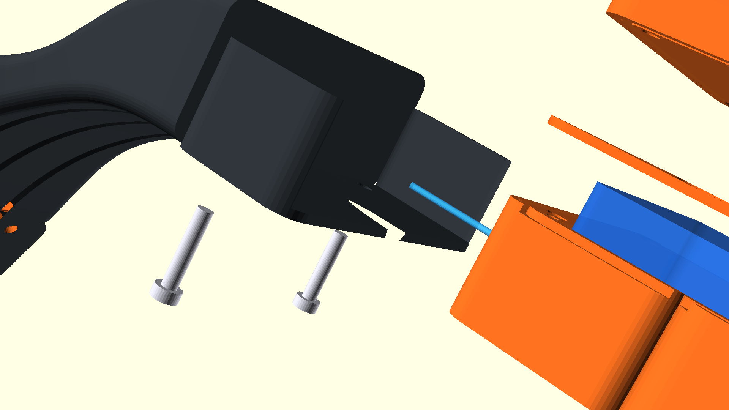
diseno_halter_v2/renders/preview_how_it_assembles_eye.png
