MorpheusSoft/CollarNet/diseno_halter_v2/renders/preview_how_it_assembles_snap_fit.png

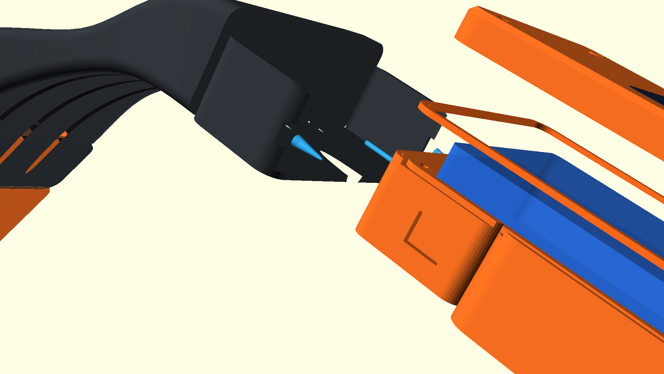
diseno_halter_v2/renders/preview_how_it_assembles_snap_fit.png
