MorpheusSoft/CollarNet/diseno_halter_v2/renders/preview_hybrid_assembly_final_iso.png

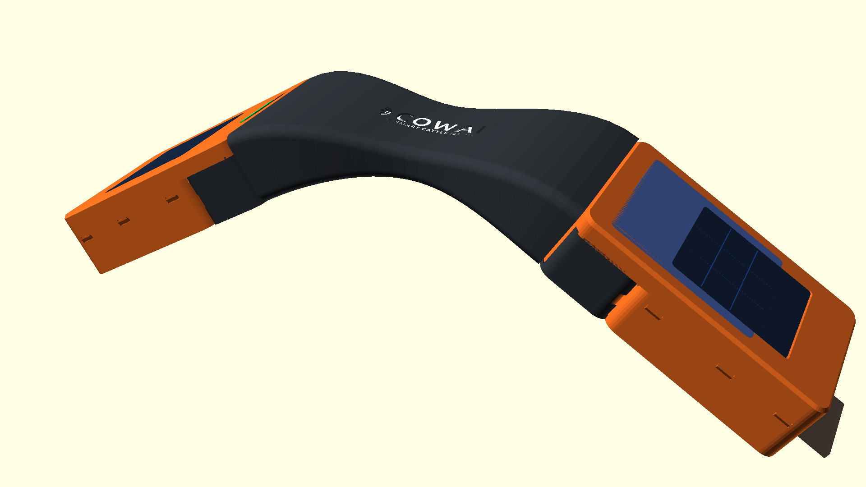
diseno_halter_v2/renders/preview_hybrid_assembly_final_iso.png
