MorpheusSoft/CollarNet/diseno_halter_v2/renders/preview_hybrid_assembly_front.png

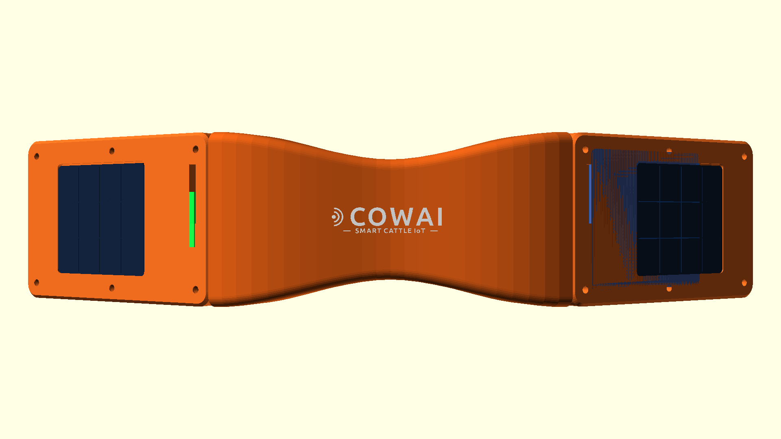
diseno_halter_v2/renders/preview_hybrid_assembly_front.png
