MorpheusSoft/CollarNet/diseno_halter_v2/renders/preview_hybrid_assembly_side_arch.png

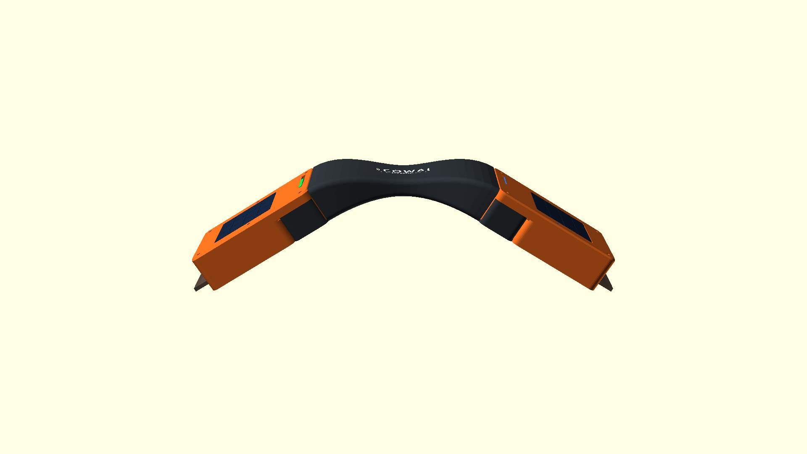
diseno_halter_v2/renders/preview_hybrid_assembly_side_arch.png
