MorpheusSoft/CollarNet/diseno_halter_v2/renders/preview_print_bed.png

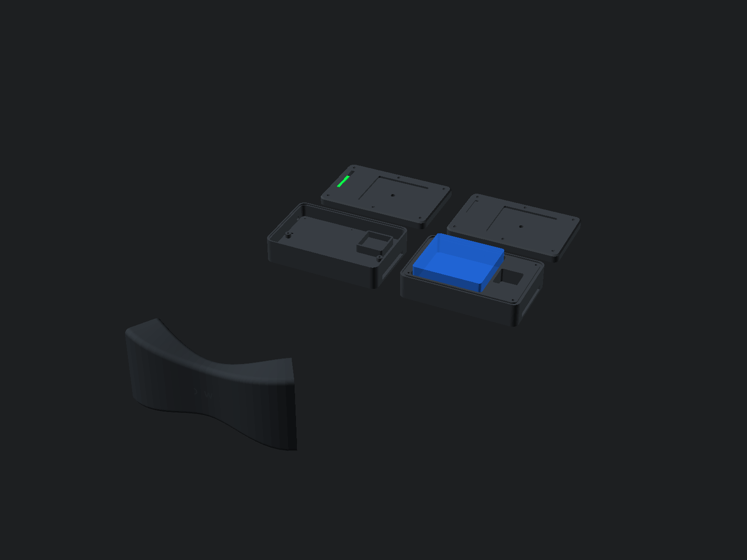
diseno_halter_v2/renders/preview_print_bed.png
