MorpheusSoft/CollarNet/diseno_halter_v2/test_assembly_chamfer.png

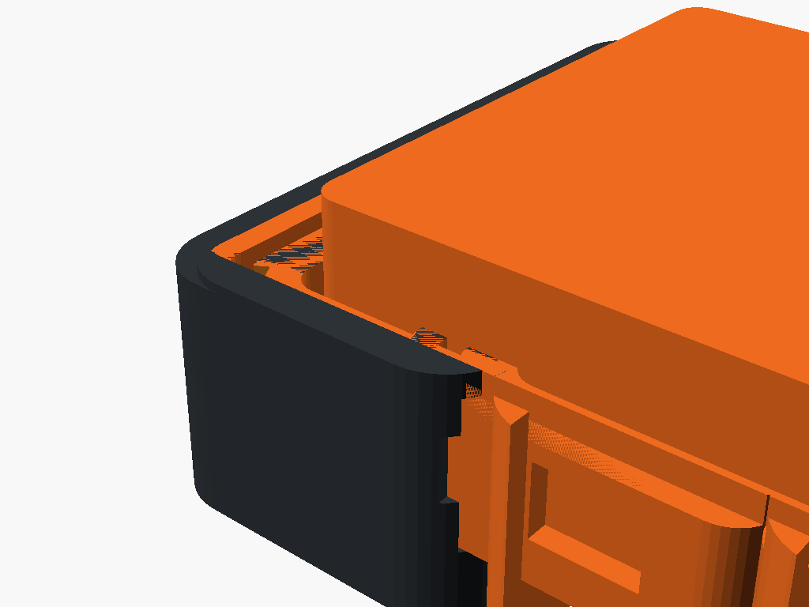
diseno_halter_v2/test_assembly_chamfer.png
