MorpheusSoft/CollarNet/diseno_halter_v2/test_assembly_check.png

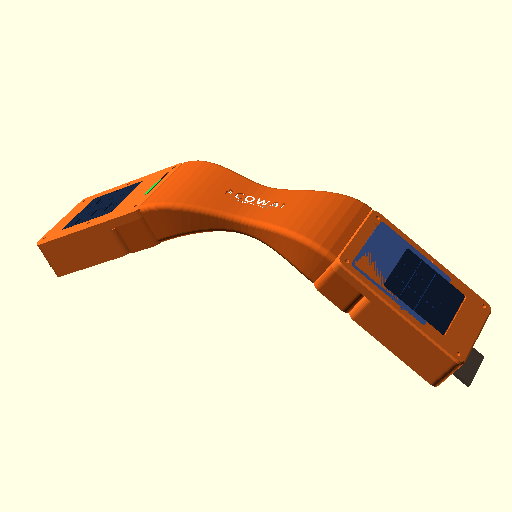
diseno_halter_v2/test_assembly_check.png
