MorpheusSoft/CollarNet/caja_3d/preview_test.png

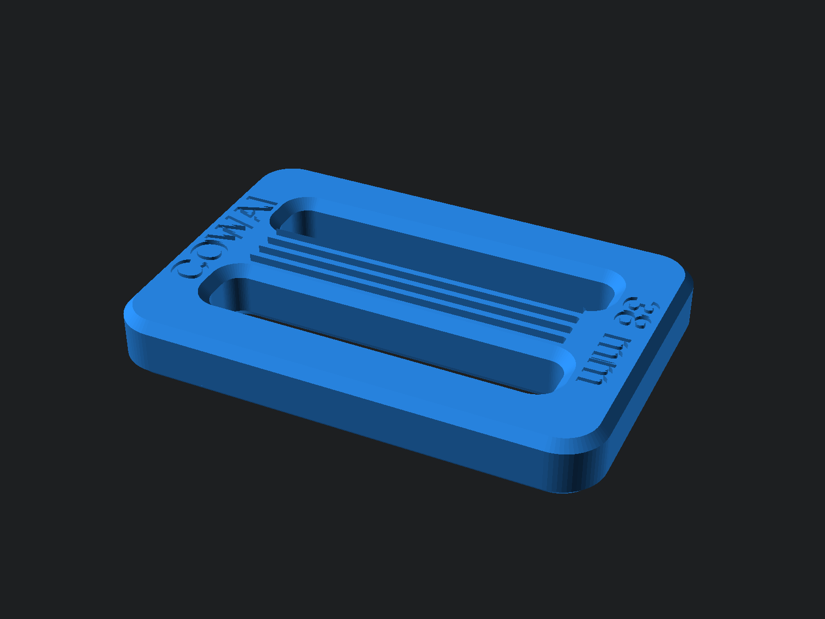
caja_3d/preview_test.png
