MorpheusSoft/CollarNet/diseno_halter_v2/renders/test_angle_110.png

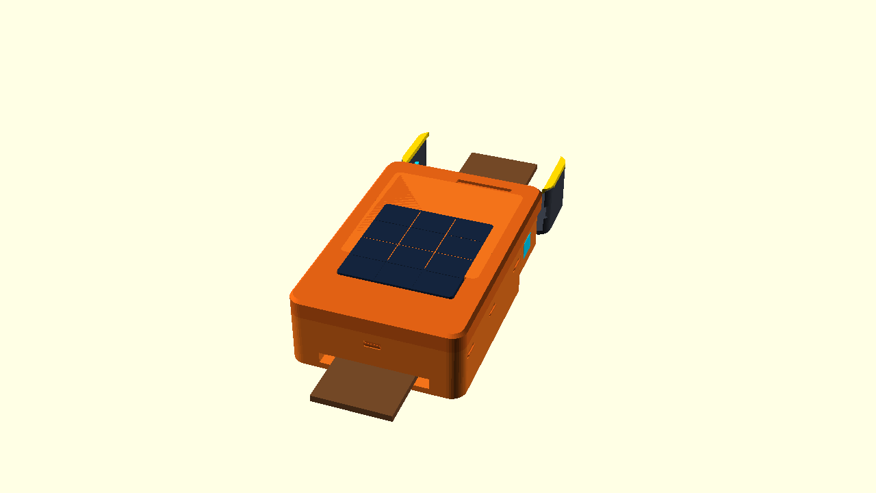
diseno_halter_v2/renders/test_angle_110.png
