MorpheusSoft/CollarNet/diseno_halter_v2/renders/test_bridge.png

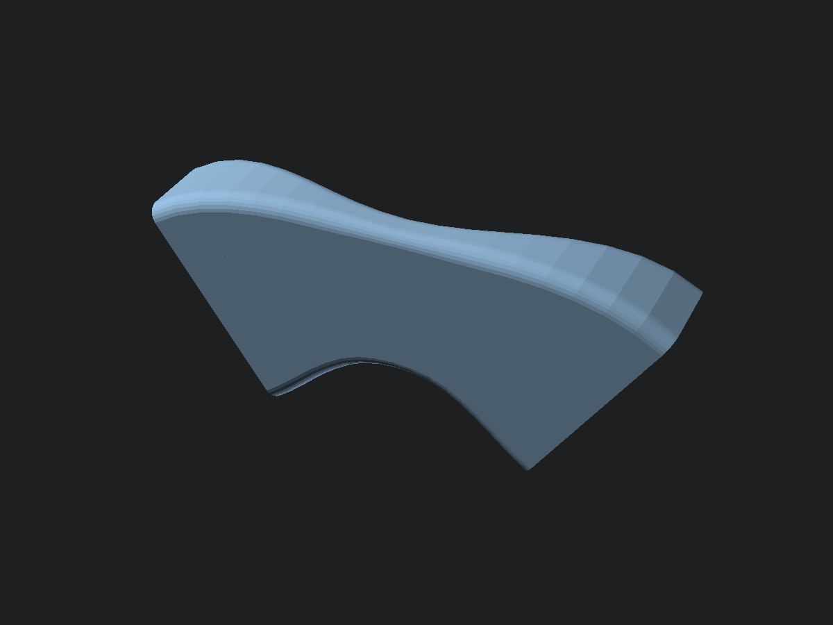
diseno_halter_v2/renders/test_bridge.png
