MorpheusSoft/CollarNet/diseno_halter_v2/renders/test_bridge_fixed.png

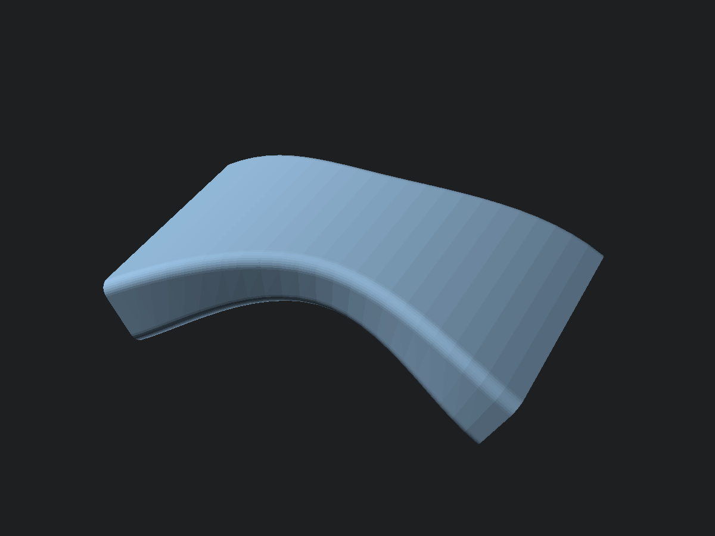
diseno_halter_v2/renders/test_bridge_fixed.png
