MorpheusSoft/CollarNet/diseno_halter_v2/renders/test_bridge_peak.png

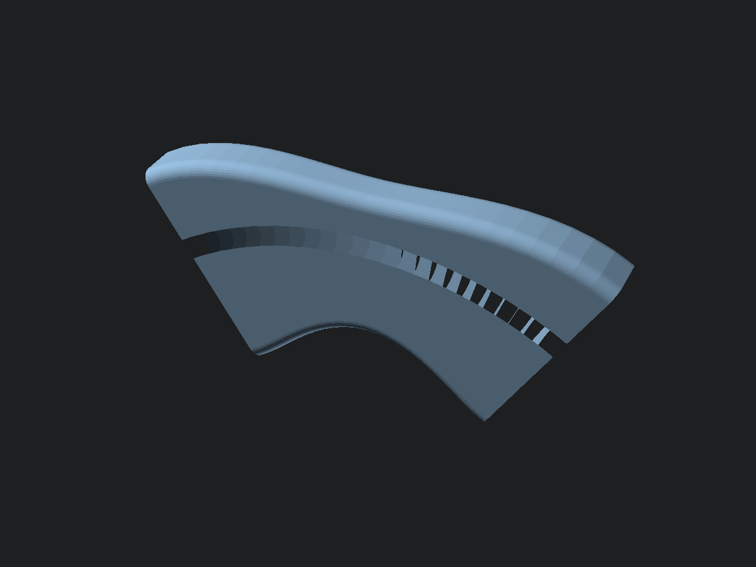
diseno_halter_v2/renders/test_bridge_peak.png
