MorpheusSoft/CollarNet/diseno_halter_v2/renders/test_clamshell_ip67.png

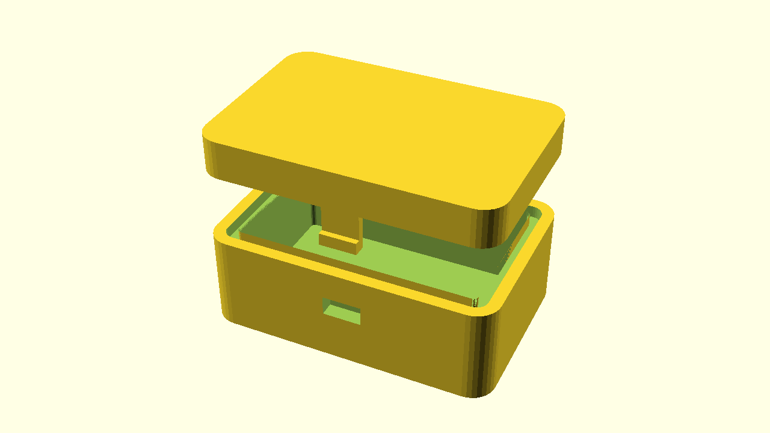
diseno_halter_v2/renders/test_clamshell_ip67.png
