MorpheusSoft/CollarNet/diseno_halter_v2/renders/test_corte_autocenter.png

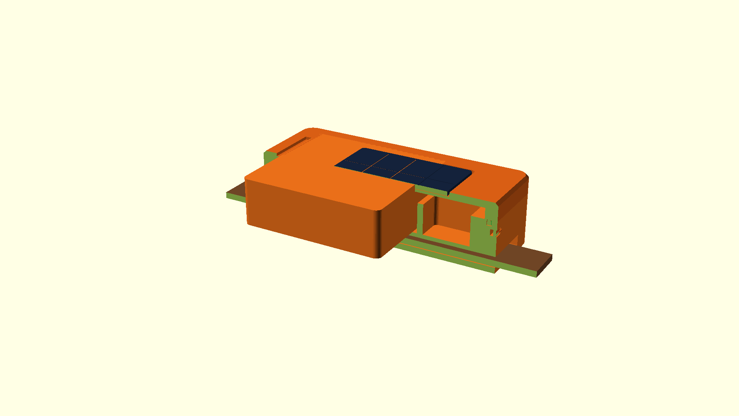
diseno_halter_v2/renders/test_corte_autocenter.png
