MorpheusSoft/CollarNet/diseno_halter_v2/renders/test_cradle_exploded_render.png

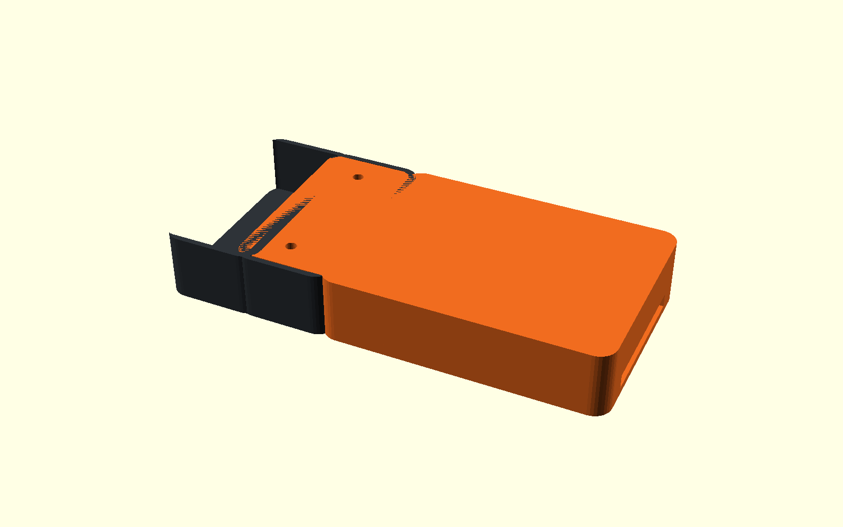
diseno_halter_v2/renders/test_cradle_exploded_render.png
