MorpheusSoft/CollarNet/diseno_halter_v2/renders/test_crest_fixed.png

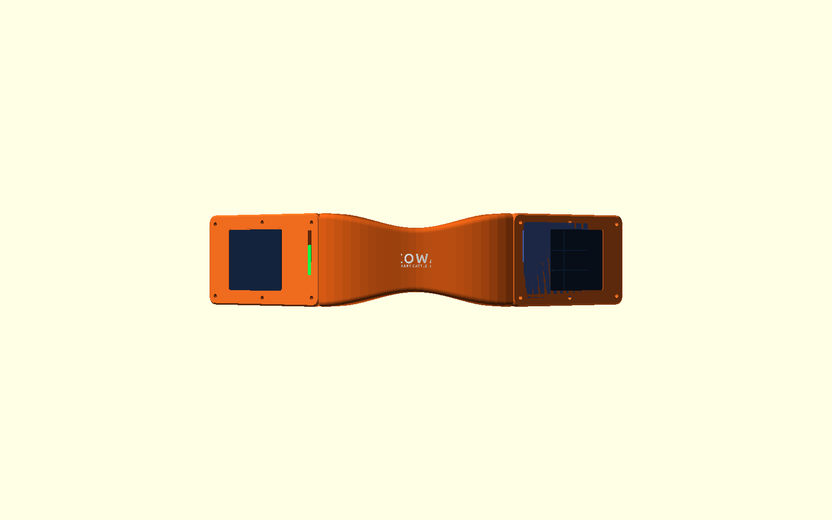
diseno_halter_v2/renders/test_crest_fixed.png
