MorpheusSoft/CollarNet/diseno_halter_v2/renders/test_crest_zoom.png

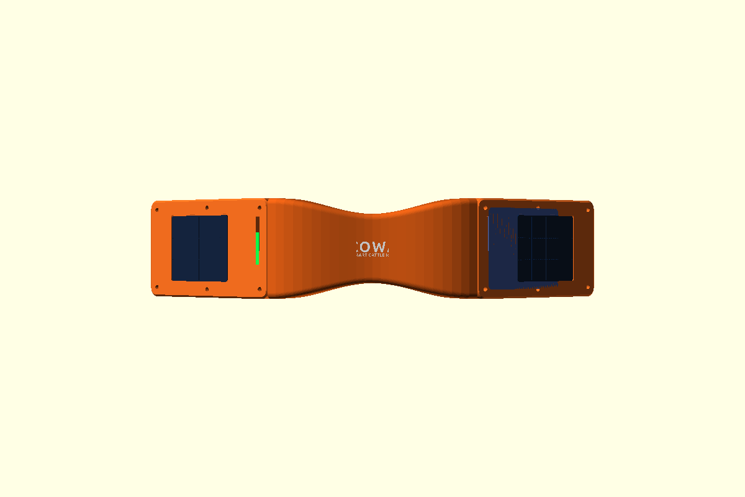
diseno_halter_v2/renders/test_crest_zoom.png
