MorpheusSoft/CollarNet/diseno_halter_v2/renders/test_perfect_render.png

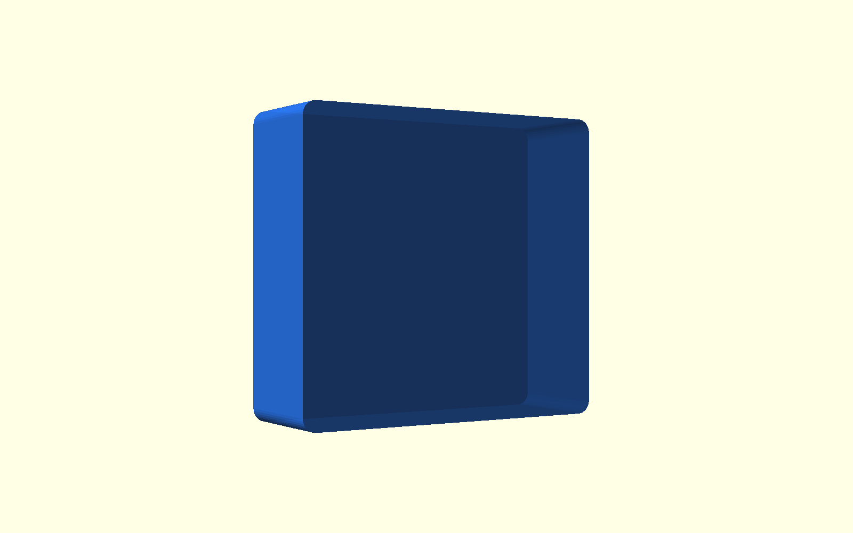
diseno_halter_v2/renders/test_perfect_render.png
