MorpheusSoft/CollarNet/diseno_halter_v2/renders/test_pod_clamshell_full.png

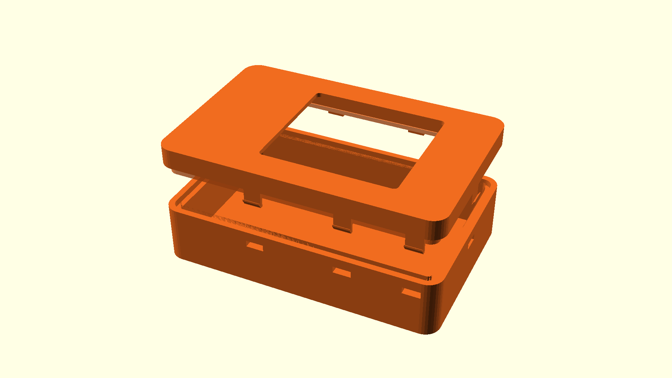
diseno_halter_v2/renders/test_pod_clamshell_full.png
