MorpheusSoft/CollarNet/diseno_halter_v2/renders/test_real_crest_render.png

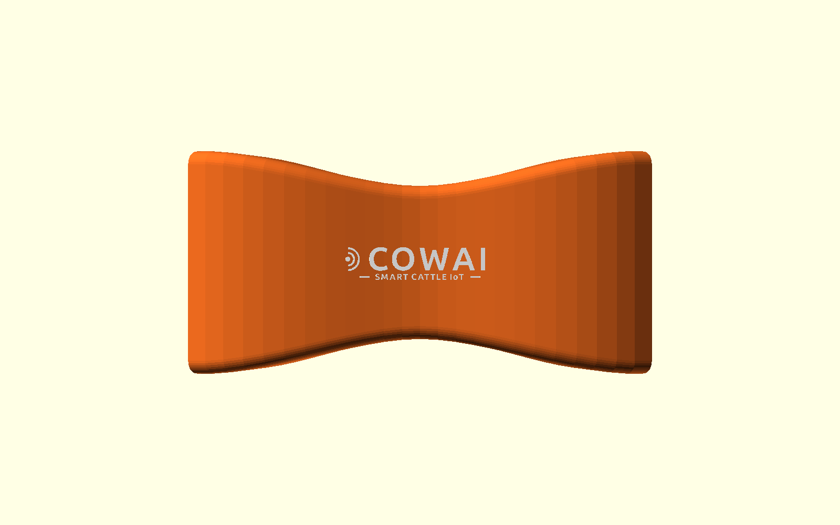
diseno_halter_v2/renders/test_real_crest_render.png
