MorpheusSoft/CollarNet/diseno_halter_v2/renders/test_section_clamshell.png

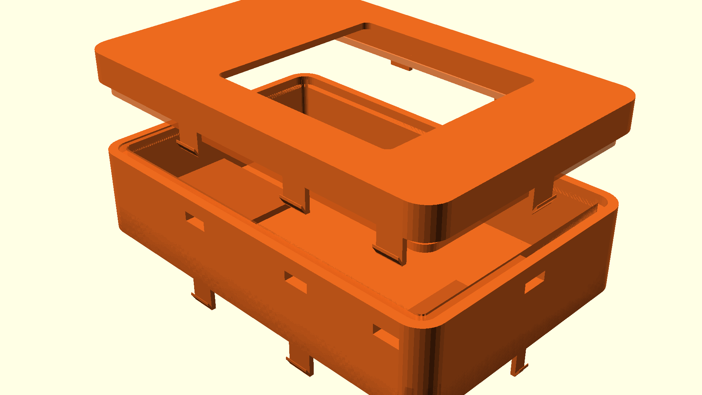
diseno_halter_v2/renders/test_section_clamshell.png
