MorpheusSoft/CollarNet/diseno_halter_v2/renders/test_tpu_both_teeth.png

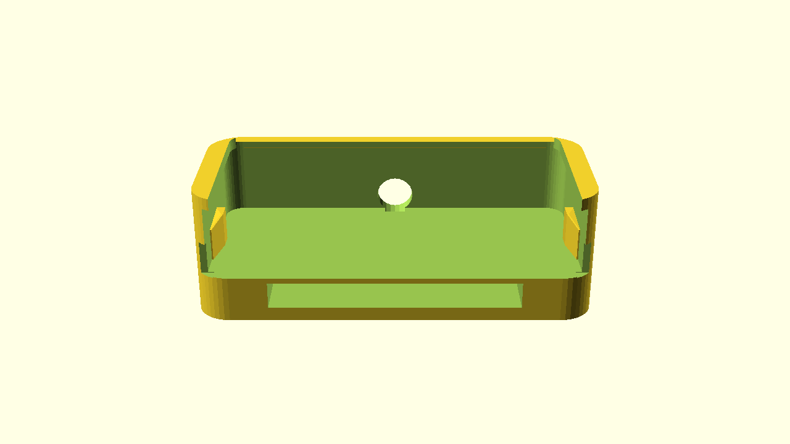
diseno_halter_v2/renders/test_tpu_both_teeth.png
