MorpheusSoft/CollarNet/diseno_halter_v2/renders/test_tpu_socket_fixed.png

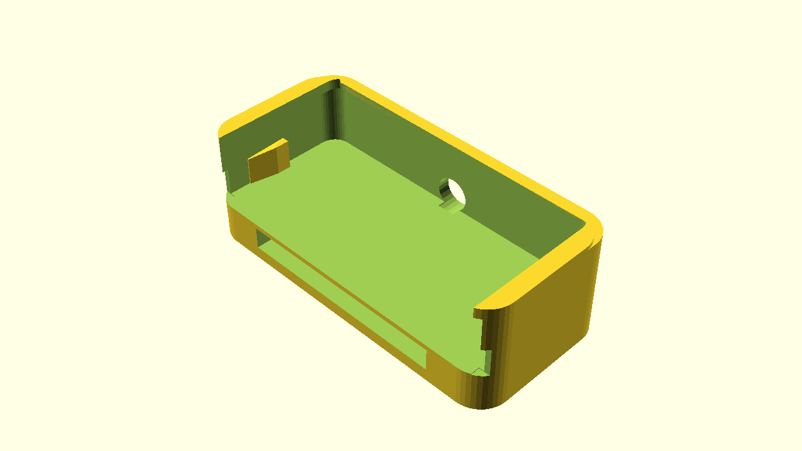
diseno_halter_v2/renders/test_tpu_socket_fixed.png
