MorpheusSoft/CollarNet/diseno_halter_v2/renders/verificacion_corte_lateral_puro.png

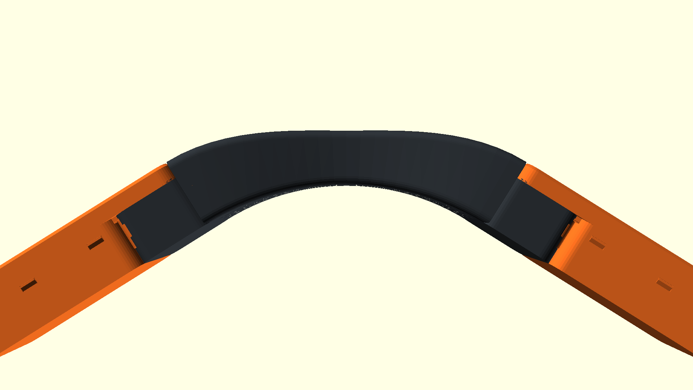
diseno_halter_v2/renders/verificacion_corte_lateral_puro.png
