MorpheusSoft/CollarNet/diseno_halter_v2/renders/verificacion_corte_longitudinal.png

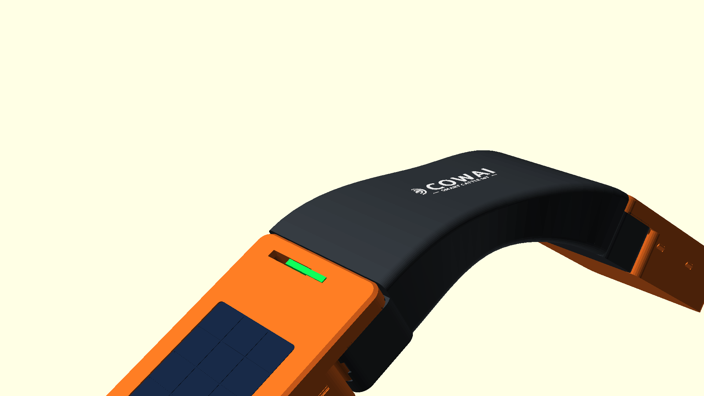
diseno_halter_v2/renders/verificacion_corte_longitudinal.png
