MorpheusSoft/CollarNet/diseno_halter_v2/renders/verificacion_corte_longitudinal_iso.png

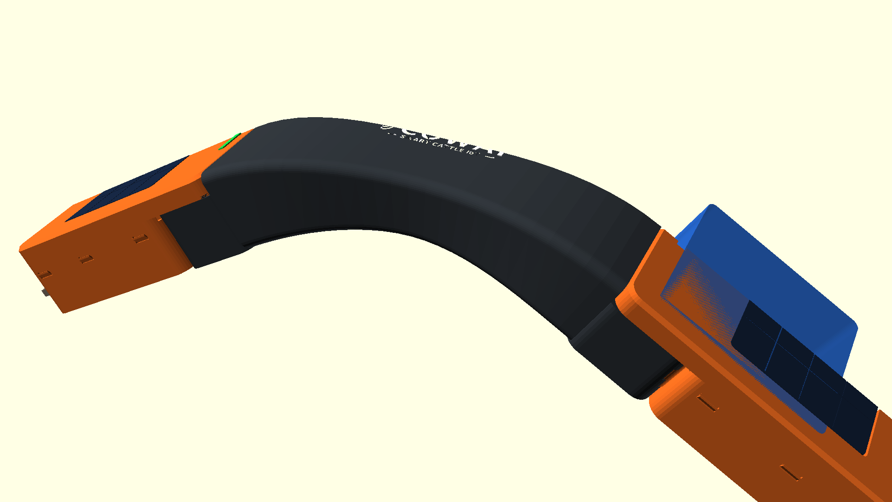
diseno_halter_v2/renders/verificacion_corte_longitudinal_iso.png
