MorpheusSoft/CollarNet/diseno_halter_v2/renders/verificacion_corte_longitudinal_lateral.png

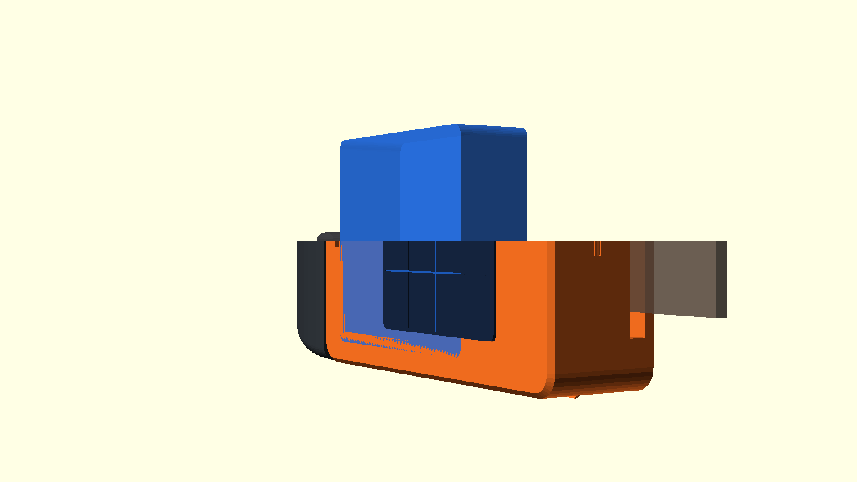
diseno_halter_v2/renders/verificacion_corte_longitudinal_lateral.png
