MorpheusSoft/CollarNet/diseno_halter_v2/renders/verificacion_ensamble_halter_opcion_a.png

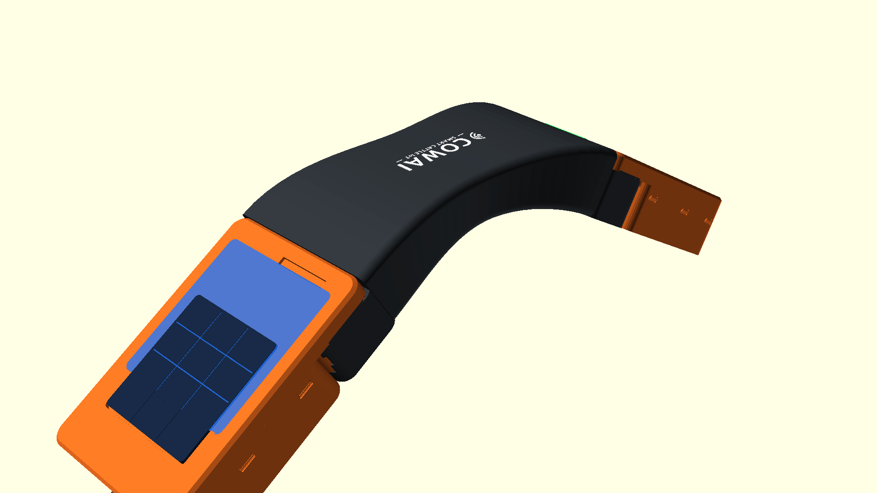
diseno_halter_v2/renders/verificacion_ensamble_halter_opcion_a.png
