MorpheusSoft/CollarNet/diseno_halter_v2/renders/verificacion_ensamble_xray.png

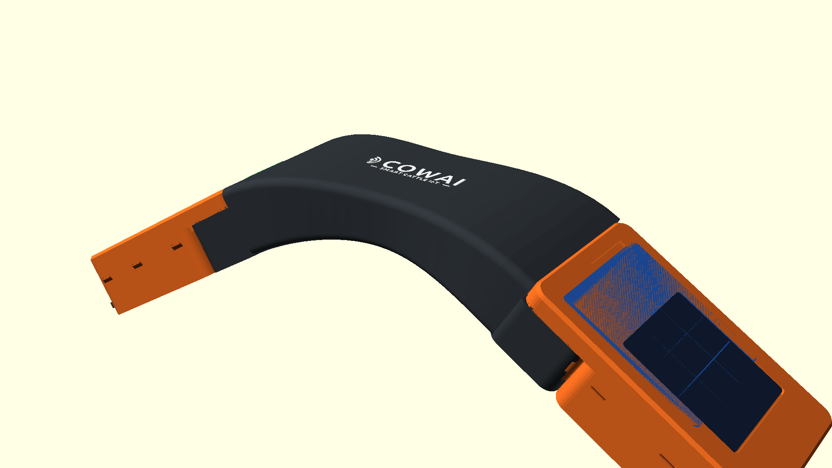
diseno_halter_v2/renders/verificacion_ensamble_xray.png
