MorpheusSoft/CollarNet/diseno_halter_v2/renders/verificacion_estanqueidad_ip67_corte.png

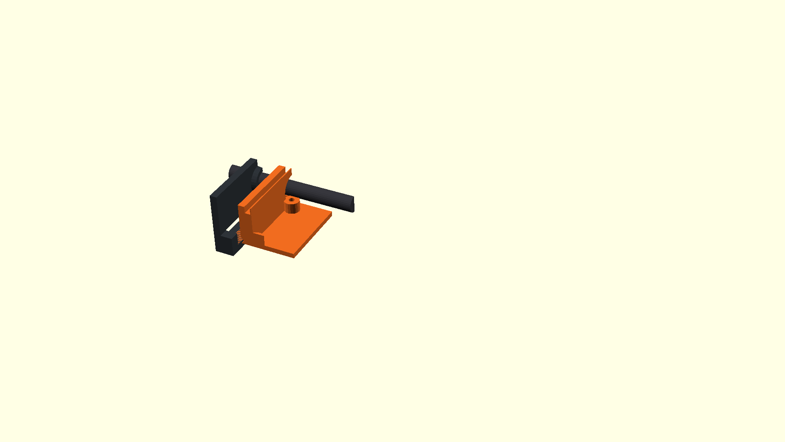
diseno_halter_v2/renders/verificacion_estanqueidad_ip67_corte.png
