MorpheusSoft/CollarNet/diseno_halter_v2/renders/verificacion_ip67_detail.png

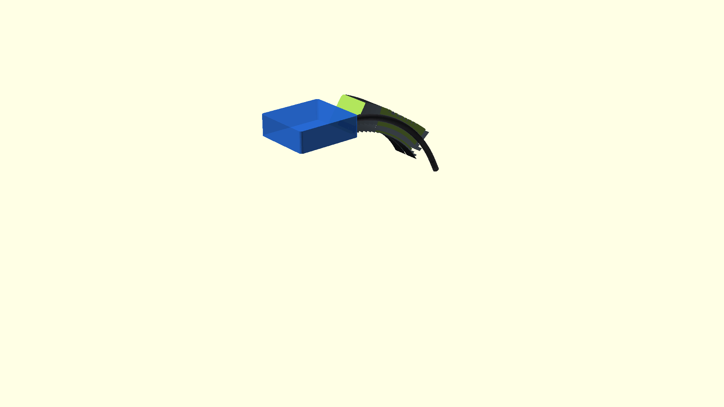
diseno_halter_v2/renders/verificacion_ip67_detail.png
