MorpheusSoft/CollarNet/diseno_halter_v2/renders/verificacion_puente_intrados.png

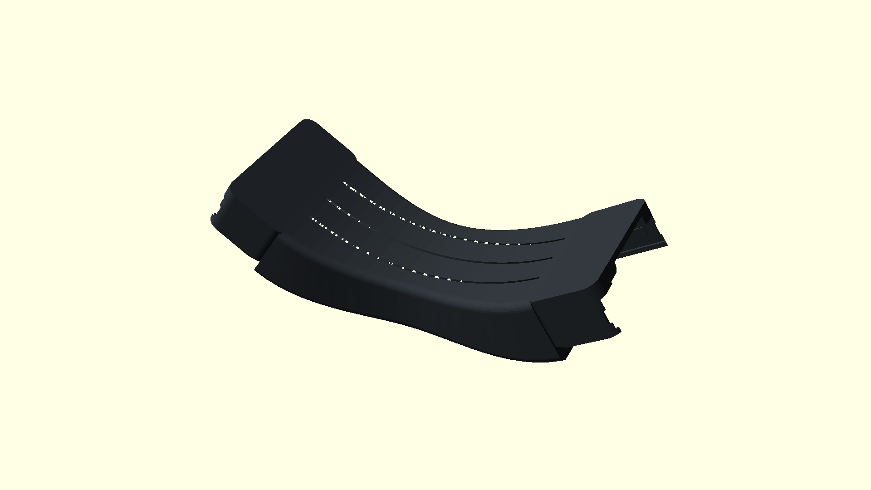
diseno_halter_v2/renders/verificacion_puente_intrados.png
