MorpheusSoft/CollarNet/diseno_halter_v2/test_chamfer.png

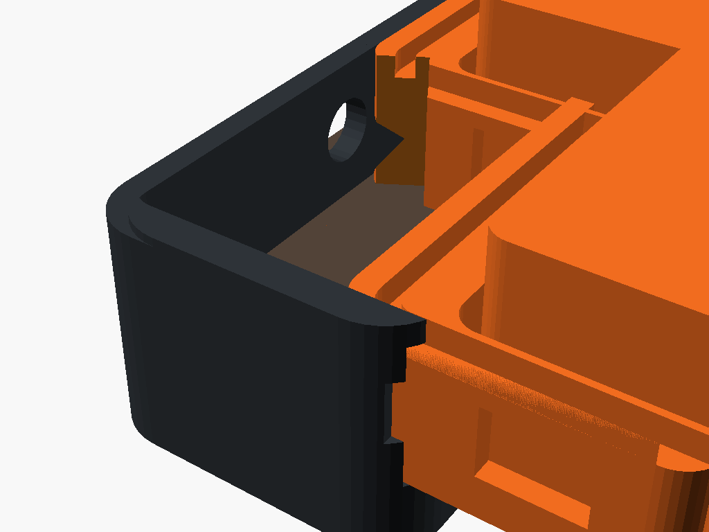
diseno_halter_v2/test_chamfer.png
