MorpheusSoft/CollarNet/diseno_halter_v2/test_chamfer_iso.png

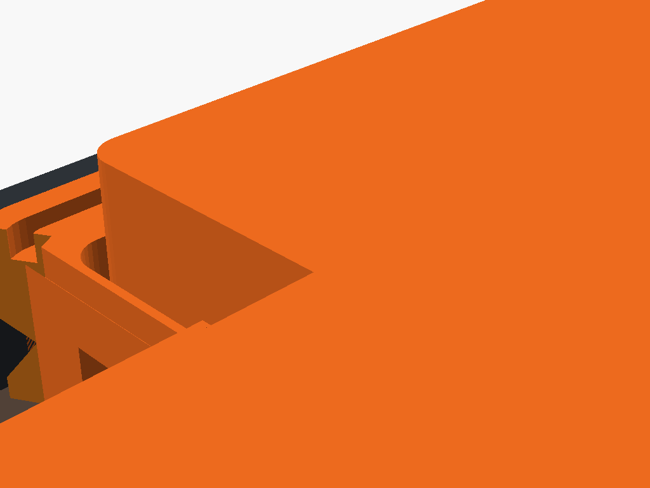
diseno_halter_v2/test_chamfer_iso.png
