MorpheusSoft/CollarNet/diseno_halter_v2/test_click_section.png

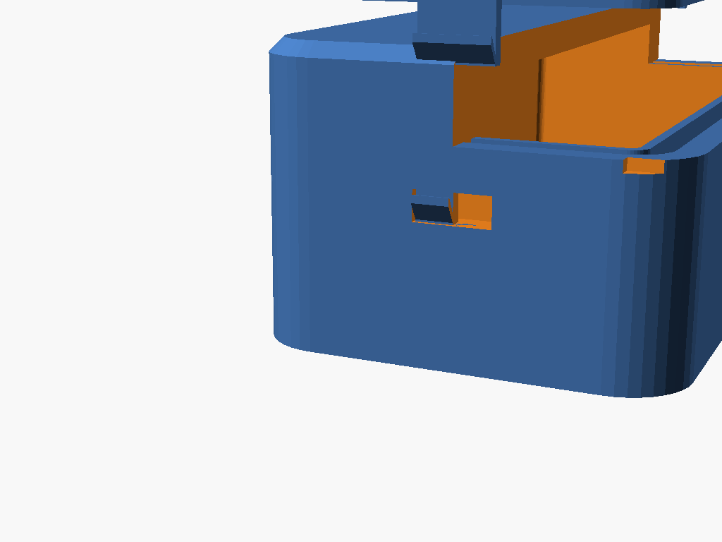
diseno_halter_v2/test_click_section.png
