MorpheusSoft/CollarNet/diseno_halter_v2/test_closed_neck.png

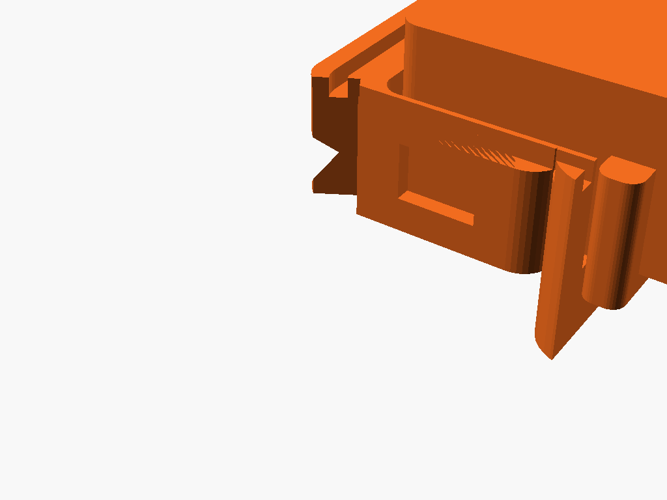
diseno_halter_v2/test_closed_neck.png
