MorpheusSoft/CollarNet/diseno_halter_v2/test_pod_left.png

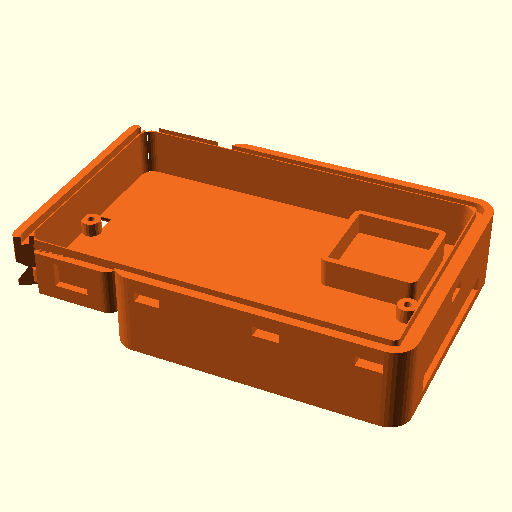
diseno_halter_v2/test_pod_left.png
