MorpheusSoft/CollarNet/diseno_halter_v2/test_standalone_click_box.png

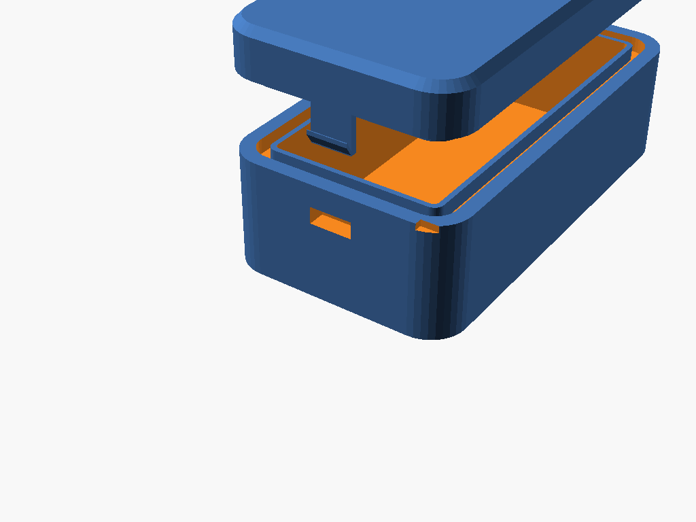
diseno_halter_v2/test_standalone_click_box.png
