MorpheusSoft/CollarNet/docs/diseno_electronico_pcb/verificacion_th1.png

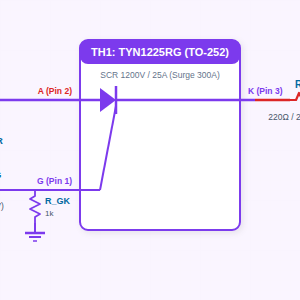
docs/diseno_electronico_pcb/verificacion_th1.png
