MorpheusSoft/CollarNet/diseno_halter_v2/renders/debug_probeta_bolsillo.png

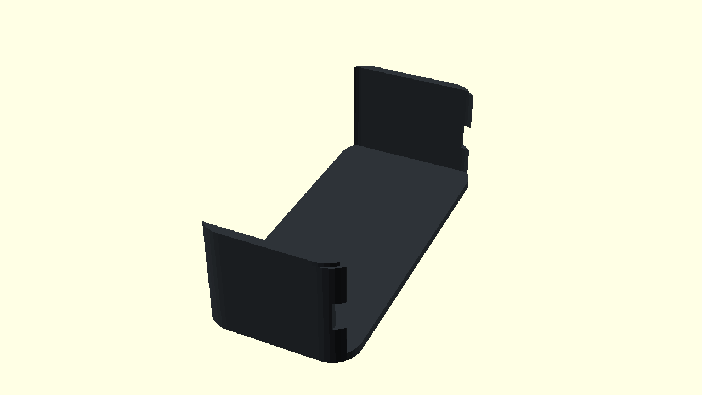
diseno_halter_v2/renders/debug_probeta_bolsillo.png
