MorpheusSoft/CollarNet/CollarNet_V3_70x70_Planos_Ingenieria.pdf

A

B

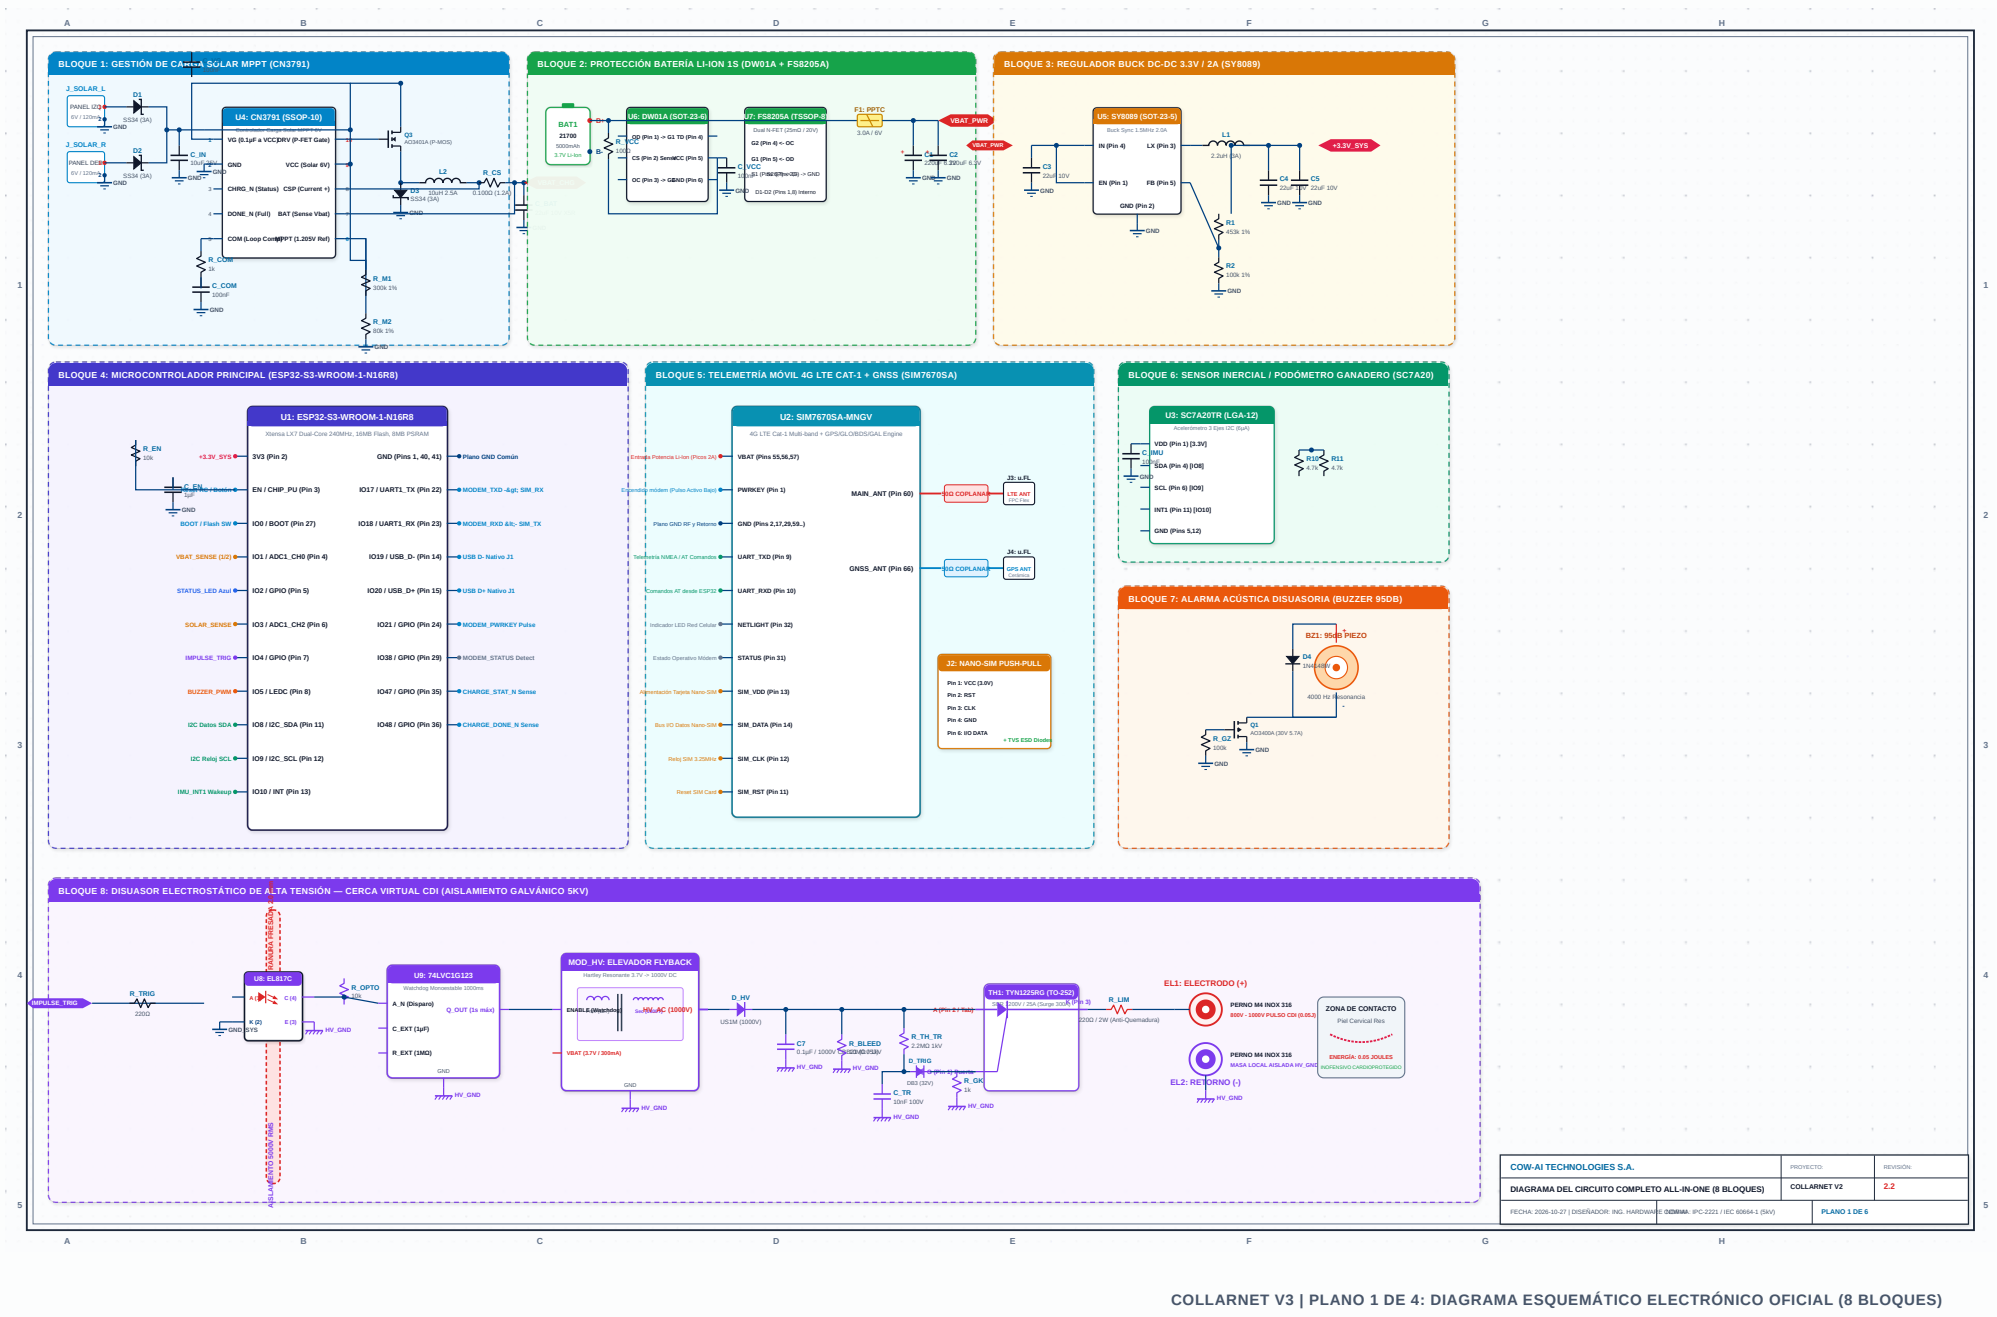
[picture p173: page 1]

BLOQUE 1: GESTIÓN DE CARGA SOLAR MPPT (CN3791)

BLOQUE 2: PROTECCIÓN BATERÍA LI-ION 1S (DW01A + FS8205A)

BLOQUE 3: REGULADOR BUCK DC-DC 3.3V / 2A (SY8089)

Controlador Carga Solar MPPT 6V

BLOQUE 4: MICROCONTROLADOR PRINCIPAL (ESP32-S3-WROOM-1-N16R8)

BLOQUE 5: TELEMETRÍA MÓVIL 4G LTE CAT-1 + GNSS (SIM7670SA)

BLOQUE 6: SENSOR INERCIAL / PODÓMETRO GANADERO (SC7A20)

Xtensa LX7 Dual-Core 240MHz, 16MB Flash, 8MB PSRAM

4G LTE Cat-1 Multi-band + GPS/GLO/BDS/GAL Engine

BLOQUE 7: ALARMA ACÚSTICA DISUASORIA (BUZZER 95DB)

J2: NANO-SIM PUSH-PULL

RANURA FRESADA 2.0 mm AISLAMIENTO 5000V RMS

BLOQUE 8: DISUASOR ELECTROSTÁTICO DE ALTA TENSIÓN — CERCA VIRTUAL CDI (AISLAMIENTO GALVÁNICO 5KV)

DIAGRAMA DEL CIRCUITO COMPLETO ALL-IN-ONE (8 BLOQUES)

COLLARNET V3 | PLANO 1 DE 4: DIAGRAMA ESQUEMÁTICO ELECTRÓNICO OFICIAL (8 BLOQUES)

# COLLARNET V3 — ARQUITECTURA CUADRADA GANADERA (70.0 × 70.0 mm)

Plano de Cobre GNSS 60×60 mm | Batería Panasonic 18650 Diagonal | Aislamiento HV L-Slot 2.0 mm

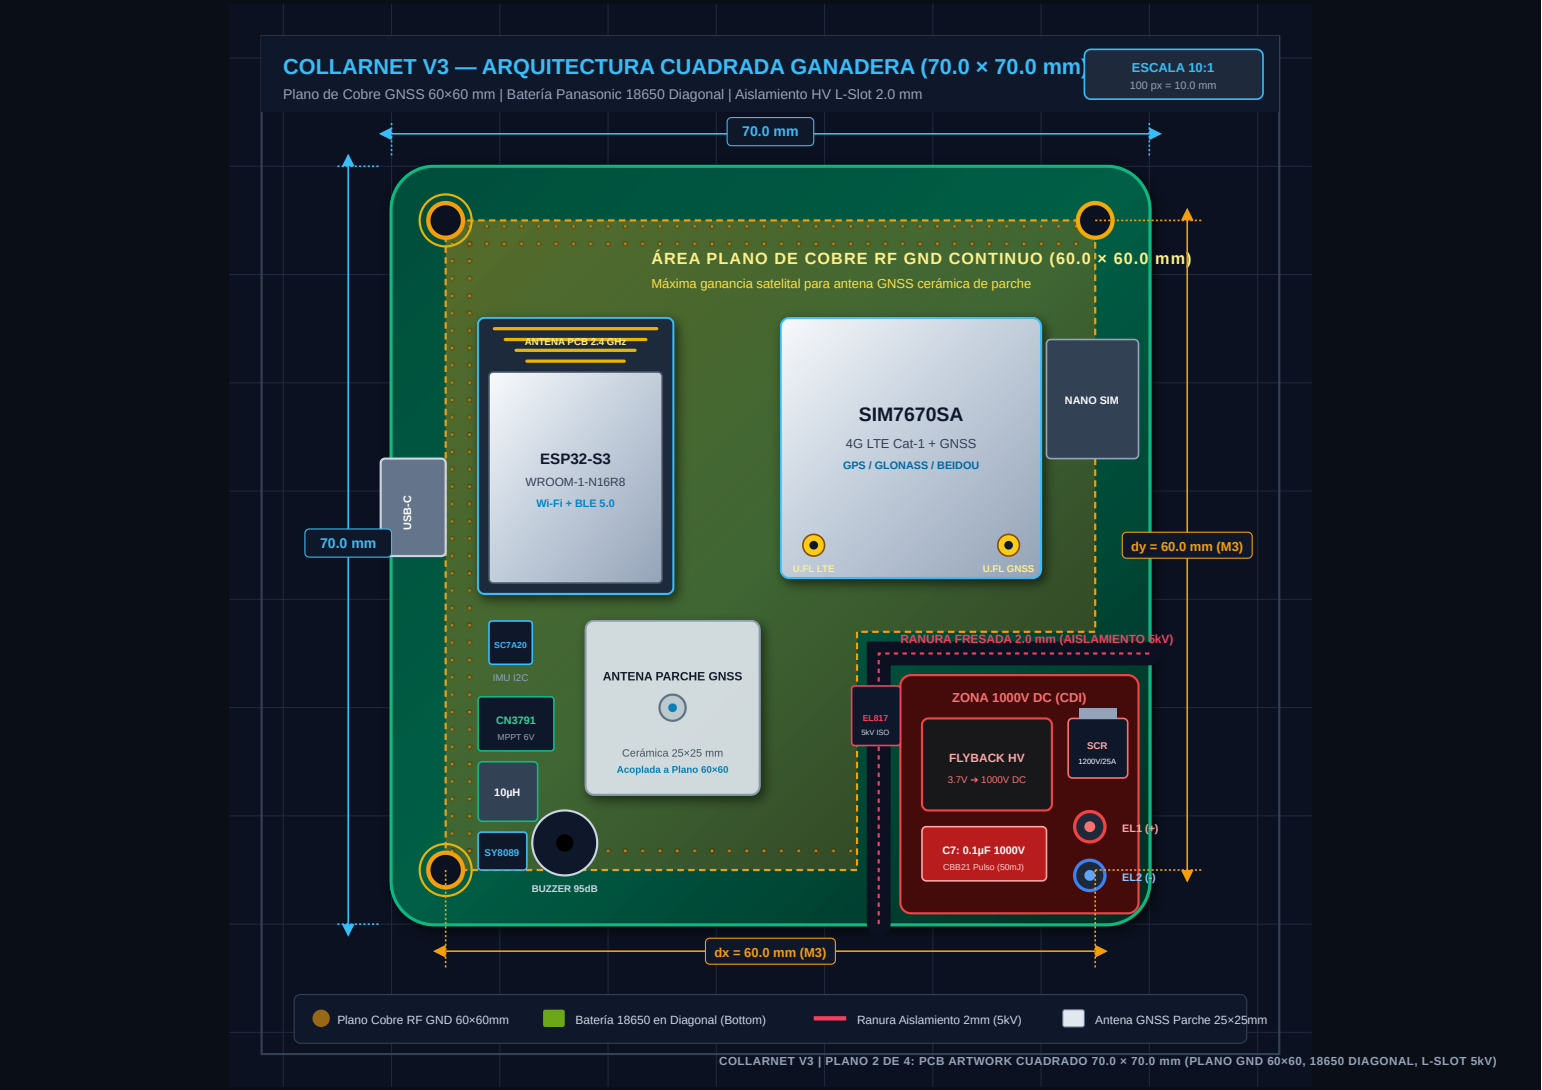
[picture p174: page 2]
ESCALA 10:1; ÁREA PLANO DE COBRE RF GND CONTINUO (60.0; ESP32-S3; WROOM-1-N16R8; Wi-Fi + BLE 5.0; IMU I2C; SIM7670SA; U.FL LTE; U.FL GNSS; NANO SIM; MPPT 6V; 5kV ISO; SCR; Plano Cobre RF GND 60×60mm; Batería 18650 en Diagonal (Bottom); Ranura Aislamiento 2mm (5kV); Antena GNSS Parche 25×25mm; COLLARNET V3 |; PLANO 2 DE 4: PCB ARTWORK CUADRADO 70.0 × 70.0 mm (PLANO GND 60×60, 18650 DIAGONAL, L-SLOT 5kV)

Máxima ganancia satelital para antena GNSS cerámica de parche

ANTENA PCB 2.4 GHz

4G LTE Cat-1 + GNSS

GPS / GLONASS / BEIDOU

RANURA FRESADA 2.0 mm (AISLAMIENTO 5kV)

ZONA 1000V DC (CDI) FLYBACK HV 3.7V ➔ 1000V DC C7: 0.1µF 1000V CBB21 Pulso (50mJ)

BUZZER 95dB

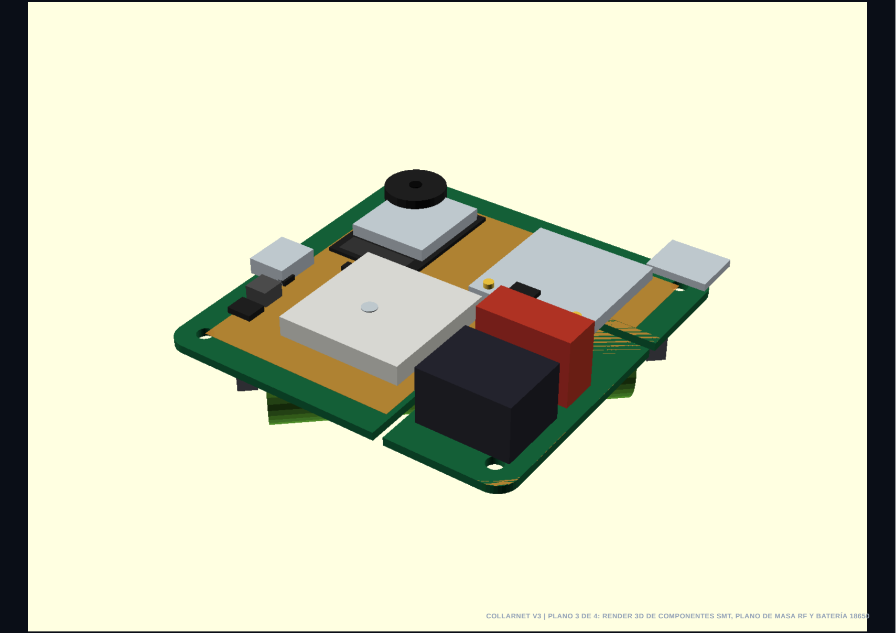
[picture p175: page 3]

COLLARNET V3 | PLANO 3 DE 4: RENDER 3D DE COMPONENTES SMT, PLANO DE MASA RF Y BATERÍA 18650

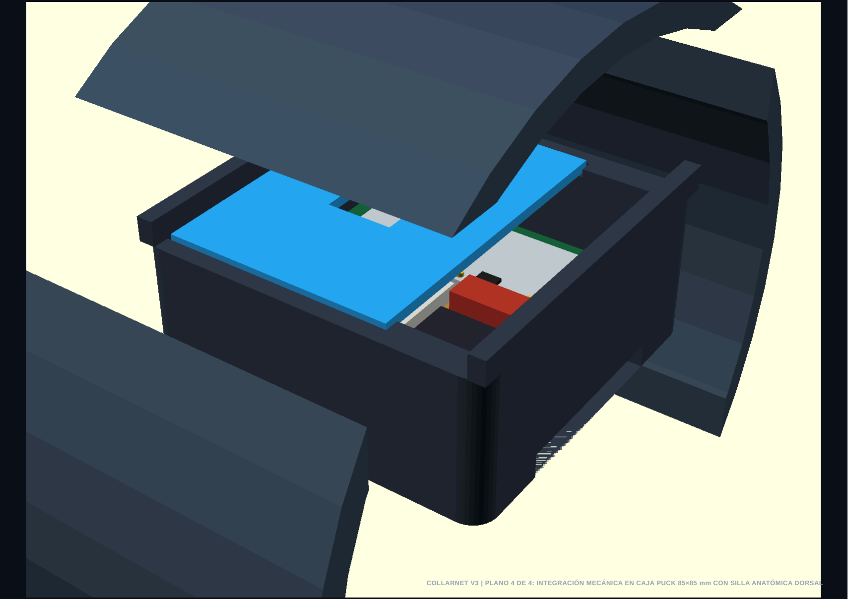
[picture p176: page 4]

COLLARNET V3 | PLANO 4 DE 4: INTEGRACIÓN MECÁNICA EN CAJA PUCK 85×85 mm CON SILLA ANATÓMICA DORSAL
