MorpheusSoft/CollarNet/(list of files, drawings)

Other design files:
docs/diseno_electronico_pcb/easyeda/CollarNet_V2_EasyEDA_PCB.json
