MorpheusSoft/CollarNet/docs/diseno_electronico_pcb/kicad/CollarNet_V3_70x70.kicad_pcb

## KiCad design docs/diseno_electronico_pcb/kicad/CollarNet_V3_70x70.kicad_pcb (2026-11-03)

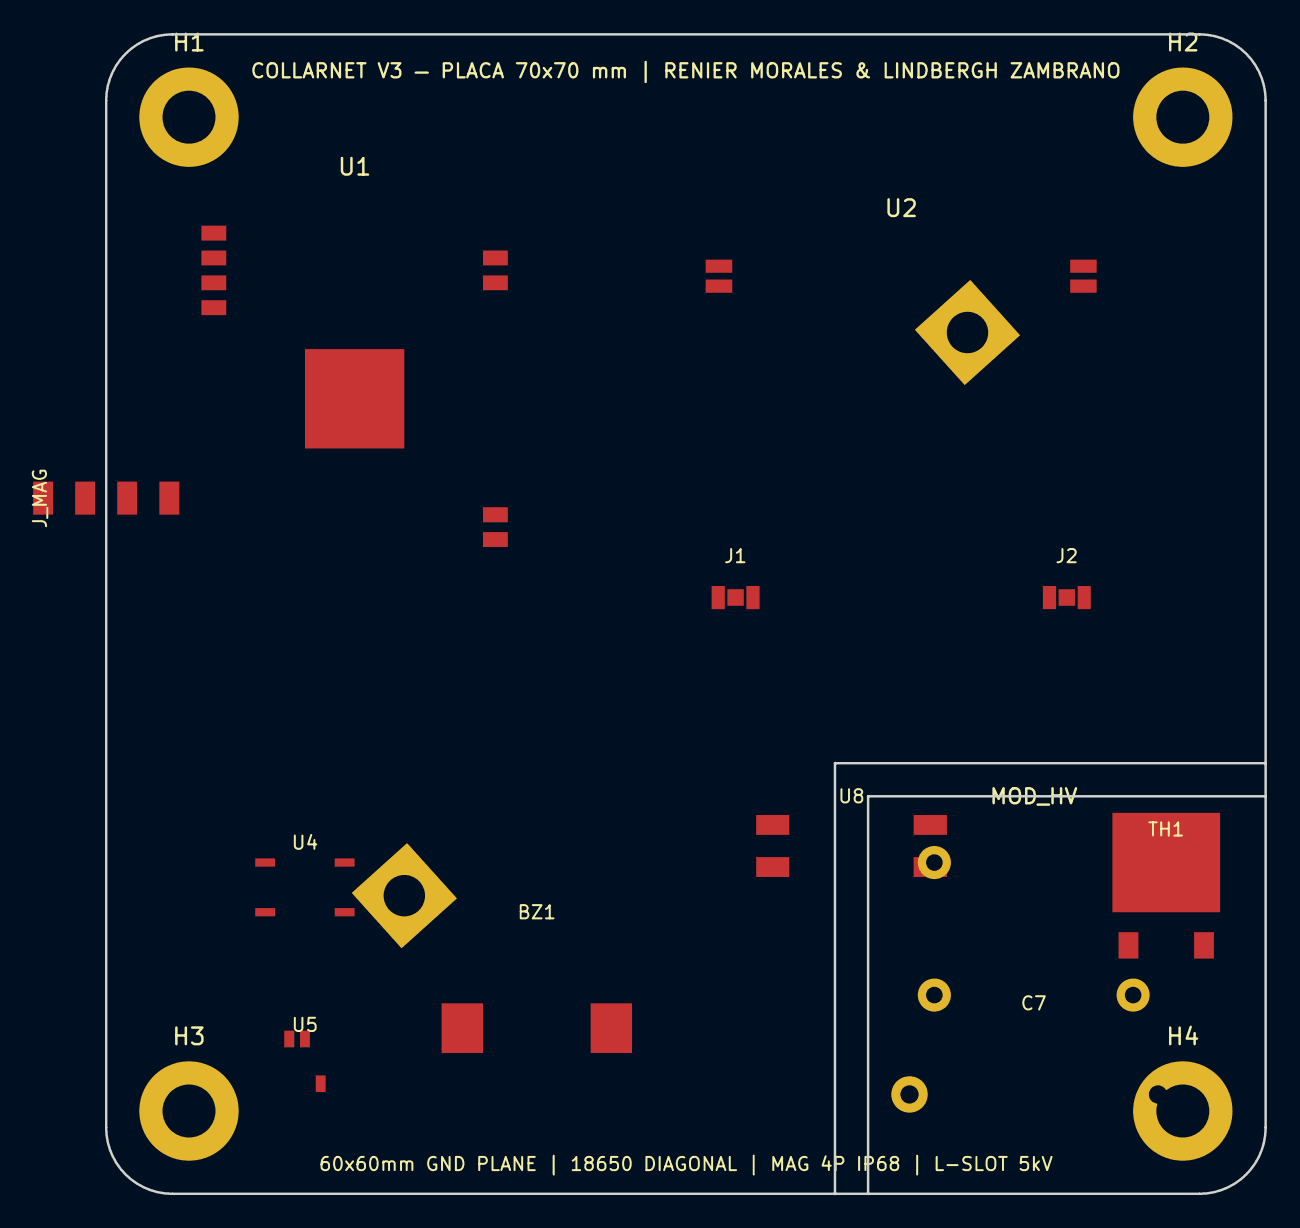
[picture p188: board CollarNet_V3_70x70.kicad_pcb from above]

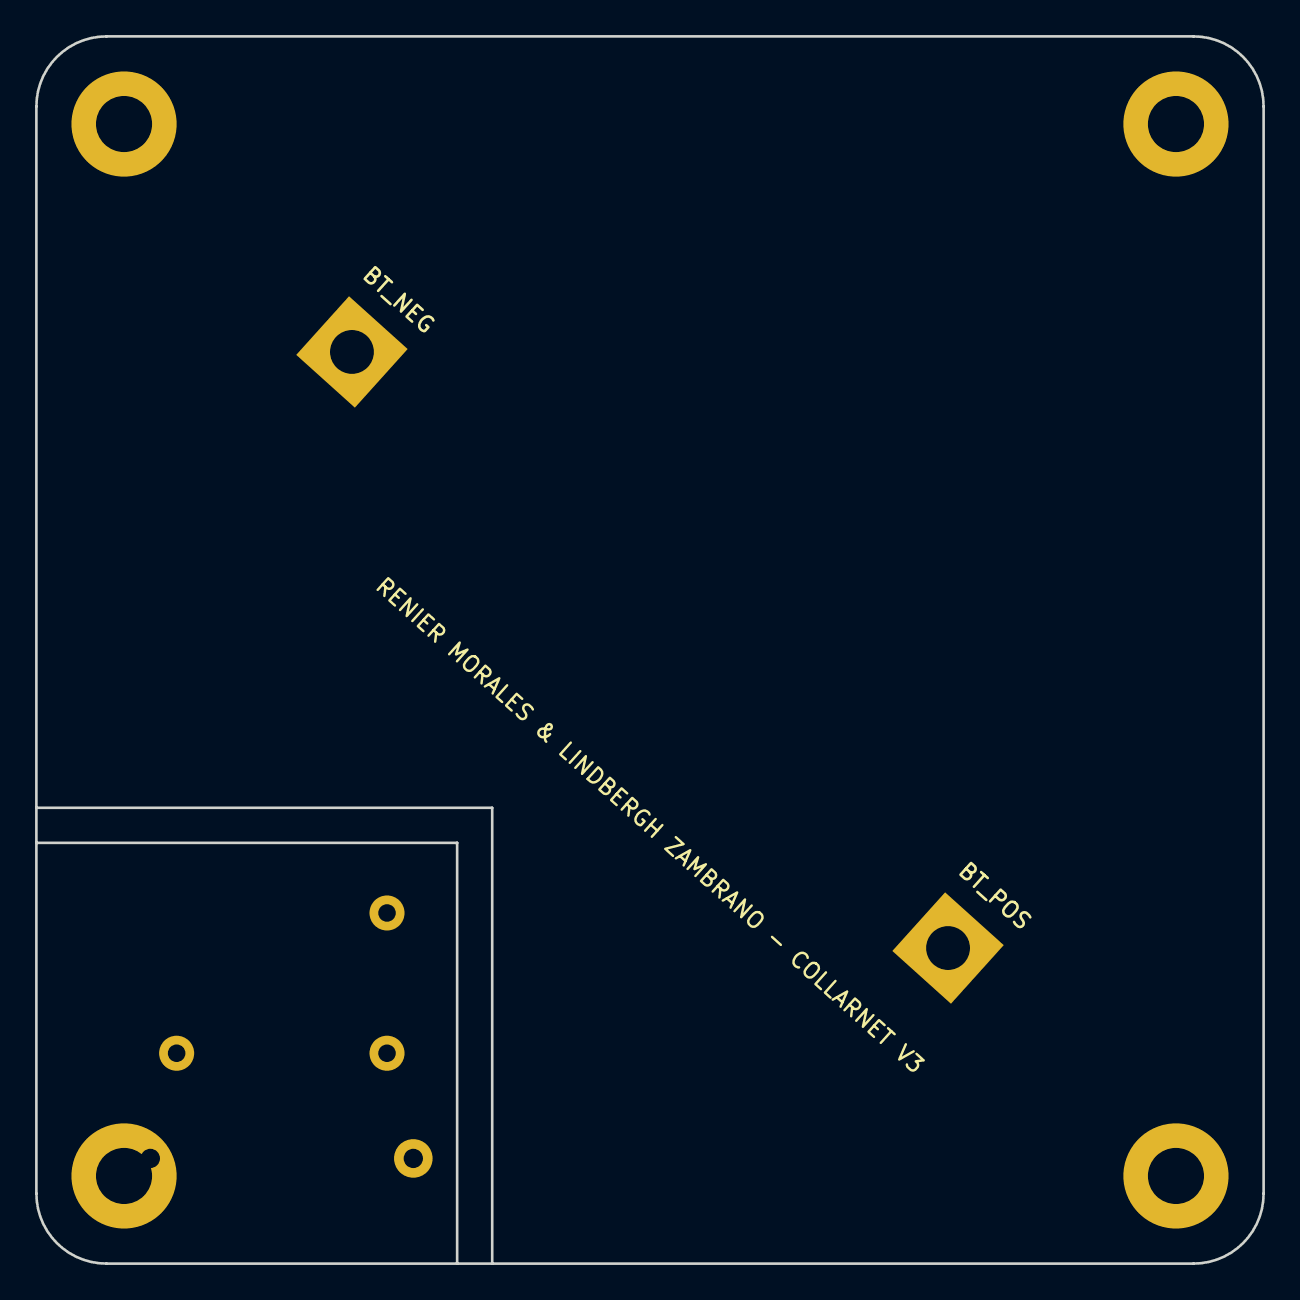
[picture p189: board CollarNet_V3_70x70.kicad_pcb from below]

Board: 2 copper layers, 70.0 x 70.0 mm, 18 parts (2 on the bottom side), 9 nets, no tracks yet.

Parts:
BT_NEG: BatteryHolder_Keystone_1048_1x18650
BT_POS: BatteryHolder_Keystone_1042_1x18650
BZ1: Buzzer_95dB; Buzzer_12x12mm_SMD
C7: 0.1uF 1000V CBB21; C_Rect_L18.0mm_W9.0mm_P15.00mm
H1, H2, H3, H4: MountingHole_3.2mm_M3_Pad
J1: U.FL_LTE; U.FL_Hirose_U.FL-R-SMT-1
J2: U.FL_GNSS; U.FL_Hirose_U.FL-R-SMT-1
J_MAG: MAG_4PIN_IP68; Magnetic_4Pin_Pogo_IP68
MOD_HV: Flyback_1000V; HV_Module_Flyback_1000V
TH1: TYN1225RG; TO-252-2
U1: ESP32-S3-WROOM-1-N16R8; ESP32-S3-WROOM-1
U2: SIM7670SA; SIMCom_SIM7670SA
U4: CN3791; SSOP-10_3.9x4.9mm_P1.00mm
U5: SY8089AAAC; SOT-23-5
U8: EL817C; SMDIP-4_W9.53mm

Connections:
+3.3V: U1.2, U5.1
BUZZER_PWM: BZ1.2, U1.4
GND: BT_NEG.1, H1.1, H2.1, H3.1, H4.1, J1.2, J1.3, J2.2, J2.3, J_MAG.4, U1.1, U1.41, U2.1, U4.4, U5.2, U8.2
HV_GND: C7.2, MOD_HV.2, U8.3
HV_PULSE: C7.1, MOD_HV.3, TH1.2
IMPULSE_TRIG: U1.3, U8.1
MODEM_RXD: J_MAG.2, U1.28, U2.16
MODEM_TXD: J_MAG.3, U1.27, U2.15
VBAT: BT_POS.1, BZ1.1, MOD_HV.1, U2.2, U4.7, U5.4
