MorpheusSoft/CollarNet/alerts.cpp

#include "alerts.h"
#include "config.h"
#include <freertos/FreeRTOS.h>
#include <freertos/task.h>

extern bool collarActivo;
static TaskHandle_t alertTaskHandle = NULL;
volatile bool remoteBuzzerActive = false;

static void alertTaskFunc(void* pvParameters) {
    while (true) {
        extern AlertLevel currentAlert;
        if (!remoteBuzzerActive) {
            if (!collarActivo) {
                currentAlert = ALERT_NONE;
            }
            updateAlerts(currentAlert);
        }
        vTaskDelay(pdMS_TO_TICKS(15)); // Ejecución garantizada a 15ms en Core 0
    }
}

void startAlertTask() {
    if (alertTaskHandle == NULL) {
        xTaskCreatePinnedToCore(
            alertTaskFunc,
            "AlertTask",
            4096,
            NULL,
            2,
            &alertTaskHandle,
            0 // Core 0 independiente de la ejecución de Arduino loop (Core 1)
        );
        Serial.println("[Alerts] Tarea FreeRTOS de alertas iniciada en Core 0 (cadencia garantizada de 15ms).");
    }
}

AlertLevel currentAlert = ALERT_NONE;
unsigned long lastToggleTime = 0;
bool ledState = false;
static bool buzzerActive = false;
static unsigned long alertEpisodeStartTime = 0;
static bool buzzerTimedOut = false;
const unsigned long BUZZER_TIMEOUT_MS = 60000; // 60 segundos máximos de alerta acústica por evento

// Control de pulso único de descarga electrostática (1 segundo)
static bool dischargeTriggered = false;
static unsigned long dischargeStartTime = 0;
const unsigned long DISCHARGE_DURATION_MS = 1000; // 1 segundo exacto de estímulo disuasorio

const int BUZZER_CHANNEL = 0;

void playBuzzerTone(unsigned int freq, uint8_t dutyCycle = 128) {
    if (freq > 0) {
        ledcAttachPin(BUZZER_PIN, BUZZER_CHANNEL);
        ledcWriteTone(BUZZER_CHANNEL, freq);
        ledcWrite(BUZZER_CHANNEL, dutyCycle); // Modulación de volumen / intensidad acústica PWM
    } else {
        ledcWrite(BUZZER_CHANNEL, 0);
        ledcWriteTone(BUZZER_CHANNEL, 0);
        pinMode(BUZZER_PIN, OUTPUT);
        digitalWrite(BUZZER_PIN, LOW);   // Silencio total forzado a 0V
    }
}

void resetAlertBudget() {
    alertEpisodeStartTime = 0;
    buzzerTimedOut = false;
    buzzerActive = false;
    lastToggleTime = 0;
    ledState = false;
    playBuzzerTone(0, 0);
    dischargeTriggered = false; // Rearmar la descarga para el próximo escape
    dischargeStartTime = 0;
    if (STATUS_LED_PIN >= 0) digitalWrite(STATUS_LED_PIN, LOW);
    if (IMPULSE_PIN >= 0) digitalWrite(IMPULSE_PIN, LOW);
}

bool isAlertTimedOut() {
    return buzzerTimedOut;
}

void initAlerts() {
    if (STATUS_LED_PIN >= 0) {
        pinMode(STATUS_LED_PIN, OUTPUT);
        digitalWrite(STATUS_LED_PIN, LOW);
    }
    
    // Configurar pin del Buzzer en IO5 con máxima fuerza de corriente (40 mA)
    pinMode(BUZZER_PIN, OUTPUT);
    gpio_set_drive_capability((gpio_num_t)BUZZER_PIN, GPIO_DRIVE_CAP_3);

    // Inicializar canal de control LEDC PWM nativo de ESP32 a 4000 Hz
    ledcSetup(BUZZER_CHANNEL, 4000, 8);
    ledcAttachPin(BUZZER_PIN, BUZZER_CHANNEL);
    ledcWrite(BUZZER_CHANNEL, 0);

    if (IMPULSE_PIN >= 0) {
        pinMode(IMPULSE_PIN, OUTPUT);
        digitalWrite(IMPULSE_PIN, LOW);
    }

    Serial.println("[Alerts] Sistema de alertas inicializado (Buzzer IO5 a 4000 Hz | Impulso IO23).");
    Serial.println("[Alerts] Ejecutando pitido de confirmación en IO5 a 4000 Hz...");

    // Doble pitido de confirmación al arrancar
    playBuzzerTone(4000, 128);
    delay(200);
    playBuzzerTone(0, 0);
    delay(100);
    playBuzzerTone(4000, 128);
    delay(200);
    playBuzzerTone(0, 0);

    Serial.println("[Alerts] ¡Buzzer en IO5 e Impulso en IO23 listos!");
    startAlertTask();
}

static double lastDistToBorder = 0.0;
static double lastWarningMargin = 10.0;
static bool lastIsHatoAlert = false;

void updateAlerts(AlertLevel level, double distToBorder, double warningMargin, int isHatoAlert) {
    unsigned long currentMillis = millis();

    // Solo actualizar variables de contexto si provienen de una evaluación explícita (valores >= 0)
    if (distToBorder >= 0.0) {
        lastDistToBorder = distToBorder;
    }
    if (warningMargin > 0.0) {
        lastWarningMargin = warningMargin;
    }
    if (isHatoAlert >= 0) {
        lastIsHatoAlert = (isHatoAlert == 1);
    }

    // 1. Detección de Transición de Nivel
    if (level != currentAlert) {
        // Si estábamos en Zona Segura (ALERT_NONE) e ingresamos a cualquier alerta (WARNING, DANGER, CRITICAL):
        if (currentAlert == ALERT_NONE && level != ALERT_NONE) {
            alertEpisodeStartTime = currentMillis;
            buzzerTimedOut = false;
            lastToggleTime = currentMillis;
            ledState = true;
            Serial.printf("[Alerts] 🔔 Nuevo evento de alerta iniciado (Nivel %d). Presupuesto acustico: 60s.\n", (int)level);
        }
        currentAlert = level;
    }

    // 2. Si el nivel actual es ALERT_NONE (Zona Segura o retorno al potrero):
    // Silenciado instantáneo y rearme completo para el siguiente escape
    if (currentAlert == ALERT_NONE) {
        resetAlertBudget();
        return;
    }

    // 3. Control de Timeout de 60 Segundos:
    // Aplica a TODO el ciclo (margen de advertencia, escape de potrero o escape de hato)
    if (alertEpisodeStartTime > 0 && (currentMillis - alertEpisodeStartTime >= BUZZER_TIMEOUT_MS)) {
        if (!buzzerTimedOut) {
            buzzerTimedOut = true;
            playBuzzerTone(0, 0);
            buzzerActive = false;
            Serial.println("[Alerts] ⏱️ Timeout de 60s alcanzado. Zumbador silenciado por proteccion animal.");
        }
    }

    double effDist = lastDistToBorder;
    double effMargin = (lastWarningMargin > 0.0) ? lastWarningMargin : 3.0;
    bool effIsHato = lastIsHatoAlert;

    // 1. MODO CRÍTICO HATO: ESCAPE MAYOR DE LA FINCA (Tono continuo 4000Hz a máxima potencia + Descarga ÚNICA de 1 segundo)
    if (currentAlert == ALERT_CRITICAL_HATO) {
        if (STATUS_LED_PIN >= 0) digitalWrite(STATUS_LED_PIN, HIGH);
        
        // Disparar la descarga única de 1 segundo por primera y única vez al cruzar el Hato
        if (!dischargeTriggered) {
            dischargeTriggered = true;
            dischargeStartTime = currentMillis;
            if (IMPULSE_PIN >= 0) {
                digitalWrite(IMPULSE_PIN, HIGH);
            }
            Serial.println("[Alerts] ⚡ ¡DISPARO DE DESCARGA ÚNICA (1s) POR ESCAPE DE HATO!");
        } else {
            // Si ya transcurrió 1 segundo (1000ms), apagar el pin de descarga inmediatamente
            if (currentMillis - dischargeStartTime >= DISCHARGE_DURATION_MS) {
                if (IMPULSE_PIN >= 0) {
                    digitalWrite(IMPULSE_PIN, LOW);
                }
            } else {
                // Aún dentro del segundo de descarga
                if (IMPULSE_PIN >= 0) {
                    digitalWrite(IMPULSE_PIN, HIGH);
                }
            }
        }

        // Tono continuo simultáneo a máxima potencia con timeout de seguridad de 60s
        if (!buzzerTimedOut) {
            playBuzzerTone(4000, 128); // 4000 Hz continuo a volumen máximo (128 duty cycle)
            buzzerActive = true;
        } else {
            playBuzzerTone(0, 0);
            buzzerActive = false;
        }
        return;
    }

    // Si no está en ALERT_CRITICAL_HATO, asegurar que el pin de descarga esté apagado
    if (IMPULSE_PIN >= 0) {
        digitalWrite(IMPULSE_PIN, LOW);
    }
    // Rearmar la descarga si regresa al interior del Hato (a Warning o Danger)
    if (currentAlert != ALERT_CRITICAL_HATO) {
        dischargeTriggered = false;
    }

    // 2. ADVERTENCIA PREVENTIVA DE HATO (Cruzando margen de cercanía exterior):
    // Pitido fijo continuo con modulación de volumen según proximidad
    if (currentAlert == ALERT_WARNING && effIsHato) {
        if (STATUS_LED_PIN >= 0) digitalWrite(STATUS_LED_PIN, HIGH);
        
        double clampedDist = (effDist < 0.0) ? 0.0 : ((effDist > effMargin) ? effMargin : effDist);
        double ratio = clampedDist / effMargin; // 1.0 (en el borde exterior) a 0.0 (en la cerca)
        // Modulación de volumen: de ~25 (suave al borde) a 128 (máxima fuerza acústica en la cerca)
        uint8_t toneDutyCycle = 128 - (uint8_t)(ratio * 103.0);

        if (!buzzerTimedOut) {
            playBuzzerTone(4000, toneDutyCycle); // Pitido fijo continuo a volumen proporcional
            buzzerActive = true;
        } else {
            playBuzzerTone(0, 0);
            buzzerActive = false;
        }
        return;
    }

    // 3. ADVERTENCIA PREVENTIVA O ESCAPE DE POTRERO:
    // Cadencia intermitente nítida con pulso activo de 120ms y silencios bien audibles
    unsigned long onDuration = 120;  // 120ms de pitido nítido
    unsigned long offDuration = 400; // pausa de silencio
    unsigned int toneFrequency = 4000;
    uint8_t toneDutyCycle = 128;

    if (currentAlert == ALERT_WARNING) {
        // En zona de advertencia del potrero: pitido intermitente progresivo por cadencia
        double clampedDist = (effDist < 0.0) ? 0.0 : ((effDist > effMargin) ? effMargin : effDist);
        double ratio = clampedDist / effMargin; // 1.0 (en el margen exterior) a 0.0 (en la cerca)
        // Pausa entre pitidos: de 1100ms (lento al borde del margen) a 220ms (rápido en la cerca)
        offDuration = 220 + (unsigned long)(ratio * 880.0);
    } else if (currentAlert == ALERT_DANGER) {
        // Fuera del potrero: intermitencia rápida claramente distinguible (120ms BEEP / 200ms SILENCIO)
        offDuration = 200;
    } else {
        if (STATUS_LED_PIN >= 0) digitalWrite(STATUS_LED_PIN, LOW);
        playBuzzerTone(0, 0);
        buzzerActive = false;
        return;
    }

    // Máquina de estados asimétrica (pulso ON corto y pausa OFF audible)
    unsigned long stateDuration = ledState ? onDuration : offDuration;
    if (currentMillis - lastToggleTime >= stateDuration) {
        lastToggleTime = currentMillis;
        ledState = !ledState;
        if (STATUS_LED_PIN >= 0) digitalWrite(STATUS_LED_PIN, ledState ? HIGH : LOW);
        
        if (ledState && !buzzerTimedOut) {
            playBuzzerTone(toneFrequency, toneDutyCycle);
            buzzerActive = true;
        } else {
            if (buzzerActive) {
                playBuzzerTone(0, 0);
                buzzerActive = false;
            }
        }
    }
}

void triggerRemoteBuzzerBeep(int durationMs, int freq) {
    if (freq <= 0) freq = 4000;
    remoteBuzzerActive = true;
    Serial.printf("[Alerts] >> Disparando zumbador acustico remoto (%d Hz, %d ms)...\n", freq, durationMs);
    playBuzzerTone(freq, 128);
    delay(220);
    playBuzzerTone(0, 0);
    delay(100);
    playBuzzerTone(freq, 128);
    delay(220);
    playBuzzerTone(0, 0);
    remoteBuzzerActive = false;
}
