MorpheusSoft/CollarNet/mqtt_manager.cpp

#include <WiFi.h>
#include <PubSubClient.h>
#include <ArduinoJson.h>
#include "mqtt_manager.h"
#include "storage_manager.h"
#include "geofence.h"
#include "alerts.h"
#include "config.h"

PubSubClient client;
Client* currentNetClient = nullptr;

String staticCollarId = "";
String configTopic = "";
String cmdTopic = "";
String telemetryTopic = "";
unsigned long lastMqttReconnect = 0;

// Declaraciones externas para actuar ante comandos remotos
extern void onNetworkPreferenceChanged(NetPreference newPref);
extern void onGpsPowerChanged(bool powerOn);
extern void onCameraStreamingControl(bool enabled, int fps, const String& quality);
extern void onCameraSnapshotRequested();

// Callback de recepción de mensajes MQTT
void mqttCallback(char* topic, byte* payload, unsigned int length) {
    Serial.printf("\n[MQTT] Mensaje recibido en: %s\n", topic);
    
    String payloadStr = "";
    for (unsigned int i = 0; i < length; i++) {
        payloadStr += (char)payload[i];
    }
    Serial.println("[MQTT] Contenido: " + payloadStr);

    StaticJsonDocument<1536> doc;
    DeserializationError err = deserializeJson(doc, payloadStr);
    if (!err) {
        if (doc.containsKey("collar_activo")) {
            collarActivo = doc["collar_activo"].as<bool>();
            saveCollarActiveState(collarActivo);
            Serial.printf("[MQTT] Estado operativo actualizado: %s\n", collarActivo ? "ACTIVO" : "DESACTIVADO (SILENCIO TOTAL)");
            if (!collarActivo) {
                updateAlerts(ALERT_NONE);
            }
        } else if (doc.containsKey("activo")) {
            collarActivo = doc["activo"].as<bool>();
            saveCollarActiveState(collarActivo);
            Serial.printf("[MQTT] Estado operativo actualizado: %s\n", collarActivo ? "ACTIVO" : "DESACTIVADO (SILENCIO TOTAL)");
            if (!collarActivo) {
                updateAlerts(ALERT_NONE);
            }
        } else if (doc.containsKey("silence")) {
            collarActivo = !doc["silence"].as<bool>();
            saveCollarActiveState(collarActivo);
            Serial.printf("[MQTT] Estado de silencio: %s\n", collarActivo ? "ACTIVO" : "SILENCIO FORZADO (ALMACÉN)");
            if (!collarActivo) {
                updateAlerts(ALERT_NONE);
            }
        }

        if (doc.containsKey("p_open")) {
            potreroAbierto = (doc["p_open"].as<int>() == 1);
            Serial.printf("[MQTT] ¡Estado de Potrero actualizado vía MQTT!: %s\n", 
                          potreroAbierto ? "ABIERTO (Modo Traslado)" : "CERRADO (Cerca Activa)");
        }
        if (doc.containsKey("net_pref")) {
            String np = doc["net_pref"].as<String>();
            np.toUpperCase();
            NetPreference pref = NET_PREF_AUTO;
            if (np == "CELULAR" || np == "1") pref = NET_PREF_CELLULAR;
            else if (np == "WIFI" || np == "2") pref = NET_PREF_WIFI;
            else pref = NET_PREF_AUTO;
            Serial.printf("[MQTT] Recibido cambio de preferencia de red: %s\n", np.c_str());
            saveNetPreference(pref);
            onNetworkPreferenceChanged(pref);
        }
        if (doc.containsKey("gps_pwr")) {
            bool pwr = doc["gps_pwr"].as<bool>();
            Serial.printf("[MQTT] Recibido control de encendido de GPS: %s\n", pwr ? "ENCENDER" : "APAGAR");
            onGpsPowerChanged(pwr);
        }
        bool isCamPower = false;
        bool camPwr = false;
        if (doc.containsKey("cmd")) {
            String c = doc["cmd"].as<String>();
            if (c == "camera_power" || c == "camera_stream" || c == "camera") {
                isCamPower = true;
                camPwr = doc.containsKey("active") ? doc["active"].as<bool>() : true;
            }
        }
        if (doc.containsKey("camera_power")) {
            isCamPower = true;
            camPwr = doc["camera_power"].as<bool>();
        } else if (doc.containsKey("camera_stream")) {
            isCamPower = true;
            camPwr = doc["camera_stream"].as<bool>();
        }

        if (isCamPower) {
            int fps = doc.containsKey("fps") ? doc["fps"].as<int>() : 3;
            String quality = doc.containsKey("quality") ? doc["quality"].as<String>() : "qvga";
            Serial.printf("[MQTT] Recibido control de cámara en vivo: %s (FPS: %d, Calidad: %s)\n", 
                          camPwr ? "ACTIVAR (REVERSE STREAM)" : "DESACTIVAR", fps, quality.c_str());
            onCameraStreamingControl(camPwr, fps, quality);
            return;
        }

        if ((doc.containsKey("cmd") && doc["cmd"] == "snapshot") || (doc.containsKey("snapshot") && doc["snapshot"].as<bool>())) {
            Serial.println("[MQTT] Recibida solicitud de captura snapshot en alta resolución.");
            onCameraSnapshotRequested();
            return;
        }

        if ((doc.containsKey("cmd") && doc["cmd"] == "buzzer") || doc.containsKey("buzzer") || doc.containsKey("beep")) {
            int duration = doc.containsKey("duration") ? doc["duration"].as<int>() : 800;
            int freq = doc.containsKey("freq") ? doc["freq"].as<int>() : 4000;
            Serial.printf("[MQTT] ¡Comando de Pitido Acústico (Buzzer) recibido! Duración: %d ms, Frec: %d Hz\n", duration, freq);
            triggerRemoteBuzzerBeep(duration, freq);
            return;
        }
    }
    
    // Guardar los nuevos perímetros en LittleFS y recargar memoria si tiene datos de geocerca
    if (saveGeofenceConfig(payloadStr)) {
        Serial.println("[MQTT] Configuración cargada y guardada en LittleFS correctamente.");
    }
}

// Conexión no bloqueante al Broker
bool reconnectMQTT() {
    if (!currentNetClient) return false;
    
    Serial.println("[MQTT] Intentando conectar al broker HiveMQ...");
    String clientId = "CollarNetClient-" + staticCollarId + "-" + String(random(1000, 9999));
    
    if (client.connect(clientId.c_str())) {
        Serial.println("[MQTT] ¡Conectado con éxito al broker!");
        client.subscribe(configTopic.c_str());
        client.subscribe(cmdTopic.c_str());
        Serial.printf("[MQTT] Suscrito a %s y %s\n", configTopic.c_str(), cmdTopic.c_str());
        return true;
    } else {
        Serial.printf("[MQTT] Fallo de conexión, rc=%d. Se reintentará en 10s.\n", client.state());
        return false;
    }
}

void setMQTTNetworkClient(Client* netClient) {
    currentNetClient = netClient;
    if (currentNetClient) {
        client.setClient(*currentNetClient);
    }
}

void initMQTT(const char* collarId, Client* netClient) {
    staticCollarId = String(collarId);
    configTopic = String(MQTT_TOPIC_PREFIX) + "/" + staticCollarId + "/config";
    cmdTopic = String(MQTT_TOPIC_PREFIX) + "/" + staticCollarId + "/cmd";
    telemetryTopic = String(MQTT_TOPIC_PREFIX) + "/" + staticCollarId + "/telemetria";

    setMQTTNetworkClient(netClient);
    client.setServer(MQTT_SERVER, MQTT_PORT);
    client.setCallback(mqttCallback);
    client.setSocketTimeout(6); // 6 segundos para garantizar handshakes estables en 4G LTE Digitel
    client.setKeepAlive(15);
    // 32 KB de búfer MQTT para soportar tramas JPEG binarias de cámara
    client.setBufferSize(32768);
    
    reconnectMQTT();
}

void handleMQTT() {
    if (!client.connected()) {
        unsigned long now = millis();
        if (now - lastMqttReconnect >= 10000) {
            lastMqttReconnect = now;
            if (reconnectMQTT()) {
                lastMqttReconnect = 0;
            }
        }
    } else {
        client.loop();
    }
}

bool publishTelemetry(double lat, double lon, int bateria, int senal, const String& alertType, const String& imei, int vbat, bool isCharging, const String& netType, bool gpsPwr, bool gpsFix, int sats) {
    if (!client.connected()) {
        Serial.println("[MQTT] Envío omitido: Cliente MQTT desconectado.");
        return false;
    }

    StaticJsonDocument<512> doc;
    doc["lat"] = lat;
    doc["lon"] = lon;
    doc["bat"] = bateria;
    doc["sig"] = senal;
    doc["alert"] = alertType;
    if (imei.length() > 0) {
        doc["imei"] = imei;
    }
    if (vbat > 0) {
        doc["vbat"] = vbat;
    }
    doc["charging"] = isCharging;
    doc["net"] = netType;
    if (WiFi.status() == WL_CONNECTED) {
        doc["ip"] = WiFi.localIP().toString();
    }
    doc["gps_pwr"] = gpsPwr;
    doc["gps_fix"] = gpsFix;
    doc["sats"] = sats;

    String jsonString;
    serializeJson(doc, jsonString);

    Serial.printf("[MQTT] Publicando telemetría en %s...\n", telemetryTopic.c_str());
    Serial.println("[MQTT] Payload: " + jsonString);

    return client.publish(telemetryTopic.c_str(), jsonString.c_str());
}

bool publishCameraFrame(const uint8_t* buf, size_t len) {
    if (!client.connected()) {
        Serial.println("[MQTT Cam] ❌ Cliente MQTT desconectado.");
        return false;
    }
    if (buf == nullptr || len == 0) {
        Serial.println("[MQTT Cam] ❌ Buffer de imagen vacío.");
        return false;
    }
    String camTopic = String(MQTT_TOPIC_PREFIX) + "/" + staticCollarId + "/camera";

    // Modems celulares SIM7670 transmiten datos TCP mediante AT+CIPSEND (máximo 1460 bytes por comando).
    // Usar beginPublish + chunks de 1024 bytes garantiza que paquetes grandes (como fotogramas JPEG)
    // se envíen de forma limpia y confiable a través del módem celular hacia HiveMQ sin desbordar el búfer AT.
    if (client.beginPublish(camTopic.c_str(), len, false)) {
        size_t written = 0;
        const size_t chunkSize = 1024;
        while (written < len) {
            size_t toWrite = (len - written > chunkSize) ? chunkSize : (len - written);
            size_t sent = client.write(buf + written, toWrite);
            if (sent == 0) {
                Serial.printf("[MQTT Cam] ❌ client.write falló en byte %u de %u\n", (unsigned int)written, (unsigned int)len);
                return false;
            }
            written += sent;
        }
        return (client.endPublish() == 1);
    } else {
        Serial.println("[MQTT Cam] ❌ client.beginPublish retornó false.");
    }
    return false;
}

bool isMQTTConnected() {
    return client.connected();
}
