MorpheusSoft/CollarNet/secrets.h

#ifndef SECRETS_H
#define SECRETS_H

// Modifica estas constantes con las credenciales de tu red local
#define WIFI_SSID "SOITCA"
#define WIFI_PASS "Trainer12"
#define COLLAR_ID "COW-002"

#endif // SECRETS_H
