MorpheusSoft/CollarNet/(commit log)

2026-09-02 feat: implement complete software roadmap (sanidad, reproduccion, notificaciones, reportes PDF/Excel, salud/rumia IMU y genealogia)
2026-09-17 feat: integracion completa apps moviles (tecnico y finca/supervisor), login centralizado, navegador jerarquico de hatos/adquirientes y soporte PWA iPhone
2026-09-18 feat: boton de descarga app tecnica para superadmin en web y app-campo, soporte pwa iphone, correccion buzzer pwm y dockerfile
    [CollarNet.ino, alerts.cpp, alerts.h, config.h, geofence.cpp, geofence.h]
2026-09-18 feat: integracion de descarga APK segun rol en sidebar con modal QR y limpieza de header
2026-09-18 feat(movil_ops): pantalla de login con credenciales VPS, timeout de 20 min por inactividad y sincronizacion en vivo con cowai.net
2026-09-18 feat: trazado libre de vertices y seleccion interactiva de snapping de geocercas
2026-09-19 feat(gis): rediseno de geocercas sobre satelite, auto-centrado en hato y proteccion de collares activos
2026-09-19 fix(api): relacion de collares activos con hatos a traves de potreros
2026-09-19 feat: proteccion contra eliminacion de hatos y potreros con animales activos
2026-09-19 fix: actualizar configuracion de IP 192.168.86.21 para backend y apps moviles APK
2026-09-19 fix(backend): compatibilidad de campo identifier en /auth/login
2026-09-19 fix(propietarios): permitir registro flexible con Cedula de Identidad (C.I.) y RIF
2026-09-19 fix(merge): resolver conflicto en api.js, actualizar version de CowIA Tecnico a 1.0.3 y refinar registro de ganado
2026-09-19 feat(finca): eliminacion de temporizador en modo arreo y traslado manual continuo
2026-09-19 fix(web): solucionar pantalla negra en ganado por import useEffect y poblar inventario fallback de collares
2026-09-19 feat(hardware): identificacion por IMEI y monitoreo de bateria y carga USB en tiempo real
2026-09-19 fix: corregir persistencia real en base de datos de animales sin collar y resolver tenant/hato
2026-09-19 feat: agregar accion y endpoint para desvincular collar IoT de una res
2026-09-19 fix: no inventar peso de 350kg si el animal no ha sido pesado, mostrar 'Sin pesar'
2026-09-21 feat(mobile): habilitar ingreso manual y dinamico de arete y collar en modulo de manga
2026-09-21 feat: soporte SIM7670G 4G LTE y diagnostico en vivo de bateria y GPS en web
2026-09-22 fix: unificar COLLAR_ID COW-001, modo AUTO y fijacion satelital con 12 satelites
    [CollarNet.ino, config.h, secrets.h]
2026-09-22 feat(campo): flujo rapido en manga 2 toques con patio de manejo predeterminado
2026-09-22 feat: descarga directa de APK con QR en web y auto-actualizacion OTA en CowIA Campo
2026-09-22 fix(web): asegurar estilos y scripts para app-campo.html, incluir banner QR y descarga APK
2026-09-22 fix(ui): limpiar pantalla de descarga de APK, evitar fantasma de collares en inventario y corregir estado sin potrero
2026-09-23 fix(api): robustecer vincular-rapido para PostgreSQL y consultar animales por hato_id
2026-09-23 fix(api): vincular-rapido resuelve potrero, hato y tenant directamente de PostgreSQL
2026-09-23 feat(gis): optimizar visualización de geocercas, collares en vivo y sincronización MQTT automática
2026-09-24 feat(firmware): implementar pitido progresivo proporcional a distancia en potreros y hatos con timeout de 60s
2026-09-28 feat(camera): implementar streaming de video en vivo de collares, visor web HUD y sincronizacion con cowai.net
2026-09-29 feat: habilitar receptor TCP multi-protocolo en puerto 7700 para collares GPS F10/GT06
2026-09-29 feat: soportar UDP 7700 y logging detallado RAW para receptor de collares
2026-09-29 feat: implementar decodificador completo protocolo 3G/Wonlex para collar F10 Starry GPS
2026-09-29 fix: ajustar indices de telemetria UD y actualizar bateria/senales incluso sin fix GPS
2026-09-29 fix: manejar coordenadas nulas o sin fix GPS manteniendo la ubicacion previa del collar
2026-09-29 feat: agregar endpoint PATCH /api/collares/:id para modificar numero SIM y notas
2026-09-29 feat: enlazar alertas de geocerca con comando FIND/sonar para collares 3G
2026-10-01 feat(wifi-camera): optimizar streaming de video local, soporte de IP dinamica y control de buzzer/camara en firmware y backend
    [CollarNet.ino, alerts.cpp, alerts.h, camera_stream_server.cpp, config.h, main.cpp]
2026-10-02 fix(ui): optimizar visor de camara en vivo para tablets y pantallas compactas, botones visibles de cerrar y salida rapida
    [CollarNet.ino, config.h, gps_emulator.cpp]
2026-10-02 fix(responsive): soporte completo para telefonos y tablets con menu drawer y visor adaptativo
2026-10-02 fix(camera): resolver desaparicion de ventana en modo flotante (PiP) y pantalla completa usando React Portal y z-index limpio
2026-10-02 feat(ui): barra de arrastre tactil dedicada para camara flotante y distribucion vertical con scroll en telefonos
2026-10-02 feat(ui): redimensionamiento de camara flotante y divisores ajustables horizontal/vertical en todas las vistas
2026-10-05 feat(geocercas): margen sonoro de potrero ajustable y alarma progresiva continua/intermitente con timeout 60s
2026-10-05 fix(firmware): corregir jerarquia de geocercas para potrero y acelerar muestreo GNSS a 1.5s
    [CollarNet.ino]
2026-10-05 feat(movil_ops): agregar configuracion de margen de advertencia en potreros y compilar APK; fix(firmware): corregir cadencia intermitente y retencion isHatoAlert
    [alerts.cpp]
2026-10-05 fix(firmware): solucionar cadencia acustica con pulsos definidos de 120ms y pausas audibles progresivas; corregir retencion de variables de distancia en loop
    [CollarNet.ino, alerts.cpp, alerts.h]
2026-10-05 fix(firmware): decouple buzzer to Core 0 FreeRTOS task, non-blocking 1Hz GNSS query, anti-jump EMA filter and immediate acoustic response
    [CollarNet.ino, alerts.cpp, alerts.h, mqtt_manager.cpp]
2026-10-05 fix(firmware): optimize MQTT cellular socket timeout to 6s and publish telemetry every 3s
    [CollarNet.ino, mqtt_manager.cpp]
2026-10-05 fix(firmware): make ALERT_WARNING immune to timeout, rearm danger timeout on motion, disable premature power save
    [CollarNet.ino, alerts.cpp, imu_manager.cpp]
2026-10-08 feat(web): implementar alarma sonora acustica y control de silenciado para monitoreo en cowai.net
2026-10-09 feat(collar): configurar soporte para segundo dispositivo COW-002 y auto-deteccion de puerto
2026-10-09 fix(backend): proteccion contra coordenadas nulas en log IoT y registro de COW-002
2026-10-09 chore(config): ajustar preferencia por defecto a Wi-Fi SOITCA para COW-002
2026-10-09 fix(monitoreo): resolver visualizacion y ubicacion del segundo collar COW-002 con fallback de potrero y estado GPS
2026-10-09 fix(iot): configurar COW-001 a red celular 4G LTE y evitar difusion cruzada de comandos MQTT
2026-10-14 feat(3d-design): agregar modelado 3D de Collar Halter V2, capsulas IP67 y probetas de prueba rapida
    - Diseno parametrico OpenSCAD del collar dorsal ergonomico en TPU (puente_dorsal_cowai)
    - Capsulas simetricas para LilyGO T-SIM7670G y bateria 21700 con tapas solares
    - Sistema de anclaje deslizante sin tornillos con cuñas de retencion y labio elastico
    - Probetas de validacion rapida en probetas_stl (bolsillo TPU, cuello rigido, click IP67)
    - Modelos STL, proyectos 3MF, renders pedagogicos y documentacion README
2026-10-16 fix(branding): colocar nombre de marca todo en mayúscula COWAI
2026-10-17 feat(3d-design): actualizar proyecto 3MF de impresion TPU del puente y agregar modelado 3D del logo COWAI
    - Actualizar diseno_halter_v2/puente_dorsal_cowai.3mf con parametros verificados de Bambu Studio (3 paredes, 15% giroide, soportes arbol solo en cama y flujo 4.0 mm3/s).
    - Agregar logo_3d_cow_ai con letras 3D, cuadrantes de cabeza de vaca, pines de ensamble y plantilla de montaje de 120 cm.
2026-10-18 security(vps): restringir y eliminar datos de conexion y credenciales del VPS del repositorio
2026-10-19 security(isolation): restringir ramas de colaboradores a entorno local sin acceso al VPS ni topicos MQTT de produccion
2026-10-19 chore(lock): congelar y blindar inmutablemente el diseno definitivo del puente dorsal COWAI V2
2026-10-27 feat(3d-design): actualizar diseno halter v2 con nuevas pcbs, visor 3d interactivo y adaptador de 28mm
2026-10-29 feat(hardware): paquete completo de diseno electronico PCB v2/v3, esquematicos y planos de cotizacion
2026-11-03 feat(cad,pcb): agregar Halter_V2_Nuevo_Modelo (85x85mm + puente orientado a cama) y paquete PCBA CollarNet V3 70x70
2026-11-09 docs(pcb): actualizar documentacion de PCBA CollarNet V3, planos maestros CAD pin a pin, diagramas de pistas y visores 3D interactivos
2026-11-09 fix(main): restaurar configuracion oficial de produccion cowai.net tras merge 3D de david
